Ahmeddiab1/TRI-MD_EVAL/1-HARDWARE/1-MD_EVAL/4-GENERATED/VALIDATION/DiffReport/ESC_GaN_CTRL.html

Altium

# Differences Report for Project ESC_CTRL.PrjPCB and ESC_GaN_CTRL.PcbDoc

Date: | | 5/20/2020
Time: | | 4:16:36 PM
Filename: | | C:\Users\TOWER_HOME\Documents\GitHub\TRI_ESC\1-HARDWARE\2-ESC_CTRL\4-GENERATED\VALIDATION\DiffReport\ESC_GaN_CTRL.html

## Extra Room Definitions

Schematic Object | PCB Object
[Room 1-MAIN (Scope=InComponentClass('1-MAIN')) TopLayer]
[Room U_2-BUCK_3V3_MCU (Scope=InComponentClass('U_2-BUCK_3V3_MCU')) TopLayer]
[Room U_3-MCU (Scope=InComponentClass('U_3-MCU')) TopLayer]
[Room U_4-JTAG (Scope=InComponentClass('U_4-JTAG')) TopLayer]
[Room U_5-CAN_TRANSCEIVER (Scope=InComponentClass('U_5-CAN_TRANSCEIVER')) TopLayer]
[Room U_6-MAVLINK_TRANSCEIVER (Scope=InComponentClass('U_6-MAVLINK_TRANSCEIVER')) TopLayer]
[Room U_7-CONNECTORS (Scope=InComponentClass('U_7-CONNECTORS')) TopLayer]
[Room U_8-MECHANICALS (Scope=InComponentClass('U_8-MECHANICALS')) TopLayer]
[Room U_11-PWM_INTERLOCK1 (Scope=InComponentClass('U_11-PWM_INTERLOCK1')) TopLayer]
[Room U_11-PWM_INTERLOCK2 (Scope=InComponentClass('U_11-PWM_INTERLOCK2')) TopLayer]
[Room U_11-PWM_INTERLOCK3 (Scope=InComponentClass('U_11-PWM_INTERLOCK3')) TopLayer]

Back to top

## Different Component Parameters

Schematic Object | PCB Object
[C1] | [C1]
[C1_U] | [C1_U]
[C1_V] | [C1_V]
[C1_W] | [C1_W]
[C2] | [C2]
[C2_U] | [C2_U]
[C2_V] | [C2_V]
[C2_W] | [C2_W]
[C3] | [C3]
[C3_U] | [C3_U]
[C3_V] | [C3_V]
[C3_W] | [C3_W]
[C4] | [C4]
[C5] | [C5]
[C6] | [C6]
[C7] | [C7]
[C8] | [C8]
[C9] | [C9]
[C10] | [C10]
[C11] | [C11]
[C12] | [C12]
[C13] | [C13]
[C14] | [C14]
[C15] | [C15]
[C16] | [C16]
[C17] | [C17]
[C18] | [C18]
[C19] | [C19]
[C20] | [C20]
[C21] | [C21]
[C22] | [C22]
[C23] | [C23]
[C24] | [C24]
[C25] | [C25]
[C26] | [C26]
[FB1] | [FB1]
[FB2] | [FB2]
[R1] | [R1]
[R1_U] | [R1_U]
[R1_V] | [R1_V]
[R1_W] | [R1_W]
[R2] | [R2]
[R3] | [R3]
[R4] | [R4]
[R5] | [R5]
[R6] | [R6]
[R7] | [R7]
[R8] | [R8]
[R9] | [R9]
[R10] | [R10]
[R11] | [R11]
[R12] | [R12]
[R13] | [R13]
[R14] | [R14]
[R15] | [R15]
[R16] | [R16]
[R17] | [R17]
[R18] | [R18]
[R19] | [R19]
[R20] | [R20]
[R21] | [R21]
[R22] | [R22]
[R23] | [R23]
[R24] | [R24]
[Rtr1] | [Rtr1]
[Rtr2] | [Rtr2]
[Rtr3] | [Rtr3]

Back to top
