Ahmeddiab1/TRI-MD_EVAL/1-HARDWARE/1-MD_EVAL/4-GENERATED/MANUFACTURE/Report Board Stack/ESC_GaN_CTRL.xls

Board Stack Report
Stack Up |  | Layer Stack
Layer | Board Layer Stack | Name | Material | Thickness | Constant
1 |  | Top Paste
2 |  | Top Overlay
3 |  | Top Solder | Solder Resist | 0.010mm | 3.5
4 |  | TOP_SIG_L1 | Copper | 0.035mm
5 |  | Dielectric1 | FR-4 | 0.127mm | 4.2
6 |  | TOP_GND_L2 | Copper | 0.035mm
7 |  | Dielectric 9 | FR-4 | 0.127mm | 4.2
8 |  | MID_PWR_L3 | Copper | 0.035mm
9 |  | Dielectric 8 | FR-4 | 0.254mm | 4.2
10 |  | MID_PWR_L4 | Copper | 0.035mm
11 |  | Dielectric 10 | FR-4 | 0.127mm | 4.2
12 |  | BOT_GND_L5 | Copper | 0.035mm
13 |  | Dielectric 2 | FR-4 | 0.127mm | 4.2
14 |  | BOT_SIG_L6 | Copper | 0.035mm
15 |  | Bottom Solder | Solder Resist | 0.010mm | 3.5
16 |  | Bottom Overlay
17 |  | Bottom Paste
 | Height : 0.992mm
