Ahmeddiab1/TRI-MD_EVAL/1-HARDWARE/1-MD_EVAL/0-ANNEXE/PIN_ASSIGNEMENT.PNG

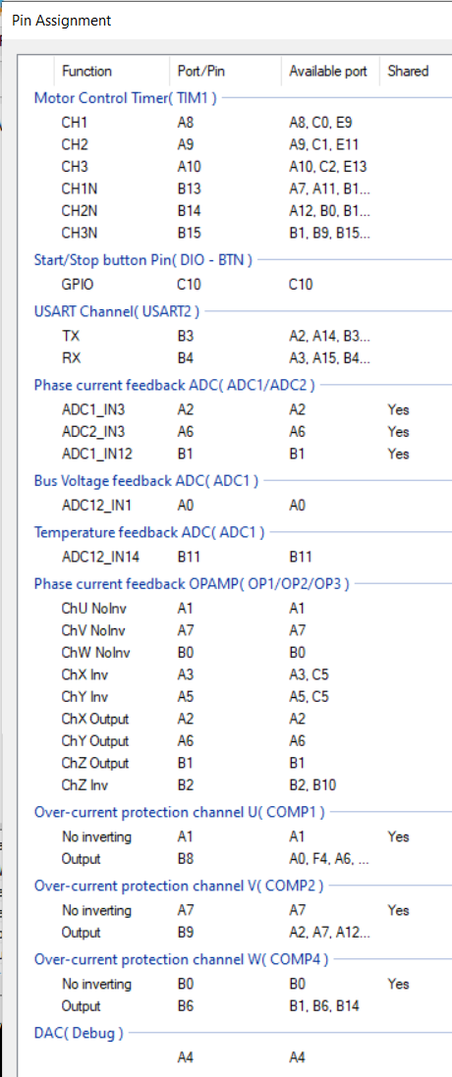
1-HARDWARE/1-MD_EVAL/0-ANNEXE/PIN_ASSIGNEMENT.PNG
