Ahmeddiab1/TRI-MD_EVAL/2-SOFTWARE/8-LOGICIEL/STSW-ESC001V1/ESC_STM32_FOC_FW/Web/MCLibrary/interface/common/1254211595.jpg

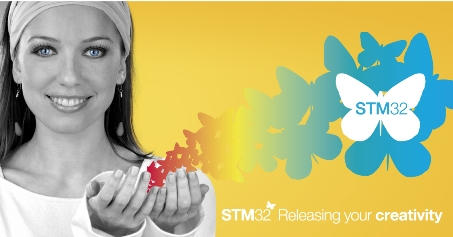
2-SOFTWARE/8-LOGICIEL/STSW-ESC001V1/ESC_STM32_FOC_FW/Web/MCLibrary/interface/common/1254211595.jpg
