Ahmeddiab1/TRI-MD_EVAL/2-SOFTWARE/8-LOGICIEL/STSW-ESC001V1/ESC_STMotorProfiler_addon/resources/assets/boardConfigs/images/STEVAL-ESC001V1_CB.png

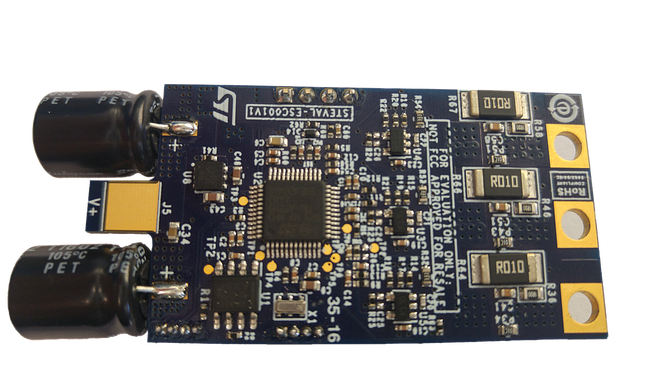
2-SOFTWARE/8-LOGICIEL/STSW-ESC001V1/ESC_STMotorProfiler_addon/resources/assets/boardConfigs/images/STEVAL-ESC001V1_CB.png
