Ahmeddiab1/TRI-MD_EVAL/2-SOFTWARE/8-LOGICIEL/STSW-ESC001V1/ESC_STMotorProfiler_addon/resources/assets/images/control/en_image_steval-ihm039v1.png

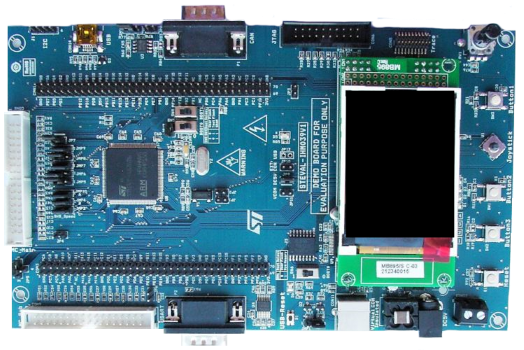
2-SOFTWARE/8-LOGICIEL/STSW-ESC001V1/ESC_STMotorProfiler_addon/resources/assets/images/control/en_image_steval-ihm039v1.png
