Ahmeddiab1/TRI-MD_EVAL/5-RESEARCH/3-SNIPPET/ESC_CTRL/hw/doc/png/PCB_00_RevA_3D.png

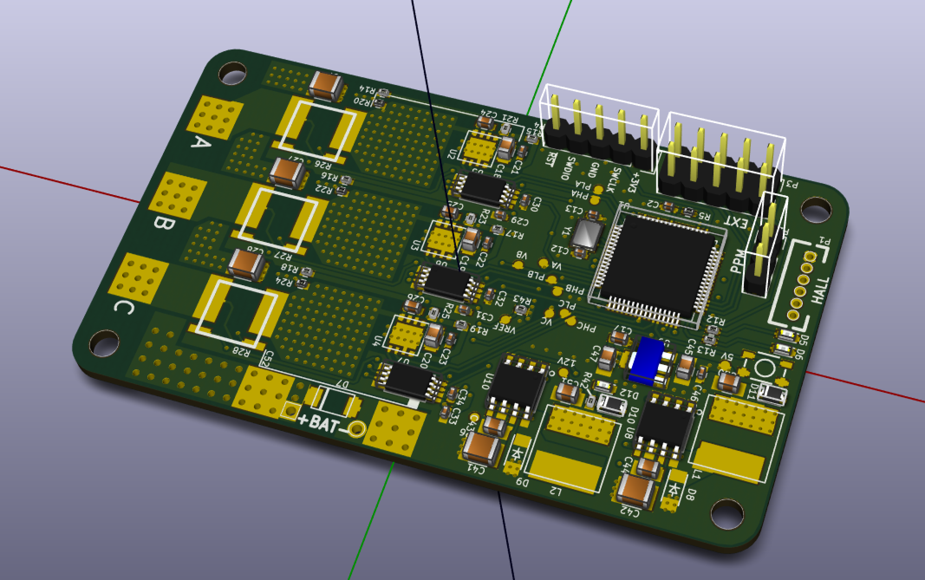
5-RESEARCH/3-SNIPPET/ESC_CTRL/hw/doc/png/PCB_00_RevA_3D.png
