Ahmeddiab1/TRI-MD_EVAL/1-HARDWARE/1-MD_EVAL/4-GENERATED/MANUFACTURE/BOM/BOM-ESC_CTRL.xlsx

Sheet: Part List Report
 | Component list |  | BOM for Project [ESC_CTRL.PrjPCB] (PCB Document : ESC_GaN_CTRL.PcbDoc)
 | Source Data From: |  | ESC_CTRL.PrjPCB
 | Project: |  | ESC_CTRL.PrjPCB
 | Variant: |  | None
 | Report Date: | 5/20/2020 | 3:45 PM
 | Print Date: | 2020-05-20 | 15:45:51
# | Designator | Supplier Part Number 1 | Quantity | Value | #Column Name Error:' Voltage | Footprint | Supplier 1 | #Column Name Error:' Fitted | Price
1 | B1, B2 | EG4389CT-ND | 2 |  |  | BUTTON_SINGLE_SIDE | Digi-Key
2 | CMC1 | 445-2033-2-ND | 1 |  |  | CMC_1210 | Digi-Key
3 | D1, D4, D5 | 160-1183-1-ND | 3 |  |  | LED 0603 | Digi-Key
4 | D1_U, D1_V, D1_W | 1497-1174-1-ND | 3 |  |  | LED 0402 | Digi-Key
5 | D2 | 732-4999-6-ND | 1 |  |  | LED_4PINS | Digi-Key
6 | D3 | 497-5550-1-ND | 1 |  |  | SOT323_3_0.8_2.9 | Digi-Key
7 | J1 | 952-2262-ND | 1 |  |  | PHT-102-01-S-S | Digi-Key
8 | J5, J6 | H126464-ND | 2 |  |  | DF13C-4P-1.25V | Digi-Key
9 | J7, J8, J9 | 609-3706-1-ND | 3 |  |  | FLE-105-01-G-DV | Digi-Key
10 | Q1 | 644-1321-1-ND | 1 |  |  | QUARTZ_1 | Digi-Key
11 | TVS1 | 497-15333-1-ND | 1 |  |  | SOT23_3_0.95_1.6 | Digi-Key
12 | TVS2 | CM1213-06MROSDKR-ND | 1 |  |  | MSOP_8_0.65_3.0 | Digi-Key
13 | U1 | 296-LMZM23600V3SILRCT-ND | 1 |  |  | MICROSIP-10 | Digi-Key
14 | U1_U, U1_V, U1_W | 296-18803-1-ND | 3 |  |  | DSBGA-6 | Digi-Key
15 | U2 | 296-11654-6-ND | 1 |  |  | SOIC-8_1.27_4 | Digi-Key
16 | U2_U, U2_V, U2_W | 296-18799-1-ND | 3 |  |  | DSBGA-8 | Digi-Key
17 | U3_U, U3_V, U3_W | 296-18803-1-ND | 3 |  |  | DSBGA-8 | Digi-Key
18 | U4 | 296-SN74LVC2G32YZPRCT-ND | 1 |  |  | DSBGA-8 | Digi-Key
19 | U5 | 497-STM32G474VEH6-ND | 1 |  |  | TFBGA-100 | Digi-Key
20 | U6 | 497-19072-1-ND | 1 |  |  | QFN8_2_2 | Digi-Key
21 | U7 | LM3480IM3X-3.3/NOPBCT-ND | 1 |  |  | SOT23_3_0.95_1.6 | Digi-Key
22 | C1, C3, C5, C8, C9, C10, C11, C21 | C0805 2.2nF 50V X7R SAMSUNG | 8 | 2.2uF |  | C 0805(2012)x0.65 | Comet |  | 0.026
23 | C1_U, C1_V, C1_W, C2_U, C2_V, C2_W, C3_U, C3_V, C3_W, C6, C7, C12, C13, C14, C15, C18, C19, C22, C23, C24 | C0402 100nF 50V X7R | 20 | 100nF |  | C 0402(1005)x0.5 | Comet |  | 0.039
24 | C2 | CE 10uF 50V SMD 105C Fujicon | 1 | 10uF |  | EL SMD D5 h5.4 | Comet |  | 0.106
25 | C4 | C1206 4.7uF 50V X7R SAMSUNG | 1 | 4.7uF |  | C 1206(3216)x1.6 | Comet |  | 0.29
26 | C16, C17, C20, C25, C26 | C0402 100nF 50V X7R | 5 | 47pF |  | C 0402(1005)x0.5 | Comet |  | 0.039
27 | FB1, FB2 | BLM21PG331SN1D | 2 | 0.525u |  | FB 0805(2012) | Comet |  | 0.032
28 | R1, R1_U, R1_V, R1_W, R8, R9, R16, R17 | R0402 1.0K 1% YAG/ASJ | 8 | 330 |  | R 0402(1005)-1% | Comet |  | 0.015
29 | R2, R3, R4, R5, R7, R10, R18, R19, R20, R21, R23, R24 | R0402 1.0K 1% YAG/ASJ | 12 | 100K |  | R 0402(1005)-1% | Comet |  | 0.015
30 | R6 | R0402 1.0K 1% YAG/ASJ | 1 | 120 |  | R 0402(1005)-1% | Comet |  | 0.015
31 | R11, R14, R15 | R0402 1.0K 1% YAG/ASJ | 3 | 1K |  | R 0402(1005)-1% | Comet |  | 0.015
32 | R12, R13 | R0402 1.0K 1% YAG/ASJ | 2 | 10K |  | R 0402(1005)-1% | Comet |  | 0.015
33 | R22 | R0402 1.0K 1% YAG/ASJ | 1 | 100 |  | R 0402(1005)-1% | Comet |  | 0.015
34 | Rtr1, Rtr2, Rtr3 | TC33X-2 1K | 3 | 10K |  | Rtr SMD3 | Comet |  | 0.23
Approved |  |  | Notes |  |  |  |  |  | 102

Sheet: Project Information
Column1 | Column2
Project Full Path | C:\Users\TOWER_HOME\Documents\GitHub\TRI_ESC\1-HARDWARE\2-ESC_CTRL\ESC_CTRL.PrjPCB
Project Filename | ESC_CTRL.PrjPCB
Variant Name | None
Data-Source Filename | ESC_CTRL.PrjPCB
Data-Source Full Path | C:\Users\TOWER_HOME\Documents\GitHub\TRI_ESC\1-HARDWARE\2-ESC_CTRL\ESC_CTRL.PrjPCB
Title | BOM for Project [ESC_CTRL.PrjPCB] (PCB Document : ESC_GaN_CTRL.PcbDoc)
Total Quantity | 102
Report Time | 3:45 PM
Report Date | 5/20/2020
Report Date & Tine | 5/20/2020 3:45 PM
Output Name | BOM
Output Type | BOM_PartType
Output Generator Name | BOM
Output Generator Description | Bill of Materials
