Ahmeddiab1/TRI-MD_EVAL/1-HARDWARE/1-MD_EVAL/4-GENERATED/PROD/BOM/BOM_ESC_CTRL.xlsx

Designator | Supplier Part Number 1 | Quantity | Value | Manufacturer Number | Footprint | Supplier 1 | Fitted | UNI NOTES ONLY
B1, B2 | EG4389CT-ND | 2 |  | TL3330AF260QG | BUTTON_SINGLE_SIDE | Digi-Key |  | CHECKED
CMC1 | 445-2033-2-ND | 1 |  | ACM3225-102-2P-T001 | CMC_1210 | Digi-Key |  | CHECKED
D1, D4, D5 | 160-1183-1-ND | 3 |  | LTST-C190GKT | LED 0603 | Digi-Key | DNP | CHECKED
D1_U, D1_V, D1_W | 1497-1174-1-ND | 3 |  | XZMDK68W-2 | LED 0402 | Digi-Key |  | CHECKED
D2 | 732-4999-6-ND | 1 |  | 150141RB73100 | LED_4PINS | Digi-Key |  | CHECKED
D3 | 497-5550-6-ND | 1 |  | BAT30CWFILM | SOT323_3_0.8_2.9 | Digi-Key |  | CHECKED
J1 | 952-2262-ND | 1 |  | M20-9990246 | PHT-102-01-S-S | Digi-Key | DNP | CHECKED
J5, J6 | H126464-ND | 2 |  | DF13C-4P-1.25V(75) | DF13C-4P-1.25V | Digi-Key | DNP | CHECKED
J7, J8, J9 | 609-3706-1-ND | 3 |  | 20021321-00010C4LF | FLE-105-01-G-DV | Digi-Key | DNP | CHECKED
Q1 | SER4252DKR-ND | 1 |  | FA-238 24.0000MD30X-W5 | QUARTZ_1 | Digi-Key |  | CHECKED
TVS1 | 497-15333-6-ND | 1 |  | ESDCAN01-2BLY | SOT23_3_0.95_1.6 | Digi-Key |  | CHECKED
TVS2 | CM1213-06MROSDKR-ND | 1 |  | CM1213-06MR | MSOP_8_0.65_3.0 | Digi-Key |  | CHECKED
U1 | 296-LMZM23600V3SILRDKR-ND | 1 |  | LMZM23600V3SILR | MICROSIP-10 | Digi-Key |  | CHECKED
U1_U, U1_V, U1_W | 296-18803-6-ND | 3 |  | SN74LVC2G14YZPR | DSBGA-6 | Digi-Key |  | CHECKED
U2 | 296-11654-6-ND | 1 |  | SN65HVD230DR | SOIC-8_1.27_4 | Digi-Key |  | CHECKED
U2_U, U2_V, U2_W | 296-18799-6-ND | 3 |  | SN74LVC2G02YZPR | DSBGA-8 | Digi-Key |  | CHECKED
U3_U, U3_V, U3_W | 296-14371-6-ND | 3 |  | SN74LVC2G08YZPR | DSBGA-8 | Digi-Key |  | CHECKED
U4 | 296-SN74LVC2G32YZPRCT-ND | 1 |  | SN74LVC2G32YZPR | DSBGA-8 | Digi-Key |  | CHECKED
U5 | 497-STM32G474VEH6-ND | 1 |  | STM32G474VEH6 | TFBGA-100 | Digi-Key |  | CHECKED
U6 | 497-19072-1-ND | 1 |  | TS3333AQPR | QFN8_2_2 | Digi-Key |  | CHECKED
U7 | LM3480IM3X-3.3/NOPBCT-ND | 1 |  | LM3480IM3X-3.3/NOPB | SOT23_3_0.95_1.6 | Digi-Key |  | CHECKED
C1, C5, C8, C9, C10, C11, C21 | 399-11941-6-ND | 8 | 2.2uF | C0805C225K3RAC7800 | C 0805(2012)x0.65 | Digi-Key |  | CHECKED
C1_U, C1_V, C1_W, C2_U, C2_V, C2_W, C3_U, C3_V, C3_W, C6, C7, C12, C13, C14, C15, C18, C19, C22, C23, C24 | 1276-1004-6-ND | 20 | 100nF | CL05F104ZO5NNNC | C 0402(1005)x0.5 | Digi-Key |  | CHECKED
C2 | 565-2129-6-ND (https://www.digikey.com/product-detail/en/united-chemi-con/EMVA500ADA100ME55G/565-2129-6-ND/1959446) | 1 | 10uF | EMVA500ADA100ME55G | EL SMD D5 h5.4 | Digi-Key |  | CHECKED
C3 | 399-4925-6-ND | 1 | 10uF | C0805C106K8PACTU | C 0805(2012)x0.65 | Digi-Key |  | CHECKED
C4 | 399-12290-6-ND | 1 | 22uF | C1206C226M4PAC7800 | C 1206(3216)x1.6 | Digi-Key |  | CHECKED
C16, C17, C20, C25, C26 | 490-5942-6-ND | 5 | 47pF | GRM1555C1H470JA01D | C 0402(1005)x0.5 | Digi-Key |  | CHECKED
FB1, FB2 | BLM21PG331SN1D | 2 | 0.525u | BLM21PG331SN1D | FB 0805(2012) | Digi-Key |  | CHECKED
R1, R1_U, R1_V, R1_W, R8, R9, R16, R17 | A130349DKR-ND | 8 | 330 | CRGP0402F330R | R 0402(1005)-1% | Digi-Key |  | CHECKED
R2, R3, R4, R5, R7, R10, R18, R19, R20, R21, R23, R24 | 311-100KLRDKR-ND | 12 | 100K | RC0402FR-07100KL | R 0402(1005)-1% | Digi-Key |  | CHECKED
R6, R22 | 2019-RK73H1ETTP1200FDKR-ND | 2 | 120 | RK73H1ETTP1200F | R 0402(1005)-1% | Digi-Key |  | CHECKED
R11, R14, R15 | A129627DKR-ND | 3 | 1K | CRGCQ0402F1K0 | R 0402(1005)-1% | Digi-Key |  | CHECKED
R12, R13 | 541-3959-6-ND | 2 | 10K | CRCW040210K0FKEDC | R 0402(1005)-1% | Digi-Key |  | CHECKED
Rtr1, Rtr2, Rtr3 | TC33X-2-504EDKR-ND | 3 | 500K | TC33X-2-504E | Rtr SMD3 | Digi-Key |  | CHECKED
