Ahmeddiab1/TRI-MD_EVAL/1-HARDWARE/1-MD_EVAL/4-GENERATED/PROD/ReportComponents/COMPONENT_CROSS_REF.xlsx

Comment | Description | Designator | Footprint | LibRef | Quantity
PHT-102-01-S-S | MAL 2 PIN 2.54 SINGLE ROW | J1 | PHT-102-01-S-S | PHT-102-01-S-S | 1
2.2uF, 10uF, 22uF, LED 0603, 330, MICROSIP | SMD-0805 50V X7R 10%, SMD D5mm h5.4mm, SMD-1206 50V X7R 10%, LED SMD 0603, SMD 0402 0.063W 1% 50V, V3 DCDC 3V3 500mA | C1, C2, C3, C4, D1, R1, U1 | C 0805(2012)x0.65, EL SMD D5 h5.4, C 1206(3216)x1.6, LED 0603, R 0402(1005)-1%, MICROSIP-10 | CAP 0805 2.2nF 50V X7R, EL 10uF 50V +105°C, CAP 1206 4.7uF 50V X7R, LED 0603, RES 0402-1%, LMZM23600 | 7
PUSH BUTT SINGLE SIDE, 100nF, 2.2uF, 47pF, LED 0603, 0.525u, OSC NX2016, 100K, 1K, 10K, 330, 120, DSBGA8, STM32 TFBGA 100, QFN8, SOT23 | BUTTON SINGLE SIDE SMD, SMD-0402 100nF 50V X7R 10%, SMD-0805 50V X7R 10%, LED SMD 0603, SMD 0805 1.5A 330Ω/90mΩ, OSC NX2016 24MHz, SMD 0402 0.063W 1% 50V, SMD Trimpot 3mm 0.1W 25%, OR DUAL, TFBGA100, REF VOLTAGE 3V3 -- DETROMPEUR WRONG DIRECTION, LDO 3V3 VIN 35V | B1, B2, C7, C8, C9, C10, C11, C12, C13, C14, C15, C16, C17, C18, C19, C20, C21, C22, C23, C24, C25, C26, D4, D5, FB1, FB2, Q1, R10, R11, R12, R13, R14, R15, R16, R17, R18, R19, R20, R21, R22, R23, R24, Rtr1, Rtr2, Rtr3, U4, U5, U6, U7 | BUTTON_SINGLE_SIDE, C 0402(1005)x0.5, C 0805(2012)x0.65, LED 0603, FB 0805(2012), QUARTZ_1, R 0402(1005)-1%, Rtr SMD3, DSBGA-8, TFBGA-100, QFN8_2_2, SOT23_3_0.95_1.6 | PUSH BUTT SINGLE SIDE, CAP 0402 100nF 50V X7R, CAP 0805 2.2nF 50V X7R, LED 0603, FB BLM21P, OSC NX2016, RES 0402-1%, RES Trim TC33X-2, SN74LVC2G32_BGA, STM32G474VEH6, TS33, LM3480 | 49
100K | SMD 0402 0.063W 1% 50V | R2, R3, R4, R5 | R 0402(1005)-1% | RES 0402-1% | 4
2.2uF, 100nF, TCM0403S, DF13C-4P-1.25V, 120, 100K, SOT23, SOIC8 | SMD-0805 50V X7R 10%, SMD-0402 100nF 50V X7R 10%, CMC 200mA 1K @100MHz 1210, HEADER MALE 4P 1.25 PITCH UP RIGHT, SMD 0402 0.063W 1% 50V, TVS CAN PROTECT, CAN TRANSCIEVER | C5, C6, CMC1, J5, R6, R7, TVS1, U2 | C 0805(2012)x0.65, C 0402(1005)x0.5, CMC_1210, DF13C-4P-1.25V, R 0402(1005)-1%, SOT23_3_0.95_1.6, SOIC-8_1.27_4 | CAP 0805 2.2nF 50V X7R, CAP 0402 100nF 50V X7R, TCM0403S, DF13C-4P-1.25V, RES 0402-1%, ESDCAN01, SN65HVD230 | 8
PLCC, DF13C-4P-1.25V, 330 | BI COLOR LED BLUE-RED, HEADER MALE 4P 1.25 PITCH UP RIGHT, SMD 0402 0.063W 1% 50V | D2, J6, R8, R9 | LED_4PINS, DF13C-4P-1.25V, R 0402(1005)-1% | LED BICOLOR, DF13C-4P-1.25V, RES 0402-1% | 4
SOD523, FLE-105-G-DV, MSOP8 | SCHOTTKY 30V 300mA DUAL COMMON CATHODE, FEM 10 PIN 1.27 DOUBLE ROW SMD, TVS STERRING ARRAY | D3, J7, J8, J9, TVS2 | SOT323_3_0.8_2.9, FLE-105-01-G-DV, MSOP_8_0.65_3.0 | BAT30_DUAL, FLE-105-G-DV, CM1213 | 5
100nF, 0402, 330, DSGBA6, DSBGA8, DSGBA8 | SMD-0402 100nF 50V X7R 10%, LED SMD 0402, SMD 0402 0.063W 1% 50V, INV DUAL SCHMITT, NOR DUAL, AND DUAL SCHMITT | C1_U, C1_V, C1_W, C2_U, C2_V, C2_W, C3_U, C3_V, C3_W, D1_U, D1_V, D1_W, R1_U, R1_V, R1_W, U1_U, U1_V, U1_W, U2_U, U2_V, U2_W, U3_U, U3_V, U3_W | C 0402(1005)x0.5, LED 0402, R 0402(1005)-1%, DSBGA-6, DSBGA-8 | CAP 0402 100nF 50V X7R, LED 0402, RES 0402-1%, SN74LVC2G14_BGA, SN74LVC2G02_BGA, SN74LVC2G08_BGA | 24
