Ahmeddiab1/TRI-MD_EVAL/5-RESEARCH/1-EVM/ESC_G431/MB1419-G431CB-B01_BOM.xlsx

 |  | PROJECT NAME: PROT-ESC-G4 |  |  |  |  |  | POW CODE: | MC.3PH0055.17 | 2018-11-23
 |  | Schematic ver. 021 |  | BILL OF MATERIALS
 |  |  |  |  |  | MANUFACTURER |  | Supplier Advices-Not Mandatory |  | MORE INFO
ITEM | QUANTITY | Reference | Part / Value | GLOBAL INFORMATION | Package | Manufacturer | Manufacturer’s ordering code / Orderable Part Number | SUPPLIER - DISTRIBUTOR | SUPPLIER - DISTRIBUTOR CODE | In the Items indicated with "ANY" you can use any Manufacturer | Provided by | ECCN_US | ECCN_EU
1 | 15 | C1 C2 C3 C4 C5 C9 C13 C17 C18 C20 C21 C22 C23 C24 C70 | 0.1uF | CAP CER 0.1UF 16V X7R 0402 | 0402 (1005 Metric) | Wurth Electronics Inc. | 885012205037 | Digi-Key | 732-7532-2-ND | ANY | SUBCO | NA | NA
2 | 1 | C6 | 10uF | CAP CER 10UF 16V X5R 0805 | 0805 (2012 Metric) | Wurth Electronics Inc. | 885012107014 | Digi-Key | 732-7624-1-ND | ANY | SUBCO | NA | NA
3 | 1 | C7 | 4.7uF | CAP CER 4.7UF 16V X5R 0805 | 0805 (2012 Metric) | Wurth Electronics Inc. | 885012107013 | Digi-Key | 732-7623-1-ND | ST-SUPPLY | SUBCO with ST control | NA | NA
4 | 1 | C8 | 100pF | CAP CER 100PF 10V C0G/NP0 0402 | 0402 (1005 Metric) | Wurth Electronics Inc. | 885012005013 | Digi-Key | 732-7431-1-ND | ANY | SUBCO | NA | NA
5 | 5 | C10 C11 C67 C68 C69 | 10pF | CAP CER 10PF 10V C0G/NP0 0402 | 0402 (1005 Metric) | Wurth Electronics Inc. | 885012005007 | Digi-Key | 732-7425-1-ND | ST-SUPPLY | SUBCO with ST control | NA | NA
6 | 1 | C12 | N.M. | CAP CER 0402-NOT MOUNTED | 0402 (1005 Metric) | NOT ASSEMBLY | NOT ASSEMBLY |  |  | NOT ASSEMBLY |  | NA | NA
7 | 2 | C14 C16 | 1 uF | CAP CER 1UF 16V X5R 0603 | 0603 (1608 Metric) | Yageo | CC0603KRX5R7BB105 | Digi-Key | 311-1444-1-ND |  | SUBCO | NA | NA
8 | 1 | C15 | 0.1uF | CAP CER 0.1UF 16V X7R 0603 | 0603 (1608 Metric) | Wurth Electronics Inc. | 885012206046 | Digi-Key | 732-7965-1-ND | ANY | SUBCO | NA | NA
9 | 1 | C19 | 4.7uF | CAP CER 4.7UF 10V X5R 0603 | 0603 (1608 Metric) | Wurth Electronics Inc. | 885012106012 | Digi-Key | 732-7909-1-ND | ANY | SUBCO | NA | NA
10 | 3 | C25 C56 C63 | 1uF | CAP CER 1UF 25V X5R 0402 | 0402 (1005 Metric) | Murata Electronics North America | GRM155R61E105KA12D | Digi-Key | 490-10017-1-ND |  | SUBCO | NA | NA
11 | 1 | C26 | 10nF | CAP CER 10000PF 16V X7R 0402 | 0402 (1005 Metric) | Wurth Electronics Inc. | 885012205031 | Digi-Key | 732-7526-1-ND | ANY | SUBCO | NA | NA
12 | 14 | C27 C28 C29 C30 C31 C32 C33 C34 C35 C36 C37 C38 C39 C40 | 15uF | CAP CER 15UF 35V X5R 0805 | 0805 (2012 Metric) | TDK Corporation | C2012X5R1V156M125AC | Digi-Key | 445-14423-2-ND |  | SUBCO | NA | NA
13 | 1 | C41 | 0.22uF | CAP CER 0.22UF 50V X7R 0603 | 0603 (1608 Metric) | TDK Corporation | CGA3E3X7R1H224K080AD | Digi-Key | 445-9837-1-ND |  | SUBCO | NA | NA
14 | 1 | C42 | 3.9nF | CAP CER 3900PF 16V X7R 0402 | 0402 (1005 Metric) | KEMET | C0402C392K4RAC7867 | Digi-Key | 399-14452-1-ND |  | SUBCO | NA | NA
15 | 3 | C43 C52 C58 | 1uF | CAP CER 1UF 25V X7R 0603 | 0603 (1608 Metric) | Wurth Electronics Inc. | 885012206076 | Digi-Key | 732-7994-1-ND | ANY | SUBCO | NA | NA
16 | 1 | C44 | 10uF | CAP CER 10UF 50V X7R 1206 | 1206 (3216 Metric) | Samsung Electro-Mechanics America, Inc. | CL31B106KBHNNNE | Digi-Key | 1276-6767-1-ND |  | SUBCO | NA | NA
17 | 1 | C45 | 22uF | CAP CER 22UF 25V X5R 1206 | 1206 (3216 Metric) | Murata Electronics North America | GRT31CR61E226ME01L | Digi-Key | 490-12451-1-ND |  | SUBCO | NA | NA
18 | 1 | C46 | 27pF | CAP CER 27PF 25V C0G/NP0 0402 | 0402 (1005 Metric) | Murata Electronics North America | GRM1555C1E270JA01D | Digi-Key | 490-6176-1-ND |  | SUBCO | NA | NA
19 | 6 | C47 C48 C53 C54 C60 C61 | 100pF | CAP CER 100PF 25V X7R 0402 | 0402 (1005 Metric) | Wurth Electronics Inc. | 885012205038 | Digi-Key | 732-7533-1-ND | ANY | SUBCO | NA | NA
20 | 3 | C49 C55 C62 | 470nF | CAP CER 0.47UF 25V X7R 0603 | 0603 (1608 Metric) | Wurth Electronics Inc. | 885012206075 | Digi-Key | 732-7993-1-ND | ST-SUPPLY | SUBCO with ST control | NA | NA
21 | 1 | C50 | 4.7nF | CAP CER 4700PF 16V X7R 0402 | 0402 (1005 Metric) | Wurth Electronics Inc. | 885012205029 | Digi-Key | 732-7524-1-ND | ST-SUPPLY | SUBCO with ST control | NA | NA
22 | 3 | C51 C59 C65 | 10nF | CAP CER 10000PF 100V X7R 0603 | 0603 (1608 Metric) | TDK Corporation | C1608X7R2A103M080AA | Digi-Key | 445-1305-1-ND |  | SUBCO | NA | NA
23 | 2 | C57 C64 | 2.2uF | CAP CER 2.2UF 10V X5R 0402 | 0402 (1005 Metric) | Wurth Electronics Inc. | 885012105013 | Digi-Key | 732-7490-1-ND | ANY | SUBCO | NA | NA
24 | 1 | C66 | 10nF | CAP CER 10000PF 10V X7R 0402 | 0402 (1005 Metric) | Wurth Electronics Inc. | 885012205012 | Digi-Key | 732-7507-2-ND | ANY | SUBCO | NA | NA
25 | 1 | D1 | STPS1L20MF | DIODE SCHOTTKY 20V 1A STMITEFLAT | DO-222AA | STMicroelectronics | STPS1L20MF | Digi-Key | 497-8024-1-ND | ST-SUPPLY | SUBCO with ST control | EAR99 | NEC
26 | 1 | D2 | LED GREEN RED | LED GREEN/RED CLEAR 4PLCC SMD | 4-PLCC | Wurth Electronics Inc. | 150141RV73100 | Digi-Key | 732-5001-1-ND | ST-SUPPLY | SUBCO with ST control | EAR99 | NEC
27 | 2 | D3 D5 | LNJ347W83RA | LED GREEN 0402 SMD | 0402 (1005 Metric) | Panasonic Electronic Components | LNJ347W83RA | Digi-Key | LNJ347W83RATR-ND |  | SUBCO | EAR99 | NEC
28 | 1 | D4 | LED RED | DIO, Rectangle with Flat Top, 1.00mm x 0.50mm, VLMS1500-GS08, 20mA, --, --, 0402 (1005 Metric) | 0402 (1005 Metric) | Vishay Semiconductor Opto Division | VLMS1500-GS08 | Digi-Key | VLMS1500-GS08TR-ND |  | SUBCO | EAR99 | NEC
29 | 3 | D6 D8 D9 | STPS0560Z | DIODE SCHOTTKY 60V 500MA SOD123 | SOD-123 | STMicroelectronics | STPS0560Z | Digi-Key | 497-3787-1-ND | ST-SUPPLY | SUBCO with ST control | EAR99 | NEC
30 | 1 | D7 | STPS1L40M | DIODE SCHOTTKY 40V 1A STMITE | DO-216AA | STMicroelectronics | STPS1L40M | Digi-Key | 497-3212-1-ND | ST-SUPPLY | SUBCO with ST control | EAR99 | NEC
31 | 10 | D10 D11 D12 D13 D14 D15 D16 D17 D18 D19 | BAT30KFILM | DIODE SCHOTTKY 30V 300MA SOD523 | SC-79, SOD-523 | STMicroelectronics | BAT30KFILM | Digi-Key | 497-5552-2-ND | ST-SUPPLY | SUBCO with ST control | EAR99 | NEC
32 | 1 | D20 | SMM4F26A | 400 W TVS in STmite Flat | DO216-AA-FLAT | STMicroelectronics | SMM4F26A-TR | Mouser | 511-SMM4F26A-TR | ST-SUPPLY | SUBCO with ST control | EAR99 | NEC
32 | 1 | F1 | 250mA | FUSE BOARD MNT 250MA 32VDC 0402 | 0.039" L x 0.020" W x 0.013" H (0.99mm x 0.51mm x 0.33mm) | Littelfuse Inc. | 0435.250KRS | Digi-Key | F3785CT-ND |  | SUBCO | EAR99 | NEC
33 | 1 | J1 | CAN | SOLDER PADS |  |  |  |  |  | NOT ASSEMBLY |  | NA | NA
34 | 1 | J2 | SWD STLINK | SOLDER PADS |  |  |  |  |  | NOT ASSEMBLY |  | NA | NA
35 | 1 | J3 | PWM | SOLDER PADS |  |  |  |  |  | NOT ASSEMBLY |  | NA | NA
36 | 1 | J4 | SWD-PAD | SOLDER PADS |  |  |  |  |  | NOT ASSEMBLY |  | NA | NA
37 | 1 | J5 | CON1 | SOLDER PADS |  |  |  |  |  | NOT ASSEMBLY |  | NA | NA
38 | 1 | J6 | CON1 | SOLDER PADS |  |  |  |  |  | NOT ASSEMBLY |  | NA | NA
39 | 1 | J7 | Motor | SOLDER PADS |  |  |  |  |  | NOT ASSEMBLY |  | NA | NA
40 | 1 | J8 | SOLDER PAD | SOLDER PADS |  |  |  |  |  | NOT ASSEMBLY |  | NA | NA
41 | 3 | JP1 JP2 JP3 | SHORT | 2 PIN SHORTED TO CONNECT DIFFERENT NETS |  |  |  |  |  | NOT ASSEMBLY |  | NA | NA
42 | 1 | L1 | 600 Ohms@100MHz | FERRITE BEAD 600 OHM 0402 1LN | 0402 (1005 Metric) | Murata Electronics North America | BLM15BX601SN1D | Digi-Key | 490-11019-1-ND |  | SUBCO | EAR99 | NEC
43 | 1 | L2 | 33uH | Fixed Inductors LPS4018 Low Profile 33uH 0.8A 20% SMD | 3.9x3.9x1.7 | Coilcraft | LPS4018-333MRB | Mouser | 994-LPS4018-333MRB |  | SUBCO | EAR99 | NEC
44 | 1 | Q1 | 2STR1160 | TRANS NPN 60V 1A SOT-23 | TO-236-3, SC-59, SOT-23-3 | STMicroelectronics | 2STR1160 | Digi-Key | 497-6960-1-ND | ST-SUPPLY | SUBCO with ST control | EAR99 | NEC
45 | 6 | Q2 Q3 Q4 Q5 Q6 Q7 | STL180N6F7 | N-channel 60 V, 1.9 mO typ., 120 A STripFET™ F7 | PowerFLAT 5x6 | STMicroelectronics | STL180N6F7 |  |  | ST-SUPPLY | SUBCO with ST control | EAR99 | NEC
46 | 1 | R1 | 120 | RES SMD 120 OHM 1% 1/16W 0402 | 0402 (1005 Metric) | Yageo | RC0402FR-07120RL | Digi-Key | 311-120LRCT-ND |  | SUBCO | NA | NA
47 | 1 | R2 | 10k | TRIMMER 10K OHM 0.5W PC PIN | Square - 0.375" x 0.375" Face x 0.190" H (9.53mm x 9.53mm x 4.83mm) | Bourns Inc. | 3386P-1-103TLF | Digi-Key | 3386P-103TLF-ND |  | SUBCO | EAR99 | NEC
48 | 15 | R3 R10 R12 R16 R35 R39 R41 R45 R46 R48 R52 R53 R71 R72 R73 | 10k | RES SMD 10K OHM 1% 1/16W 0402 | 0402 (1005 Metric) | Yageo | RC0402FR-0710KL | Digi-Key | 311-10.0KLRTR-ND |  | SUBCO | NA | NA
49 | 5 | R4 R8 R9 R18 R20 | 100 | RES SMD 100 OHM 1% 1/16W 0402 | 0402 (1005 Metric) | TE Connectivity Passive Product | CRG0402F100R | Digi-Key | A121527TR-ND |  | SUBCO | NA | NA
50 | 4 | R5 R67 R69 R70 | 1.5k | RES SMD 1.5K OHM 1% 1/16W 0402 | 0402 (1005 Metric) | Yageo | RC0402FR-071K5L | Digi-Key | 311-1.50KLRTR-ND |  | SUBCO | NA | NA
51 | 1 | R6 | 36k | RES SMD 36K OHM 1% 1/16W 0402 | 0402 (1005 Metric) | Yageo | RC0402FR-0736KL | Digi-Key | 311-36.0KLRCT-ND |  | SUBCO | NA | NA
52 | 3 | R7 R13 R15 | 100k | RES SMD 100K OHM 1% 1/16W 0402 | 0402 (1005 Metric) | TE Connectivity Passive Product | CRG0402F100K | Digi-Key | A121526TR-ND |  | SUBCO | NA | NA
53 | 2 | R11 R26 | 0 | RES SMD 0 OHM JUMPER 1/16W 0402 | 0402 (1005 Metric) | Vishay Dale | CRCW04020000Z0ED | Digi-Key | 541-0.0JTR-ND |  | SUBCO | NA | NA
54 | 1 | R14 | 2.7k | RES SMD 2.7K OHM 1% 1/16W 0402 | 0402 (1005 Metric) | Yageo | RC0402FR-072K7L | Digi-Key | 311-2.70KLRCT-ND |  | SUBCO | NA | NA
55 | 1 | R17 | N.M. | RES SMD 0402 - NOT MOUNTED | 0402 (1005 Metric) |  |  |  |  | NOT ASSEMBLY |  | NA | NA
56 | 4 | R19 R22 R30 R60 | 4.7k | RES SMD 4.7K OHM 1% 1/16W 0402 | 0402 (1005 Metric) | TE Connectivity Passive Product | CRG0402F4K7 | Digi-Key | A121542TR-ND |  | SUBCO | NA | NA
57 | 1 | R21 | 1k | RES SMD 1K OHM 1% 1/16W 0402 | 0402 (1005 Metric) | Yageo | RC0402FR-071KL | Digi-Key | 311-1.00KLRCT-ND |  | SUBCO | NA | NA
58 | 2 | R23 R24 | 0 | RES SMD 0 OHM JUMPER 1/10W 0603 | 0603 (1608 Metric) | Panasonic Electronic Components | ERJ-3GEY0R00V | Digi-Key | P0.0GTR-ND |  | SUBCO | NA | NA
59 | 1 | R27 | 220 | RES SMD 220 OHM 1% 1/16W 0402 | 0402 (1005 Metric) | Yageo | RC0402FR-07220RL | Digi-Key | 311-220LRCT-ND |  | SUBCO | NA | NA
60 | 2 | R28 R29 | 510 | RES SMD 510 OHM 1% 1/16W 0402 | 0402 (1005 Metric) | Yageo | RC0402FR-07510RL | Digi-Key | 311-510LRCT-ND |  | SUBCO | NA | NA
61 | 1 | R31 | 62 | RES SMD 62 OHM 1% 1/16W 0402 | 0402 (1005 Metric) | Yageo | RC0402FR-0762RL | Digi-Key | 311-62.0LRCT-ND |  | SUBCO | NA | NA
62 | 1 | R32 | 34.8k | RES SMD 34.8K OHM 1% 1/16W 0402 | 0402 (1005 Metric) | Yageo | RC0402FR-0734K8L | Digi-Key | YAG3125CT-ND |  | SUBCO | NA | NA
63 | 1 | R33 | 300 | RES SMD 300 OHM 1% 1/16W 0402 | 0402 (1005 Metric) | Yageo | RC0402FR-07300RL | Digi-Key | 311-300LRCT-ND |  | SUBCO | NA | NA
64 | 6 | R34 R38 R40 R43 R47 R50 | 33 | RES SMD 33 OHM 1% 1/10W 0603 | 0603 (1608 Metric) | Yageo | 9C06031A33R0FKHFT | Digi-Key | 311-33.0HDKR-ND |  | SUBCO | NA | NA
65 | 1 | R36 | 8.2k | RES SMD 8.2K OHM 5% 1/16W 0402 | 0402 (1005 Metric) | Yageo | RC0402JR-078K2L | Digi-Key | 311-8.2KJRTR-ND |  | SUBCO | NA | NA
66 | 3 | R37 R44 R51 | 1 | RES SMD 1 OHM 5% 1/8W 0805 | 0805 (2012 Metric) | Panasonic Electronic Components | ERJ-6GEYJ1R0V | Digi-Key | P1.0ACT-ND |  | SUBCO | NA | NA
67 | 1 | R42 | 52.3k | RES SMD 52.3K OHM 1% 1/16W 0402 | 0402 (1005 Metric) | Samsung Electro-Mechanics | RC1005F5232CS | Digi-Key | 1276-4179-1-ND |  | SUBCO | NA | NA
68 | 1 | R49 | 30.9k | RES SMD 30.9K OHM 1% 1/10W 0402 | 0402 (1005 Metric) | Panasonic Electronic Components | ERJ-2RKF3092X | Digi-Key | P30.9KLCT-ND |  | SUBCO | NA | NA
69 | 3 | R54 R55 R56 | 0.003 | RES 0.003 OHM 1% 3W 2512 | 2512 (6432 Metric) | TE Connectivity Passive Product | TLR3A30DR003FTDG | Farnell | 2116034RL |  | SUBCO | NA | NA
70 | 3 | R57 R58 R59 | 2.2k | RES SMD 2.2K OHM 1% 1/16W 0402 | 0402 (1005 Metric) | Yageo | RC0402FR-072K2L | Digi-Key | 311-2.20KLRCT-ND |  | SUBCO | NA | NA
71 | 3 | R61 R62 R63 | 10k | RES SMD 10K OHM 1% 1/10W 0603 | 0603 (1608 Metric) | Yageo | RC0603FR-0710KL | Digi-Key | 311-10.0KHRCT-ND |  | SUBCO | NA | NA
72 | 1 | R68 | 169k | RES SMD 169K OHM 1% 1/16W 0402 | 0402 (1005 Metric) | Yageo | RC0402FR-07169KL | Digi-Key | YAG3000CT-ND |  | SUBCO | NA | NA
73 | 3 | R74 R75 R77 | 1.8k | RES SMD 1.8K OHM 1% 1/16W 0402 | 0402 (1005 Metric) | Yageo | RC0402FR-071K8L | Digi-Key | 311-1.80KLRTR-ND |  | SUBCO | NA | NA
74 | 1 | R76 | 18k | RES SMD 18K OHM 1% 1/16W 0402 | 0402 (1005 Metric) | Yageo | RC0402FR-0718KL | Digi-Key | 311-18.0KLRCT-ND |  | SUBCO | NA | NA
75 | 1 | RT1 | 10k | NTC THERMISTOR 10K OHM 1% 0402 | 0402 (1005 Metric) | TDK Corporation | NTCG103JF103FT1 | Digi-Key | 445-2550-1-ND |  | SUBCO | EAR99 | NEC
76 | 3 | R64 R65 R66 | 22k | RES SMD 22K OHM 1% 1/16W 0402 | 0402 (1005 Metric) | Panasonic Electronic Components | ERJ-2RKF2202X | Digi-Key | P22.0KLCT-ND |  | SUBCO | NA | NA
77 | 3 | R80 R81 R82 | 2.2k | RES SMD 2.2K OHM 1% 1/16W 0402 | 0402 (1005 Metric) | Yageo | RC0402FR-072K2L | Digi-Key | 311-2.20KLRCT-ND |  | SUBCO | NA | NA
78 | 1 | SW1 | miniswitch-KMR211GLFS | SWITCH TACTILE SPST-NO 0.05A 32V | 4.60mm x 2.80mm | C&K | KMR211GLFS | Digi-Key | 401-1426-2-ND |  | SUBCO | EAR99 | NEC
79 | 3 | TP1 TP2 TP3 | TP | TEST POINT 1MM SMD PADSTASCK |  |  |  |  |  | NOT ASSEMBLY |  | NA | NA
80 | 1 | U1 | AS11P2TLRQ | IC ANLG SWITCH SGL SPDT 6QFN | 6-UFDFN | STMicroelectronics | AS11P2TLRQ | Digi-Key | 497-14595-1-ND | ST-SUPPLY | SUBCO with ST control | EAR99 | NEC
81 | 1 | U2 | TCAN330DCNT | IC TXRX CAN 3.3V SOT-23 | SOT-23-8 | Texas Instruments | TCAN330DCNT | Digi-Key | 296-44210-1-ND |  | SUBCO | EAR99 | NEC
82 | 1 | U3 | LD1117S50TR | IC REG LINEAR 5V 800MA SOT223 | TO-261-4, TO-261AA | STMicroelectronics | LD1117S50TR | Digi-Key | 497-6447-1-ND | ST-SUPPLY | SUBCO with ST control | EAR99 | NEC
83 | 1 | U4 | conn_micro_USB_B | CONN RCPT 5POS MICRO USB R/A |  | Molex, LLC | 0473460001 | Digi-Key | WM17141CT-ND |  | SUBCO | EAR99 | NEC
84 | 1 | U5 | ST890DTR | IC PWR SWITCH 1.2A HISIDE 8-DFN | 8-VDFN Exposed Pad | STMicroelectronics | ST890DTR | Digi-Key | 497-6833-1-ND | ST-SUPPLY | SUBCO with ST control | EAR99 | NEC
85 | 1 | U6 | STM32F103CBT6 | IC MCU 32BIT 128KB FLASH 48LQFP | 48-LQFP | STMicroelectronics | STM32F103CBT6 | Digi-Key | 497-6288-ND | ST-SUPPLY | SUBCO with ST control | 3A991A2 | NEC
86 | 1 | U7 | LD39050PU33R | IC REG LINEAR 3.3V 500MA 6DFN | 6-VDFN Exposed Pad | STMicroelectronics | LD39050PU33R | Digi-Key | 497-8716-1-ND | ST-SUPPLY | SUBCO with ST control | EAR99 | NEC
87 | 1 | U8 | STM32G431CBU6 | IC MCU 32BIT | 48-UFQFPN | STMicroelectronics | STM32G431CBU6 |  |  | ST-SUPPLY | SUBCO with ST control | 3A991A2 | NEC
88 | 1 | U9 | L7986TR | IC REG BUCK ADJ 3A 10VDFPN | 10-VFDFN Exposed Pad | STMicroelectronics | L7986TR | Digi-Key | 497-13224-1-ND | ST-SUPPLY | SUBCO with ST control | EAR99 | NEC
89 | 3 | U10 U11 U13 | L6387ED | IC DRIVER HI/LO SIDE HV 8-SOIC | 8-SOIC (0.154", 3.90mm Width) | STMicroelectronics | L6387ED | Digi-Key | 497-14772-5-ND | ST-SUPPLY | SUBCO with ST control | EAR99 | NEC
90 | 2 | U12 U14 | LDFPVR | IC REG LINEAR POS ADJ 1A 6DFN | 6-VDFN Exposed Pad | STMicroelectronics | LDFPVR | Digi-Key | 497-14672-1-ND | ST-SUPPLY | SUBCO with ST control | EAR99 | NEC
91 | 1 | Y1 | NX3225GD-8MHZ-STD-CRA-3 | CRYSTAL 8.0000MHZ 8PF SMD | 0.126" L x 0.098" W (3.20mm x 2.50mm) | NDK America, Inc. | NX3225GD-8MHZ-STD-CRA-3 | Digi-Key | 644-1178-1-ND |  | SUBCO | EAR99 | NEC
92 | 1 | Y2 | 8MHz | CER RES 8.0000MHZ 33PF SMD | 0.126" L x 0.051" W (3.20mm x 1.30mm) | Murata Electronics North America | CSTCE8M00G15C99-R0 | Digi-Key | 490-7857-1-ND |  | SUBCO | EAR99 | NEC
 |  | ST-SUPPLY
 |  | NOT ASSEMBLY
