Ahmeddiab1/TRI-MD_EVAL/5-RESEARCH/3-SNIPPET/ESC_CTRL/hw/BOM_inwork.ods

Reference | Value | Qty | Digikey | Package
C1 | 10n |  | 1276-1051-1-ND | 0402
C10 | 100n |  | 1276-1001-1-ND | 0402
C11 | 100n |  | 1276-1001-1-ND | 0402
C12 | np |  |  | 0402
C13 | np |  |  | 0402
C14 | 100n |  | 1276-1001-1-ND | 0402
C15 | 100n |  | 1276-1001-1-ND | 0402
C16 | 100n |  | 1276-1001-1-ND | 0402
C17 | 4u7 |  | 1276-2087-1-ND | 0603
C18 | 10u |  | 1276-2872-1-ND | 0805
C19 | 10u |  | 1276-2872-1-ND | 0805
C2 | 4n7 |  | 490-8259-1-ND | 0402
C20 | 10u |  | 1276-2872-1-ND | 0805
C21 | 100n |  | 1276-1001-1-ND | 0402
C22 | 100n |  | 1276-1001-1-ND | 0402
C23 | 100n |  | 1276-1001-1-ND | 0402
C24 | 220n/24V/X7R |  | 445-7408-1-ND | 0603
C25 | 220n/24V/X7R |  | 445-7408-1-ND | 0603
C26 | 220n/24V/X7R |  | 445-7408-1-ND | 0603
C27 | 10u |  | 1276-3388-1-ND | 1210
C28 | 10u |  | 1276-3388-1-ND | 1210
C29 | 100n |  | 1276-1001-1-ND | 0402
C3 | 4n7 |  | 490-8259-1-ND | 0402
C30 | 100n |  | 1276-1001-1-ND | 0402
C31 | 100n |  | 1276-1001-1-ND | 0402
C32 | 100n |  | 1276-1001-1-ND | 0402
C33 | 100n |  | 1276-1001-1-ND | 0402
C34 | 100n |  | 1276-1001-1-ND | 0402
C35 | np |  |  | 0402
C36 | np |  |  | 0402
C37 | np |  |  | 0402
C38 | 1n |  | 1276-1032-1-ND | 0402
C39 | 1n |  | 1276-1032-1-ND | 0402
C4 | 4n7 |  | 490-8259-1-ND | 0402
C40 | 1n |  | 1276-1032-1-ND | 0402
C41 | 10u/50V |  | 1276-3388-1-ND | 1210
C42 | 10u/50V |  | 1276-3388-1-ND | 1210
C43 | 1u/50V |  | 1276-1029-1-ND | 0805
C44 | 1u/50V |  | 1276-1029-1-ND | 0805
C45 | 10u |  | 1276-2872-1-ND | 0805
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
U5 | INA240A2 |  | 296-45089-1-ND | 8-TSSOP
U6 | INA240A2 |  | 296-45089-1-ND | 8-TSSOP
U7 | INA240A2 |  | 296-45089-1-ND | 8-TSSOP
U8 | LM22675-5.0 |  | 296-38092-1-ND | HSOP-8
U9 | AZ1117CR-3.3 |  | AZ1117CR-3.3TRG1DICT-ND | SOT-89
Y1 | 16 MHz |  | SER4069CT-ND
