Ahmeddiab1/TRI-MD_EVAL/2-SOFTWARE/3-ANs/STM/USB_EMI_FILTER_GUIDELINE.pdf

December 2018 | DTS115 Rev 1 | 2/3

www.s/s

December 2018 | DTS115 Rev 1 | 3/3
| | www.st.com
