Ahmeddiab1/TRI-MD_EVAL/1-HARDWARE/1-MD_EVAL/4-GENERATED/VALIDATION/DRC/ESC_GaN_CTRL.html

Altium

# Design Rule Verification Report

Date: | | 5/20/2020
Time: | | 4:16:32 PM
Elapsed Time: | | 00:00:02
Filename: | | C:\Users\TOWER_HOME\Documents\GitHub\TRI_ESC\1-HARDWARE\2-ESC_CTRL\2-PCB\ESC_GaN_CTRL.PcbDoc

Warnings: | | 12
Rule Violations: | | 0

## Summary

Warnings | Count
12 Net Ties failed verification | 12
Total | 12

Rule Violations | Count
Clearance Constraint (Gap=0.1mm) (WithinRoom('BGA')),(All) | 0
Clearance Constraint (Gap=0mm) (All),(OnLayer('Keep-Out Layer')) | 0
Clearance Constraint (Gap=0.08mm) (All),(All) | 0
Short-Circuit Constraint (Allowed=No) (All),(All) | 0
Un-Routed Net Constraint ( (All) ) | 0
Width Constraint (Min=0.1mm) (Max=0.5mm) (Preferred=0.2mm) (WithinRoom('BGA')) | 0
Width Constraint (Min=0.08mm) (Max=1mm) (Preferred=0.2mm) (All) | 0
Width Constraint (Min=0.08mm) (Max=0.2mm) (Preferred=0.15mm) (InNetClass('JTAG')) | 0
Power Plane Connect Rule(Direct Connect )(Expansion=0.508mm) (Conductor Width=0.254mm) (Air Gap=0.254mm) (Entries=4) (All) | 0
Hole Size Constraint (Min=0.2mm) (Max=5mm) (Disabled)(All) | 0
Total | 0

## Warnings

12 Net Ties failed verification

SMT Small Component J2_V-SHORT_PARALLEL (135.112mm,109.65mm) on BOT_SIG_L6, SMT Small Component J2_V-SHORT_PARALLEL (135.112mm,109.65mm) on BOT_SIG_L6, has isolated copper

SMT Small Component JTRST1-SHORT_PARALLEL (138.7mm,105.6mm) on BOT_SIG_L6, SMT Small Component JTRST1-SHORT_PARALLEL (138.7mm,105.6mm) on BOT_SIG_L6, has isolated copper

SMT Small Component J2_W-SHORT_PARALLEL (139.95mm,116.9mm) on BOT_SIG_L6, SMT Small Component J2_W-SHORT_PARALLEL (139.95mm,116.9mm) on BOT_SIG_L6, has isolated copper

SMT Small Component J2_U-SHORT_PARALLEL (128.65mm,105.7mm) on BOT_SIG_L6, SMT Small Component J2_U-SHORT_PARALLEL (128.65mm,105.7mm) on BOT_SIG_L6, has isolated copper

SMT Small Component J1_W-SHORT_PARALLEL (143.783mm,115.783mm) on BOT_SIG_L6, SMT Small Component J1_W-SHORT_PARALLEL (143.783mm,115.783mm) on BOT_SIG_L6, has isolated copper

SMT Small Component J1_V-SHORT_PARALLEL (138.133mm,109.933mm) on BOT_SIG_L6, SMT Small Component J1_V-SHORT_PARALLEL (138.133mm,109.933mm) on BOT_SIG_L6, has isolated copper

SMT Small Component J1_U-SHORT_PARALLEL (132.483mm,104.583mm) on BOT_SIG_L6, SMT Small Component J1_U-SHORT_PARALLEL (132.483mm,104.583mm) on BOT_SIG_L6, has isolated copper

SMT Small Component FID3-Fiducial (147.979mm,124.4mm) on TOP_SIG_L1, SMT Small Component FID3-Fiducial (147.979mm,124.4mm) on TOP_SIG_L1, has isolated copper

SMT Small Component FID2-Fiducial (126.6mm,101mm) on TOP_SIG_L1, SMT Small Component FID2-Fiducial (126.6mm,101mm) on TOP_SIG_L1, has isolated copper

SMT Small Component FID1-Fiducial (154.8mm,95.5mm) on TOP_SIG_L1, SMT Small Component FID1-Fiducial (154.8mm,95.5mm) on TOP_SIG_L1, has isolated copper

SMT Small Component S1-SHORT_PARALLEL (154.421mm,117.505mm) on TOP_SIG_L1, SMT Small Component S1-SHORT_PARALLEL (154.421mm,117.505mm) on TOP_SIG_L1, has isolated copper

Component J4-TC2050-IDC-FP (150.519mm,95.242mm) on TOP_SIG_L1, Component J4-TC2050-IDC-FP (150.519mm,95.242mm) on TOP_SIG_L1, has isolated copper

Back to top
