Ahmeddiab1/TRI-MD_EVAL/1-HARDWARE/1-MD_EVAL/4-GENERATED/VALIDATION/ERC/ESC_CTRL.html

Altium

# Electrical Rule Check Report

Date: | | 5/20/2020
Time: | | 4:16:37 PM
Filename: | | C:\Users\TOWER_HOME\Documents\GitHub\TRI_ESC\1-HARDWARE\2-ESC_CTRL\4-GENERATED\VALIDATION\ERC\ESC_CTRL.html

Class | Document | Message
Warning | 3-MCU.SchDoc | Extra Pin 1 () in Normal of design item TP ROUND.
Warning | 3-MCU.SchDoc | Floating Net Label TIM3_ETR at (175mm,238mm)
Warning | 1-MAIN.SchDoc | Nets Wire ADC1_IN8 has multiple names (Net Label ADC1_IN8, Sheet Entry U_3-MCU-BEMF_U(Output), Sheet Entry U_7-CONNECTORS-BEMF_U(Output))
Warning | 1-MAIN.SchDoc | Nets Wire ADC2_IN8 has multiple names (Net Label ADC2_IN8, Sheet Entry U_3-MCU-BEMF_V(Output), Sheet Entry U_7-CONNECTORS-BEMF_V(Output))
Warning | 1-MAIN.SchDoc | Nets Wire ADC2_IN9 has multiple names (Net Label ADC2_IN9, Sheet Entry U_3-MCU-BEMF_W(Output), Sheet Entry U_7-CONNECTORS-BEMF_W(Output))
Warning | 1-MAIN.SchDoc | Nets Wire ADC4_IN1_N has multiple names (Net Label ADC4_IN1_N, Net Label SENS_VBUS_N, Net Label SENS_VBUS_N, Sheet Entry U_3-MCU-V_BUS_N(Input), Sheet Entry U_7-CONNECTORS-SENS_V_BUS_N(Output))
Warning | 1-MAIN.SchDoc | Nets Wire ADC4_IN1_P has multiple names (Net Label ADC4_IN1_P, Net Label SENS_VBUS_P, Net Label SENS_VBUS_P, Sheet Entry U_3-MCU-V_BUS_P(Input), Sheet Entry U_7-CONNECTORS-SENS_V_BUS_P(Output))
Warning | 1-MAIN.SchDoc | Nets Wire ADC4_IN3 has multiple names (Net Label ADC4_IN3, Sheet Entry U_3-MCU-TEMP_SENS(Input), Sheet Entry U_7-CONNECTORS-SENS_TEMP_1(Output))
Warning | 1-MAIN.SchDoc | Nets Wire COMP1_IN_P has multiple names (Net Label COMP1_IN_P, Net Label COMP1_IN_P, Net Label OPAMP1_VIN_P, Net Label SENS_SH_U_P, Net Label SENS_SH_U_P, Sheet Entry U_3-MCU-OPAMP1_VIN_P(Input), Sheet Entry U_7-CONNECTORS-SENS_SH_U_P(Output))
Warning | 1-MAIN.SchDoc | Nets Wire COMP3_IN_P has multiple names (Net Label COMP3_IN_P, Net Label COMP3_IN_P, Net Label OPAMP2_VIN_P, Net Label SENS_SH_V_P, Net Label SENS_SH_V_P, Sheet Entry U_3-MCU-OPAMP2_VIN_P(Input), Sheet Entry U_7-CONNECTORS-SENS_SH_V_P(Output))
Warning | 1-MAIN.SchDoc | Nets Wire COMP4_IN_P has multiple names (Net Label COMP4_IN_P, Net Label COMP4_IN_P, Net Label OPAMP3_VIN_P, Net Label SENS_SH_W_P, Net Label SENS_SH_W_P, Sheet Entry U_3-MCU-OPAMP3_VIN_P(Input), Sheet Entry U_7-CONNECTORS-SENS_SH_W_P(Output))
Warning | 1-MAIN.SchDoc | Nets Wire I2C2_SCL has multiple names (Net Label I2C2_SCL, Sheet Entry U_3-MCU-I2C_SCL(Passive))
Warning | 1-MAIN.SchDoc | Nets Wire I2C2_SDA has multiple names (Net Label I2C2_SDA, Sheet Entry U_3-MCU-I2C_SDA(Passive))
Warning | 1-MAIN.SchDoc | Nets Wire JTCK has multiple names (Net Label JTCK, Sheet Entry U_3-MCU-JTCK-SWCLK(I/O), Sheet Entry U_4-JTAG-TCLK(I/O))
Warning | 1-MAIN.SchDoc | Nets Wire JTDI has multiple names (Net Label JTDI, Sheet Entry U_3-MCU-JTDI(Input), Sheet Entry U_4-JTAG-TDI(Output))
Warning | 1-MAIN.SchDoc | Nets Wire JTDO has multiple names (Net Label JTDO, Sheet Entry U_3-MCU-JTDO-SWO(Output), Sheet Entry U_4-JTAG-TDO(Input))
Warning | 1-MAIN.SchDoc | Nets Wire JTMS has multiple names (Net Label JTMS, Sheet Entry U_3-MCU-JTMS-SWDIO(I/O), Sheet Entry U_4-JTAG-TMS(I/O))
Warning | 1-MAIN.SchDoc | Nets Wire NetJ1_U_2 has multiple names (Sheet Entry U_7-CONNECTORS-GATE_W_P(Input), Sheet Entry U_11-PWM_INTERLOCK-PWM_OUT_H(Output))
Warning | 1-MAIN.SchDoc | Nets Wire NetJ1_V_2 has multiple names (Sheet Entry U_7-CONNECTORS-GATE_V_P(Input), Sheet Entry U_11-PWM_INTERLOCK-PWM_OUT_H(Output))
Warning | 1-MAIN.SchDoc | Nets Wire NetJ1_W_2 has multiple names (Sheet Entry U_7-CONNECTORS-GATE_U_P(Input), Sheet Entry U_11-PWM_INTERLOCK-PWM_OUT_H(Output))
Warning | 1-MAIN.SchDoc | Nets Wire NetJ2_U_2 has multiple names (Sheet Entry U_7-CONNECTORS-GATE_W_N(Input), Sheet Entry U_11-PWM_INTERLOCK-PWM_OUT_L(Output))
Warning | 1-MAIN.SchDoc | Nets Wire NetJ2_V_2 has multiple names (Sheet Entry U_7-CONNECTORS-GATE_V_N(Input), Sheet Entry U_11-PWM_INTERLOCK-PWM_OUT_L(Output))
Warning | 1-MAIN.SchDoc | Nets Wire NetJ2_W_2 has multiple names (Sheet Entry U_7-CONNECTORS-GATE_U_N(Input), Sheet Entry U_11-PWM_INTERLOCK-PWM_OUT_L(Output))
Warning | 1-MAIN.SchDoc | Nets Wire NetR1_U_1 has multiple names (Sheet Entry U_3-MCU-FLT_W(Input), Sheet Entry U_11-PWM_INTERLOCK-PWM_LOCK(Output))
Warning | 1-MAIN.SchDoc | Nets Wire NetR1_V_1 has multiple names (Sheet Entry U_3-MCU-FLT_V(Input), Sheet Entry U_11-PWM_INTERLOCK-PWM_LOCK(Output))
Warning | 1-MAIN.SchDoc | Nets Wire NetR1_W_1 has multiple names (Sheet Entry U_3-MCU-FLT_U(Input), Sheet Entry U_11-PWM_INTERLOCK-PWM_LOCK(Output))
Warning | 1-MAIN.SchDoc | Nets Wire NetU2_1 has multiple names (Sheet Entry U_3-MCU-FDCAN2_RX(Input), Sheet Entry U_5-CAN_TRANSCEIVER-RX_CAN_FD2(Output))
Warning | 1-MAIN.SchDoc | Nets Wire NetU2_4 has multiple names (Sheet Entry U_3-MCU-FDCAN2_TX(Output), Sheet Entry U_5-CAN_TRANSCEIVER-TX_CAN_FD2(Input))
Warning | 1-MAIN.SchDoc | Nets Wire OPAMP1_VIN_N has multiple names (Net Label OPAMP1_VIN_N, Net Label OPAMP1_VIN_N, Net Label SENS_SH_U_N, Net Label SENS_SH_U_N, Sheet Entry U_3-MCU-OPAMP1_VIN_N(Input), Sheet Entry U_7-CONNECTORS-SENS_SH_U_N(Output))
Warning | 1-MAIN.SchDoc | Nets Wire OPAMP2_VIN_N has multiple names (Net Label OPAMP2_VIN_N, Net Label OPAMP2_VIN_N, Net Label SENS_SH_V_N, Net Label SENS_SH_V_N, Sheet Entry U_3-MCU-OPAMP2_VIN_N(Input), Sheet Entry U_7-CONNECTORS-SENS_SH_V_N(Output))
Warning | 1-MAIN.SchDoc | Nets Wire OPAMP3_VIN_N has multiple names (Net Label OPAMP3_VIN_N, Net Label OPAMP3_VIN_N, Net Label SENS_SH_W_N, Net Label SENS_SH_W_N, Sheet Entry U_3-MCU-OPAMP3_VIN_N(Input), Sheet Entry U_7-CONNECTORS-SENS_SH_W_N(Output))
Warning | 3-MCU.SchDoc | Nets Wire STATUS_1 has multiple names (Net Label STATUS_1, Net Label STATUS_1, Net Label TIM3_CH3)
Warning | 3-MCU.SchDoc | Nets Wire STATUS_2 has multiple names (Net Label STATUS_2, Net Label STATUS_2, Net Label TIM3_CH4)
Warning | 1-MAIN.SchDoc | Nets Wire TIM1_CH1 has multiple names (Net Label TIM1_CH1, Sheet Entry U_3-MCU-GATE_U_P(Output), Sheet Entry U_11-PWM_INTERLOCK-PWM_IN_H(Input))
Warning | 1-MAIN.SchDoc | Nets Wire TIM1_CH1N has multiple names (Net Label TIM1_CH1N, Sheet Entry U_3-MCU-GATE_U_N(Output), Sheet Entry U_11-PWM_INTERLOCK-PWM_IN_L(Input))
Warning | 1-MAIN.SchDoc | Nets Wire TIM1_CH2 has multiple names (Net Label TIM1_CH2, Sheet Entry U_3-MCU-GATE_V_P(Output), Sheet Entry U_11-PWM_INTERLOCK-PWM_IN_H(Input))
Warning | 1-MAIN.SchDoc | Nets Wire TIM1_CH2N has multiple names (Net Label TIM1_CH2N, Sheet Entry U_3-MCU-GATE_V_N(Output), Sheet Entry U_11-PWM_INTERLOCK-PWM_IN_L(Input))
Warning | 1-MAIN.SchDoc | Nets Wire TIM1_CH3 has multiple names (Net Label TIM1_CH3, Sheet Entry U_3-MCU-GATE_W_P(Output), Sheet Entry U_11-PWM_INTERLOCK-PWM_IN_H(Input))
Warning | 1-MAIN.SchDoc | Nets Wire TIM1_CH3N has multiple names (Net Label TIM1_CH3N, Sheet Entry U_3-MCU-GATE_W_N(Output), Sheet Entry U_11-PWM_INTERLOCK-PWM_IN_L(Input))
Warning | 1-MAIN.SchDoc | Nets Wire TIM2_CH1 has multiple names (Net Label TIM2_CH1, Sheet Entry U_3-MCU-BEMF_SLCT(Output), Sheet Entry U_7-CONNECTORS-BEMF_SELECT(Input))
Warning | 1-MAIN.SchDoc | Nets Wire TIM4_CH1 has multiple names (Net Label TIM4_CH1, Sheet Entry U_3-MCU-ENC_A(Input), Sheet Entry U_7-CONNECTORS-ENC_A(Output))
Warning | 1-MAIN.SchDoc | Nets Wire TIM4_CH2 has multiple names (Net Label TIM4_CH2, Sheet Entry U_3-MCU-ENC_B(Input), Sheet Entry U_7-CONNECTORS-ENC_B(Output))
Warning | 1-MAIN.SchDoc | Nets Wire TIM4_CH3 has multiple names (Net Label TIM4_CH3, Sheet Entry U_3-MCU-ENC_INDEX(Input), Sheet Entry U_7-CONNECTORS-ENC_INDEX(Output))
Warning | 1-MAIN.SchDoc | Nets Wire TIM5_CH2 has multiple names (Net Label TIM5_CH2, Sheet Entry U_3-MCU-PWN_IN(Input))
Warning | 1-MAIN.SchDoc | Nets Wire USART2_RX has multiple names (Net Label USART2_RX, Sheet Entry U_3-MCU-USART2_RX(Input), Sheet Entry U_6-MAVLINK_TRANSCEIVER-RX_MAVLINK(Output))
Warning | 1-MAIN.SchDoc | Nets Wire USART2_TX has multiple names (Net Label USART2_TX, Sheet Entry U_3-MCU-USART2_TX(Output), Sheet Entry U_6-MAVLINK_TRANSCEIVER-TX_MAVLINK(Input))

Back to top
