Ahmeddiab1/TRI-MD_EVAL/1-HARDWARE/1-MD_EVAL/4-GENERATED/VALIDATION/FootprintComparison/ESC_GaN_CTRL.html

Altium customize

# Footprint Comparison Report

Date: | | 5/20/2020
Time: | | 4:16:39 PM
Elapsed Time: | | 00:00:00
Filename: | | C:\Users\TOWER_HOME\Documents\GitHub\TRI_ESC\1-HARDWARE\2-ESC_CTRL\2-PCB\ESC_GaN_CTRL.PcbDoc

## Contents

Contents

Components Status Summary

Matched Components List

## Components Status Summary

## Matched Components List

Designator | Footprint | Footprint reference | Footprint to reference Library
B1 | BUTTON_SINGLE_SIDE | BUTTON_SINGLE_SIDE | C:\Users\TOWER_HOME\Documents\GitHub\TRI_ESC\1-HARDWARE\2-ESC_CTRL\ESC_CTRL.IntLib
B2 | BUTTON_SINGLE_SIDE | BUTTON_SINGLE_SIDE | C:\Users\TOWER_HOME\Documents\GitHub\TRI_ESC\1-HARDWARE\2-ESC_CTRL\ESC_CTRL.IntLib
C1 | C 0805(2012)x0.65 | C 0805(2012)x0.65 | C:\Users\TOWER_HOME\Documents\GitHub\TRI_ESC\1-HARDWARE\2-ESC_CTRL\ESC_CTRL.IntLib
C1_U | C 0402(1005)x0.5 | C 0402(1005)x0.5 | C:\Users\TOWER_HOME\Documents\GitHub\TRI_ESC\1-HARDWARE\2-ESC_CTRL\ESC_CTRL.IntLib
C1_V | C 0402(1005)x0.5 | C 0402(1005)x0.5 | C:\Users\TOWER_HOME\Documents\GitHub\TRI_ESC\1-HARDWARE\2-ESC_CTRL\ESC_CTRL.IntLib
C1_W | C 0402(1005)x0.5 | C 0402(1005)x0.5 | C:\Users\TOWER_HOME\Documents\GitHub\TRI_ESC\1-HARDWARE\2-ESC_CTRL\ESC_CTRL.IntLib
C2 | EL SMD D5 h5.4 | EL SMD D5 h5.4 | C:\Users\TOWER_HOME\Documents\GitHub\TRI_ESC\1-HARDWARE\2-ESC_CTRL\ESC_CTRL.IntLib
C2_U | C 0402(1005)x0.5 | C 0402(1005)x0.5 | C:\Users\TOWER_HOME\Documents\GitHub\TRI_ESC\1-HARDWARE\2-ESC_CTRL\ESC_CTRL.IntLib
C2_V | C 0402(1005)x0.5 | C 0402(1005)x0.5 | C:\Users\TOWER_HOME\Documents\GitHub\TRI_ESC\1-HARDWARE\2-ESC_CTRL\ESC_CTRL.IntLib
C2_W | C 0402(1005)x0.5 | C 0402(1005)x0.5 | C:\Users\TOWER_HOME\Documents\GitHub\TRI_ESC\1-HARDWARE\2-ESC_CTRL\ESC_CTRL.IntLib
C3 | C 0805(2012)x0.65 | C 0805(2012)x0.65 | C:\Users\TOWER_HOME\Documents\GitHub\TRI_ESC\1-HARDWARE\2-ESC_CTRL\ESC_CTRL.IntLib
C3_U | C 0402(1005)x0.5 | C 0402(1005)x0.5 | C:\Users\TOWER_HOME\Documents\GitHub\TRI_ESC\1-HARDWARE\2-ESC_CTRL\ESC_CTRL.IntLib
C3_V | C 0402(1005)x0.5 | C 0402(1005)x0.5 | C:\Users\TOWER_HOME\Documents\GitHub\TRI_ESC\1-HARDWARE\2-ESC_CTRL\ESC_CTRL.IntLib
C3_W | C 0402(1005)x0.5 | C 0402(1005)x0.5 | C:\Users\TOWER_HOME\Documents\GitHub\TRI_ESC\1-HARDWARE\2-ESC_CTRL\ESC_CTRL.IntLib
C4 | C 1206(3216)x1.6 | C 1206(3216)x1.6 | C:\Users\TOWER_HOME\Documents\GitHub\TRI_ESC\1-HARDWARE\2-ESC_CTRL\ESC_CTRL.IntLib
C5 | C 0805(2012)x0.65 | C 0805(2012)x0.65 | C:\Users\TOWER_HOME\Documents\GitHub\TRI_ESC\1-HARDWARE\2-ESC_CTRL\ESC_CTRL.IntLib
C6 | C 0402(1005)x0.5 | C 0402(1005)x0.5 | C:\Users\TOWER_HOME\Documents\GitHub\TRI_ESC\1-HARDWARE\2-ESC_CTRL\ESC_CTRL.IntLib
C7 | C 0402(1005)x0.5 | C 0402(1005)x0.5 | C:\Users\TOWER_HOME\Documents\GitHub\TRI_ESC\1-HARDWARE\2-ESC_CTRL\ESC_CTRL.IntLib
C8 | C 0805(2012)x0.65 | C 0805(2012)x0.65 | C:\Users\TOWER_HOME\Documents\GitHub\TRI_ESC\1-HARDWARE\2-ESC_CTRL\ESC_CTRL.IntLib
C9 | C 0805(2012)x0.65 | C 0805(2012)x0.65 | C:\Users\TOWER_HOME\Documents\GitHub\TRI_ESC\1-HARDWARE\2-ESC_CTRL\ESC_CTRL.IntLib
C10 | C 0805(2012)x0.65 | C 0805(2012)x0.65 | C:\Users\TOWER_HOME\Documents\GitHub\TRI_ESC\1-HARDWARE\2-ESC_CTRL\ESC_CTRL.IntLib
C11 | C 0805(2012)x0.65 | C 0805(2012)x0.65 | C:\Users\TOWER_HOME\Documents\GitHub\TRI_ESC\1-HARDWARE\2-ESC_CTRL\ESC_CTRL.IntLib
C12 | C 0402(1005)x0.5 | C 0402(1005)x0.5 | C:\Users\TOWER_HOME\Documents\GitHub\TRI_ESC\1-HARDWARE\2-ESC_CTRL\ESC_CTRL.IntLib
C13 | C 0402(1005)x0.5 | C 0402(1005)x0.5 | C:\Users\TOWER_HOME\Documents\GitHub\TRI_ESC\1-HARDWARE\2-ESC_CTRL\ESC_CTRL.IntLib
C14 | C 0402(1005)x0.5 | C 0402(1005)x0.5 | C:\Users\TOWER_HOME\Documents\GitHub\TRI_ESC\1-HARDWARE\2-ESC_CTRL\ESC_CTRL.IntLib
C15 | C 0402(1005)x0.5 | C 0402(1005)x0.5 | C:\Users\TOWER_HOME\Documents\GitHub\TRI_ESC\1-HARDWARE\2-ESC_CTRL\ESC_CTRL.IntLib
C16 | C 0402(1005)x0.5 | C 0402(1005)x0.5 | C:\Users\TOWER_HOME\Documents\GitHub\TRI_ESC\1-HARDWARE\2-ESC_CTRL\ESC_CTRL.IntLib
C17 | C 0402(1005)x0.5 | C 0402(1005)x0.5 | C:\Users\TOWER_HOME\Documents\GitHub\TRI_ESC\1-HARDWARE\2-ESC_CTRL\ESC_CTRL.IntLib
C18 | C 0402(1005)x0.5 | C 0402(1005)x0.5 | C:\Users\TOWER_HOME\Documents\GitHub\TRI_ESC\1-HARDWARE\2-ESC_CTRL\ESC_CTRL.IntLib
C19 | C 0402(1005)x0.5 | C 0402(1005)x0.5 | C:\Users\TOWER_HOME\Documents\GitHub\TRI_ESC\1-HARDWARE\2-ESC_CTRL\ESC_CTRL.IntLib
C20 | C 0402(1005)x0.5 | C 0402(1005)x0.5 | C:\Users\TOWER_HOME\Documents\GitHub\TRI_ESC\1-HARDWARE\2-ESC_CTRL\ESC_CTRL.IntLib
C21 | C 0805(2012)x0.65 | C 0805(2012)x0.65 | C:\Users\TOWER_HOME\Documents\GitHub\TRI_ESC\1-HARDWARE\2-ESC_CTRL\ESC_CTRL.IntLib
C22 | C 0402(1005)x0.5 | C 0402(1005)x0.5 | C:\Users\TOWER_HOME\Documents\GitHub\TRI_ESC\1-HARDWARE\2-ESC_CTRL\ESC_CTRL.IntLib
C23 | C 0402(1005)x0.5 | C 0402(1005)x0.5 | C:\Users\TOWER_HOME\Documents\GitHub\TRI_ESC\1-HARDWARE\2-ESC_CTRL\ESC_CTRL.IntLib
C24 | C 0402(1005)x0.5 | C 0402(1005)x0.5 | C:\Users\TOWER_HOME\Documents\GitHub\TRI_ESC\1-HARDWARE\2-ESC_CTRL\ESC_CTRL.IntLib
C25 | C 0402(1005)x0.5 | C 0402(1005)x0.5 | C:\Users\TOWER_HOME\Documents\GitHub\TRI_ESC\1-HARDWARE\2-ESC_CTRL\ESC_CTRL.IntLib
C26 | C 0402(1005)x0.5 | C 0402(1005)x0.5 | C:\Users\TOWER_HOME\Documents\GitHub\TRI_ESC\1-HARDWARE\2-ESC_CTRL\ESC_CTRL.IntLib
CMC1 | CMC_1210 | CMC_1210 | C:\Users\TOWER_HOME\Documents\GitHub\Altium_Utilities\Libraries\Libs_Own\3-SYMBOLS\PASSIVE\Project Outputs for LIB_PASSIVE\LIB_PASSIVE.IntLib
D1 | LED 0603 | LED 0603 | C:\Users\TOWER_HOME\Documents\GitHub\TRI_ESC\1-HARDWARE\2-ESC_CTRL\ESC_CTRL.IntLib
D1_U | LED 0402 | LED 0402 | C:\Users\TOWER_HOME\Documents\GitHub\TRI_ESC\1-HARDWARE\2-ESC_CTRL\ESC_CTRL.IntLib
D1_V | LED 0402 | LED 0402 | C:\Users\TOWER_HOME\Documents\GitHub\TRI_ESC\1-HARDWARE\2-ESC_CTRL\ESC_CTRL.IntLib
D1_W | LED 0402 | LED 0402 | C:\Users\TOWER_HOME\Documents\GitHub\TRI_ESC\1-HARDWARE\2-ESC_CTRL\ESC_CTRL.IntLib
D2 | LED_4PINS | LED_4PINS | C:\Users\TOWER_HOME\Documents\GitHub\TRI_ESC\1-HARDWARE\2-ESC_CTRL\ESC_CTRL.IntLib
D3 | SOT323_3_0.8_2.9 | SOT323_3_0.8_2.9 | C:\Users\TOWER_HOME\Documents\GitHub\TRI_ESC\1-HARDWARE\2-ESC_CTRL\ESC_CTRL.IntLib
D4 | LED 0603 | LED 0603 | C:\Users\TOWER_HOME\Documents\GitHub\TRI_ESC\1-HARDWARE\2-ESC_CTRL\ESC_CTRL.IntLib
D5 | LED 0603 | LED 0603 | C:\Users\TOWER_HOME\Documents\GitHub\TRI_ESC\1-HARDWARE\2-ESC_CTRL\ESC_CTRL.IntLib
FB1 | FB 0805(2012) | FB 0805(2012) | C:\Users\TOWER_HOME\Documents\GitHub\TRI_ESC\1-HARDWARE\2-ESC_CTRL\ESC_CTRL.IntLib
FB2 | FB 0805(2012) | FB 0805(2012) | C:\Users\TOWER_HOME\Documents\GitHub\TRI_ESC\1-HARDWARE\2-ESC_CTRL\ESC_CTRL.IntLib
FID1 | FID_05MM | FID_05MM | C:\Users\TOWER_HOME\Documents\GitHub\Altium_Utilities\Libraries\Libs_Own\3-SYMBOLS\ELECTRO-MECHANICAL\Project Outputs for LIB_ELECTRO-MECHA\LIB_ELECTRO-MECHA.IntLib
FID2 | FID_05MM | FID_05MM | C:\Users\TOWER_HOME\Documents\GitHub\Altium_Utilities\Libraries\Libs_Own\3-SYMBOLS\ELECTRO-MECHANICAL\Project Outputs for LIB_ELECTRO-MECHA\LIB_ELECTRO-MECHA.IntLib
FID3 | FID_05MM | FID_05MM | C:\Users\TOWER_HOME\Documents\GitHub\Altium_Utilities\Libraries\Libs_Own\3-SYMBOLS\ELECTRO-MECHANICAL\Project Outputs for LIB_ELECTRO-MECHA\LIB_ELECTRO-MECHA.IntLib
J1 | PHT-102-01-S-S | PHT-102-01-S-S | C:\Users\TOWER_HOME\Documents\GitHub\Altium_Utilities\Libraries\Libs_Own\3-SYMBOLS\CONNECTOR\Project Outputs for LIB_CONNECTOR\LIB_CONNECTOR.IntLib
J1_U | SHORT_PARALLEL | SHORT_PARALLEL | C:\Users\TOWER_HOME\Documents\GitHub\TRI_ESC\1-HARDWARE\2-ESC_CTRL\ESC_CTRL.IntLib
J1_V | SHORT_PARALLEL | SHORT_PARALLEL | C:\Users\TOWER_HOME\Documents\GitHub\TRI_ESC\1-HARDWARE\2-ESC_CTRL\ESC_CTRL.IntLib
J1_W | SHORT_PARALLEL | SHORT_PARALLEL | C:\Users\TOWER_HOME\Documents\GitHub\TRI_ESC\1-HARDWARE\2-ESC_CTRL\ESC_CTRL.IntLib
J2 | PAD_03-03-RD | PAD_03-03-RD | C:\Users\TOWER_HOME\Documents\GitHub\Altium_Utilities\Libraries\Libs_Own\3-SYMBOLS\CONNECTOR\Project Outputs for LIB_CONNECTOR\LIB_CONNECTOR.IntLib
J2_U | SHORT_PARALLEL | SHORT_PARALLEL | C:\Users\TOWER_HOME\Documents\GitHub\TRI_ESC\1-HARDWARE\2-ESC_CTRL\ESC_CTRL.IntLib
J2_V | SHORT_PARALLEL | SHORT_PARALLEL | C:\Users\TOWER_HOME\Documents\GitHub\TRI_ESC\1-HARDWARE\2-ESC_CTRL\ESC_CTRL.IntLib
J2_W | SHORT_PARALLEL | SHORT_PARALLEL | C:\Users\TOWER_HOME\Documents\GitHub\TRI_ESC\1-HARDWARE\2-ESC_CTRL\ESC_CTRL.IntLib
J3 | PAD_03-03-RD | PAD_03-03-RD | C:\Users\TOWER_HOME\Documents\GitHub\Altium_Utilities\Libraries\Libs_Own\3-SYMBOLS\CONNECTOR\Project Outputs for LIB_CONNECTOR\LIB_CONNECTOR.IntLib
J4 | TC2050-IDC-FP | TC2050-IDC-FP | C:\Users\TOWER_HOME\Documents\GitHub\TRI_ESC\1-HARDWARE\2-ESC_CTRL\ESC_CTRL.IntLib
J5 | DF13C-4P-1.25V | DF13C-4P-1.25V | C:\Users\TOWER_HOME\Documents\GitHub\Altium_Utilities\Libraries\Libs_Own\3-SYMBOLS\CONNECTOR\Project Outputs for LIB_CONNECTOR\LIB_CONNECTOR.IntLib
J6 | DF13C-4P-1.25V | DF13C-4P-1.25V | C:\Users\TOWER_HOME\Documents\GitHub\Altium_Utilities\Libraries\Libs_Own\3-SYMBOLS\CONNECTOR\Project Outputs for LIB_CONNECTOR\LIB_CONNECTOR.IntLib
J7 | FLE-105-01-G-DV | FLE-105-01-G-DV | C:\Users\TOWER_HOME\Documents\GitHub\TRI_ESC\1-HARDWARE\2-ESC_CTRL\ESC_CTRL.IntLib
J8 | FLE-105-01-G-DV | FLE-105-01-G-DV | C:\Users\TOWER_HOME\Documents\GitHub\TRI_ESC\1-HARDWARE\2-ESC_CTRL\ESC_CTRL.IntLib
J9 | FLE-105-01-G-DV | FLE-105-01-G-DV | C:\Users\TOWER_HOME\Documents\GitHub\TRI_ESC\1-HARDWARE\2-ESC_CTRL\ESC_CTRL.IntLib
JTRST1 | SHORT_PARALLEL | SHORT_PARALLEL | C:\Users\TOWER_HOME\Documents\GitHub\TRI_ESC\1-HARDWARE\2-ESC_CTRL\ESC_CTRL.IntLib
M1 | PAD_03-01-SQ | PAD_03-01-SQ | C:\Users\TOWER_HOME\Documents\GitHub\TRI_ESC\1-HARDWARE\2-ESC_CTRL\ESC_CTRL.IntLib
M2 | PAD_03-01-SQ | PAD_03-01-SQ | C:\Users\TOWER_HOME\Documents\GitHub\TRI_ESC\1-HARDWARE\2-ESC_CTRL\ESC_CTRL.IntLib
M3 | PAD_03-01-SQ | PAD_03-01-SQ | C:\Users\TOWER_HOME\Documents\GitHub\TRI_ESC\1-HARDWARE\2-ESC_CTRL\ESC_CTRL.IntLib
Q1 | QUARTZ_1 | QUARTZ_1 | C:\Users\TOWER_HOME\Documents\GitHub\TRI_ESC\1-HARDWARE\2-ESC_CTRL\ESC_CTRL.IntLib
R1 | R 0402(1005)-1% | R 0402(1005)-1% | C:\Users\TOWER_HOME\Documents\GitHub\TRI_ESC\1-HARDWARE\2-ESC_CTRL\ESC_CTRL.IntLib
R1_U | R 0402(1005)-1% | R 0402(1005)-1% | C:\Users\TOWER_HOME\Documents\GitHub\TRI_ESC\1-HARDWARE\2-ESC_CTRL\ESC_CTRL.IntLib
R1_V | R 0402(1005)-1% | R 0402(1005)-1% | C:\Users\TOWER_HOME\Documents\GitHub\TRI_ESC\1-HARDWARE\2-ESC_CTRL\ESC_CTRL.IntLib
R1_W | R 0402(1005)-1% | R 0402(1005)-1% | C:\Users\TOWER_HOME\Documents\GitHub\TRI_ESC\1-HARDWARE\2-ESC_CTRL\ESC_CTRL.IntLib
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
TVS2 | MSOP_8_0.65_3.0 | MSOP_8_0.65_3.0 | C:\Users\TOWER_HOME\Documents\GitHub\TRI_ESC\1-HARDWARE\2-ESC_CTRL\ESC_CTRL.IntLib
U1 | MICROSIP-10 | MICROSIP-10 | C:\Users\TOWER_HOME\Documents\GitHub\TRI_ESC\1-HARDWARE\2-ESC_CTRL\ESC_CTRL.IntLib
U1_U | DSBGA-6 | DSBGA-6 | C:\Users\TOWER_HOME\Documents\GitHub\TRI_ESC\1-HARDWARE\2-ESC_CTRL\ESC_CTRL.IntLib
U1_V | DSBGA-6 | DSBGA-6 | C:\Users\TOWER_HOME\Documents\GitHub\TRI_ESC\1-HARDWARE\2-ESC_CTRL\ESC_CTRL.IntLib
U1_W | DSBGA-6 | DSBGA-6 | C:\Users\TOWER_HOME\Documents\GitHub\TRI_ESC\1-HARDWARE\2-ESC_CTRL\ESC_CTRL.IntLib
U2 | SOIC-8_1.27_4 | SOIC-8_1.27_4 | C:\Users\TOWER_HOME\Documents\GitHub\TRI_ESC\1-HARDWARE\2-ESC_CTRL\ESC_CTRL.IntLib
U2_U | DSBGA-8 | DSBGA-8 | C:\Users\TOWER_HOME\Documents\GitHub\TRI_ESC\1-HARDWARE\2-ESC_CTRL\ESC_CTRL.IntLib
U2_V | DSBGA-8 | DSBGA-8 | C:\Users\TOWER_HOME\Documents\GitHub\TRI_ESC\1-HARDWARE\2-ESC_CTRL\ESC_CTRL.IntLib
U2_W | DSBGA-8 | DSBGA-8 | C:\Users\TOWER_HOME\Documents\GitHub\TRI_ESC\1-HARDWARE\2-ESC_CTRL\ESC_CTRL.IntLib
U3_U | DSBGA-8 | DSBGA-8 | C:\Users\TOWER_HOME\Documents\GitHub\TRI_ESC\1-HARDWARE\2-ESC_CTRL\ESC_CTRL.IntLib
U3_V | DSBGA-8 | DSBGA-8 | C:\Users\TOWER_HOME\Documents\GitHub\TRI_ESC\1-HARDWARE\2-ESC_CTRL\ESC_CTRL.IntLib
U3_W | DSBGA-8 | DSBGA-8 | C:\Users\TOWER_HOME\Documents\GitHub\TRI_ESC\1-HARDWARE\2-ESC_CTRL\ESC_CTRL.IntLib
U4 | DSBGA-8 | DSBGA-8 | C:\Users\TOWER_HOME\Documents\GitHub\TRI_ESC\1-HARDWARE\2-ESC_CTRL\ESC_CTRL.IntLib
U5 | TFBGA-100 | TFBGA-100 | C:\Users\TOWER_HOME\Documents\GitHub\TRI_ESC\1-HARDWARE\2-ESC_CTRL\ESC_CTRL.IntLib
U6 | QFN8_2_2 | QFN8_2_2 | C:\Users\TOWER_HOME\Documents\GitHub\TRI_ESC\1-HARDWARE\2-ESC_CTRL\ESC_CTRL.IntLib
U7 | SOT23_3_0.95_1.6 | SOT23_3_0.95_1.6 | C:\Users\TOWER_HOME\Documents\GitHub\TRI_ESC\1-HARDWARE\2-ESC_CTRL\ESC_CTRL.IntLib

Back to top
