Ahmeddiab1/TRI-MD_EVAL/1-HARDWARE/1-MD_EVAL/4-GENERATED/PDF/ASSEMBLY.PDF

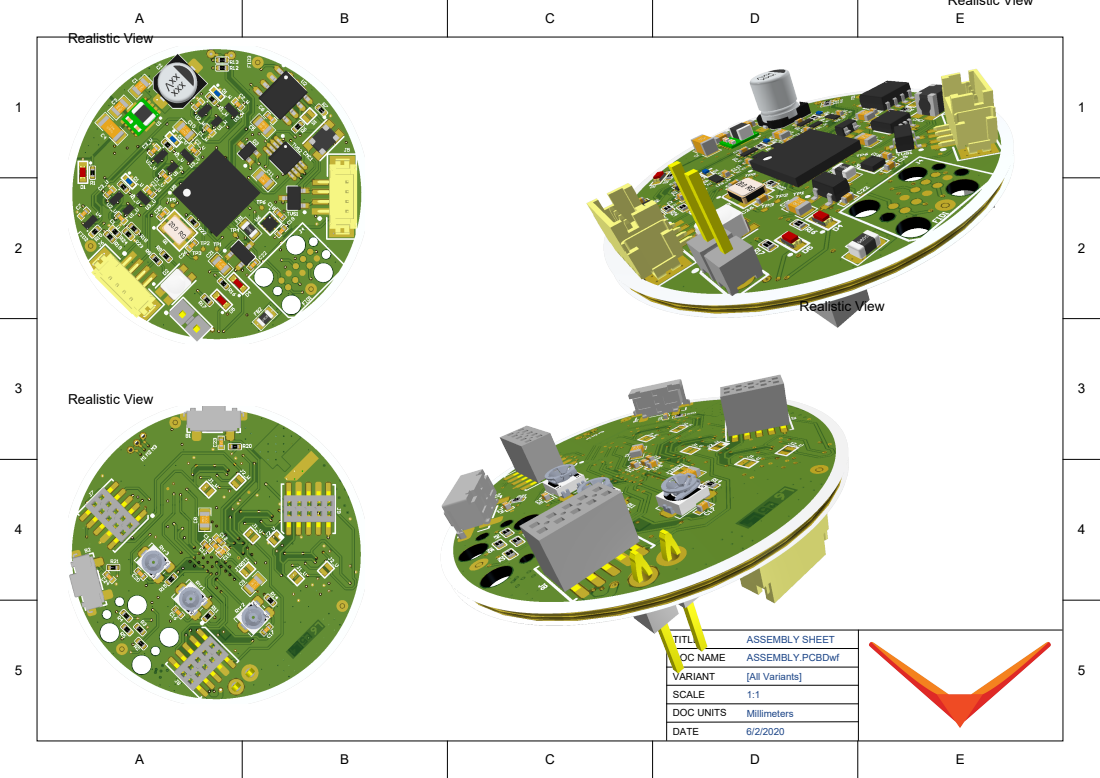
[picture p35: page 1]

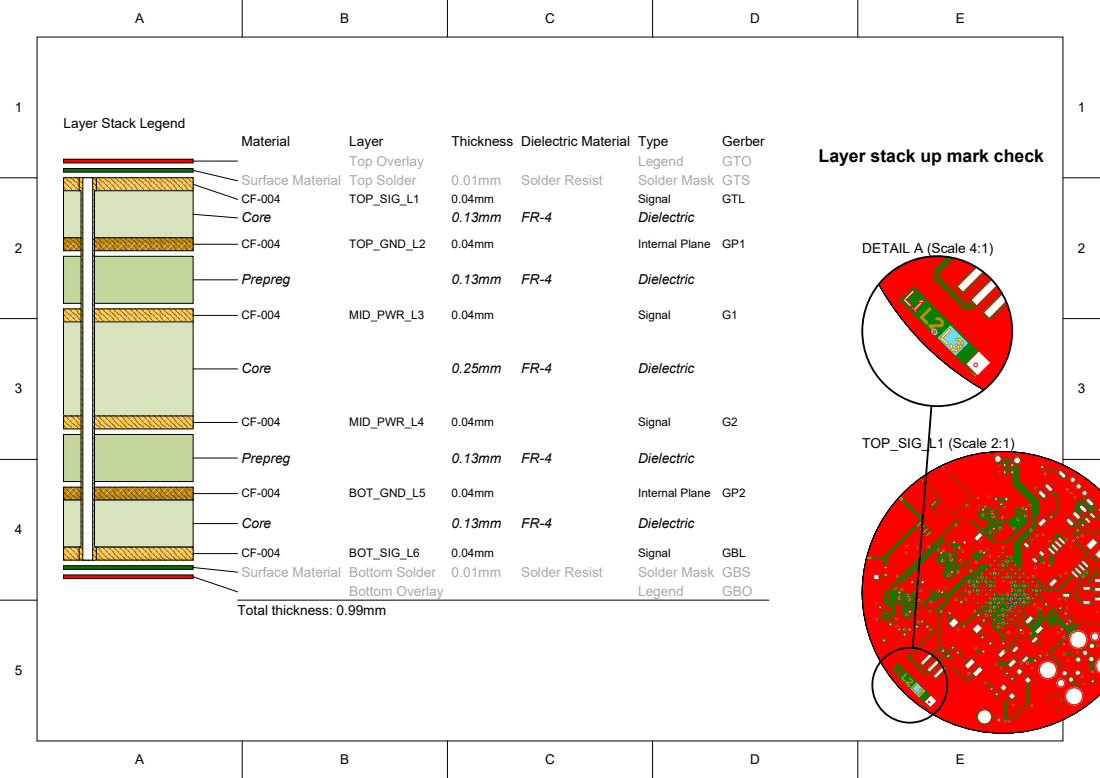
[picture p36: page 2]

Layer stack up mark check

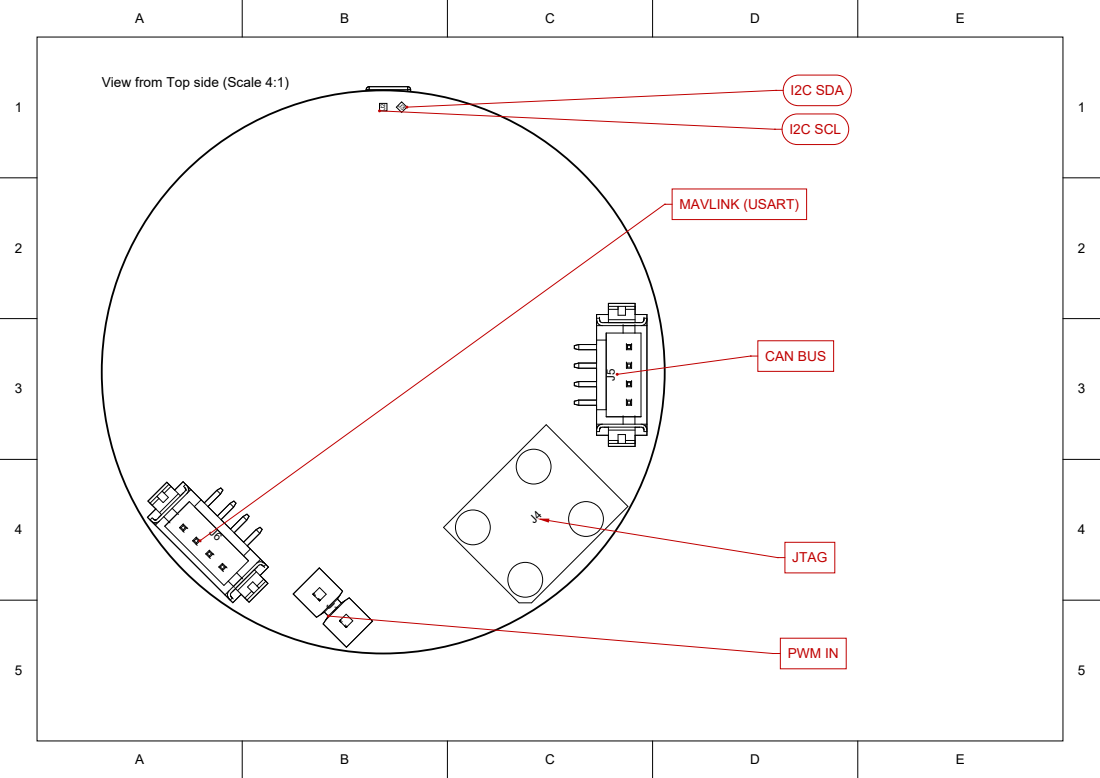
[picture p37: page 3]

View from Top side (Scale 4:1)

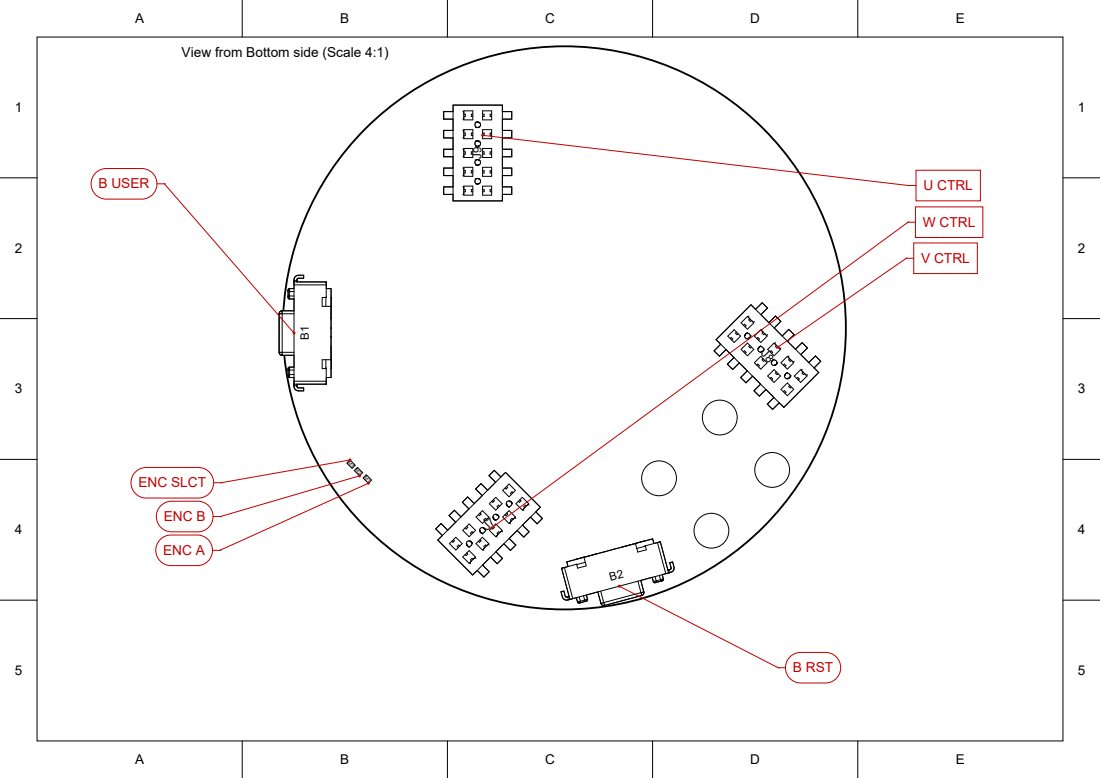
[picture p38: page 4]

View from Bottom side (Scale 4:1)

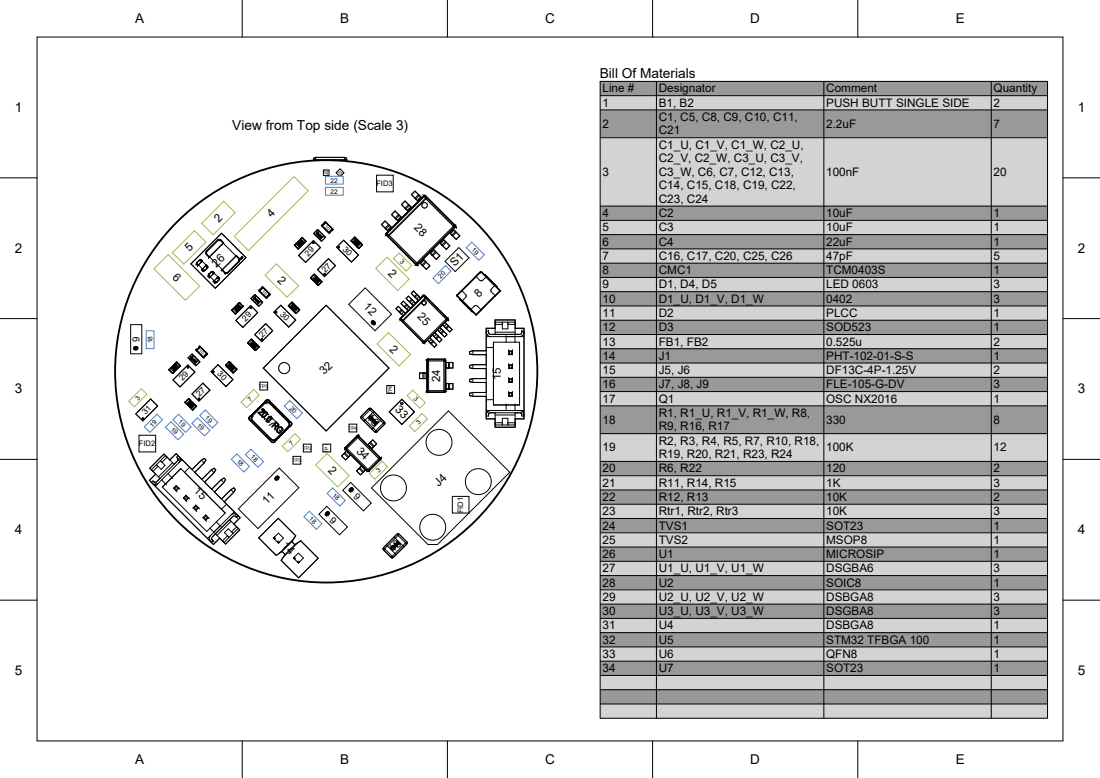
[picture p39: page 5]

B1, B2 | PUSH BUTT SINGLE SIDE | Quantity 27
Designator | Comment
Line # 123456789 | C1_U, C1_V, C1_W, C2_U, C2_V, C2_W, C3_U, C3_V, C3_W, C6, C7, C12, C13, C14, C15, C18, C19, C22, C23, C24 | 100nF

View from Top side (Scale 3)

C2 | 10uF
C3 | 10uF
C4 | 22uF

CMC1 | TCM0403S
D1, D4, D5 | LED 0603

10 | D1_U, D1_V, D1_W | 0402
11 | D2 | PLCC
12 | D3 | SOD523
13 | FB1, FB2 | 0.525u
14 | J1 | PHT-102-01-S-S
15 | J5, J6 | DF13C-4P-1.25V
16 | J7, J8, J9 | FLE-105-G-DV
17 | Q1 | OSC NX2016

23 | Rtr1, Rtr2, Rtr3 | 10K | 12232311131331111
20 | R6, R22 | 120
21 | R11, R14, R15 | 1K
22 | R12, R13 | 10K

24 | TVS1 | SOT23
25 | TVS2 | MSOP8
26 | U1 | MICROSIP
27 | U1_U, U1_V, U1_W | DSGBA6
28 | U2 | SOIC8
29 | U2_U, U2_V, U2_W | DSBGA8
30 | U3_U, U3_V, U3_W | DSGBA8
31 | U4 | DSBGA8
32 | U5 | STM32 TFBGA 100
33 | U6 | QFN8
34 | U7 | SOT23

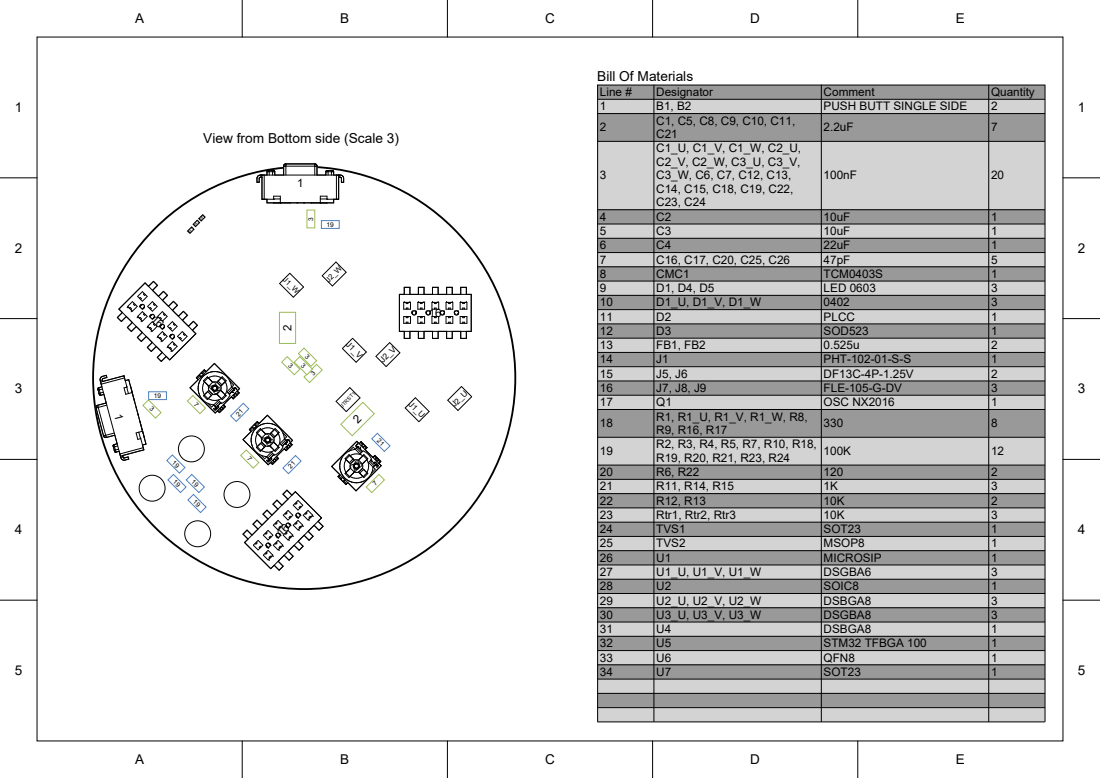
[picture p40: page 6]
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

View from Bottom side (Scale 3)

CMC1 | TCM0403S
D1, D4, D5 | LED 0603

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

19 | R2, R3, R4, R5, R7, R10, R18, R19, R20, R21, R23, R24 | 100K
23 | Rtr1, Rtr2, Rtr3 | 10K | 12232311131331111
20 | R6, R22 | 120
21 | R11, R14, R15 | 1K
22 | R12, R13 | 10K

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

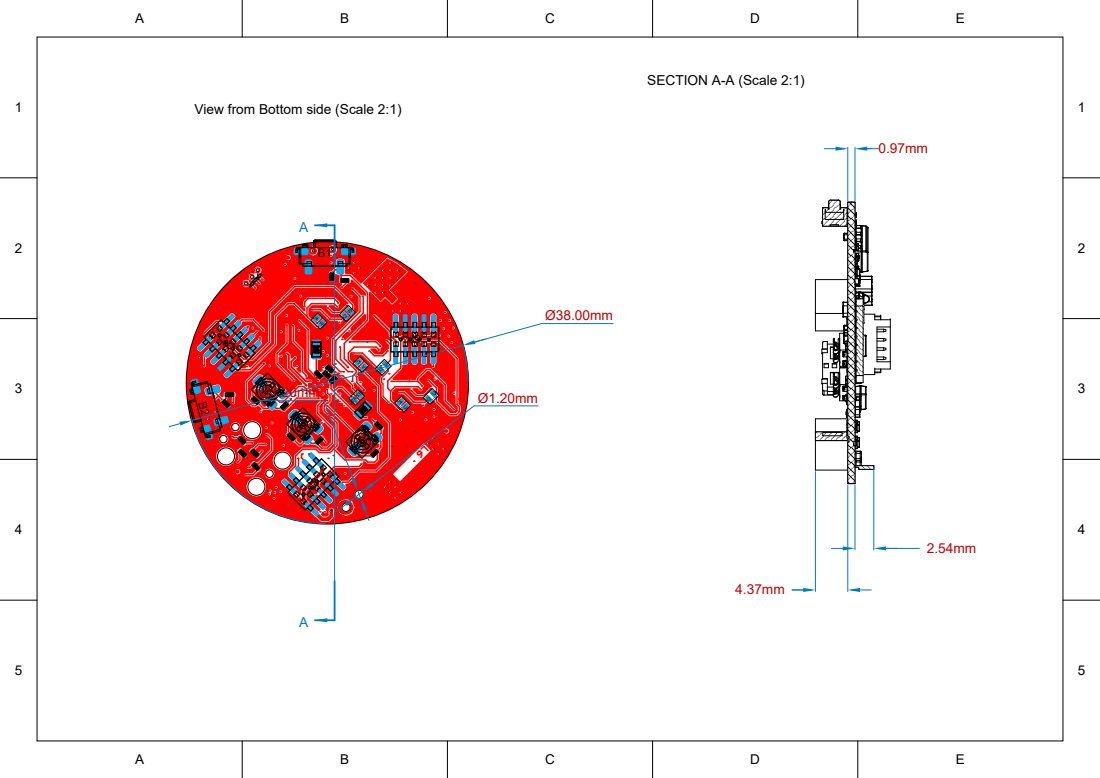
[picture p41: page 7]

View from Bottom side (Scale 2:1)

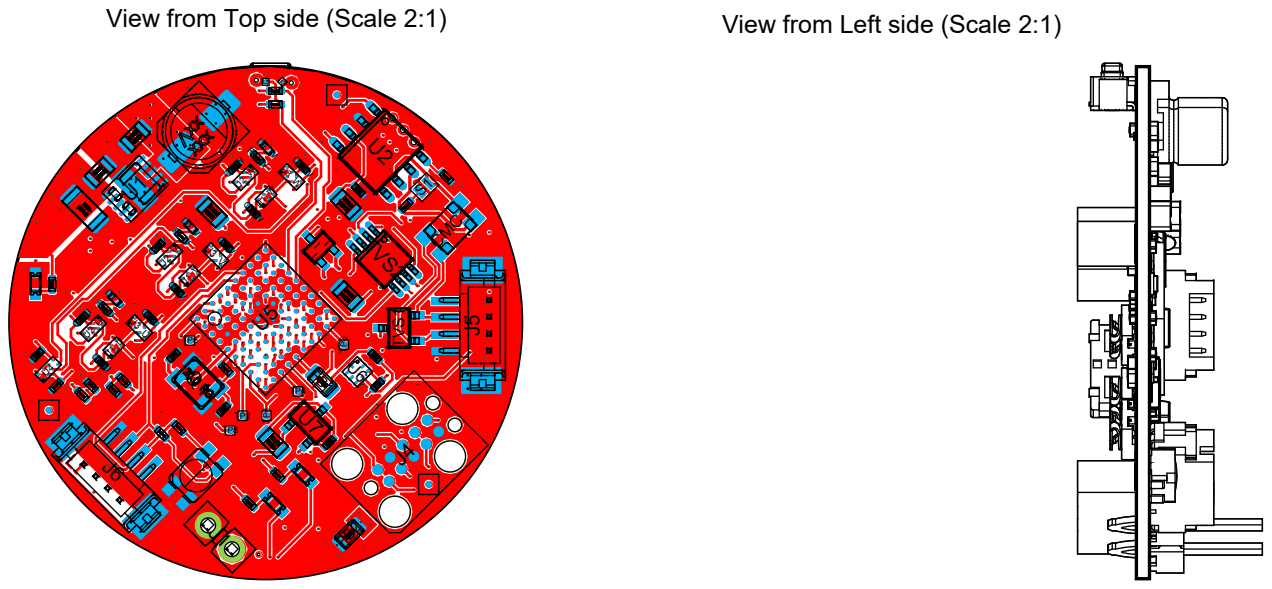
[picture p42: page 8]

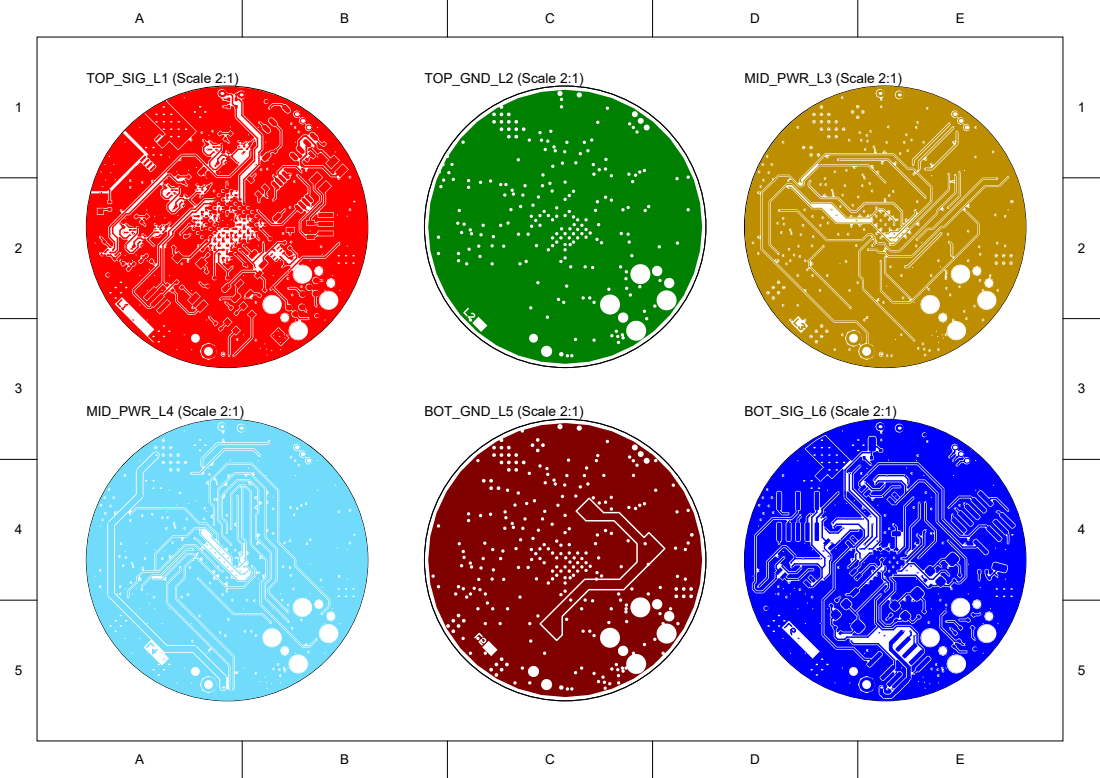
[picture p43: page 9]

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
