Ahmeddiab1/TRI-MD_EVAL/1-HARDWARE/1-MD_EVAL/4-GENERATED/PDF/SCHEMATICS.PDF

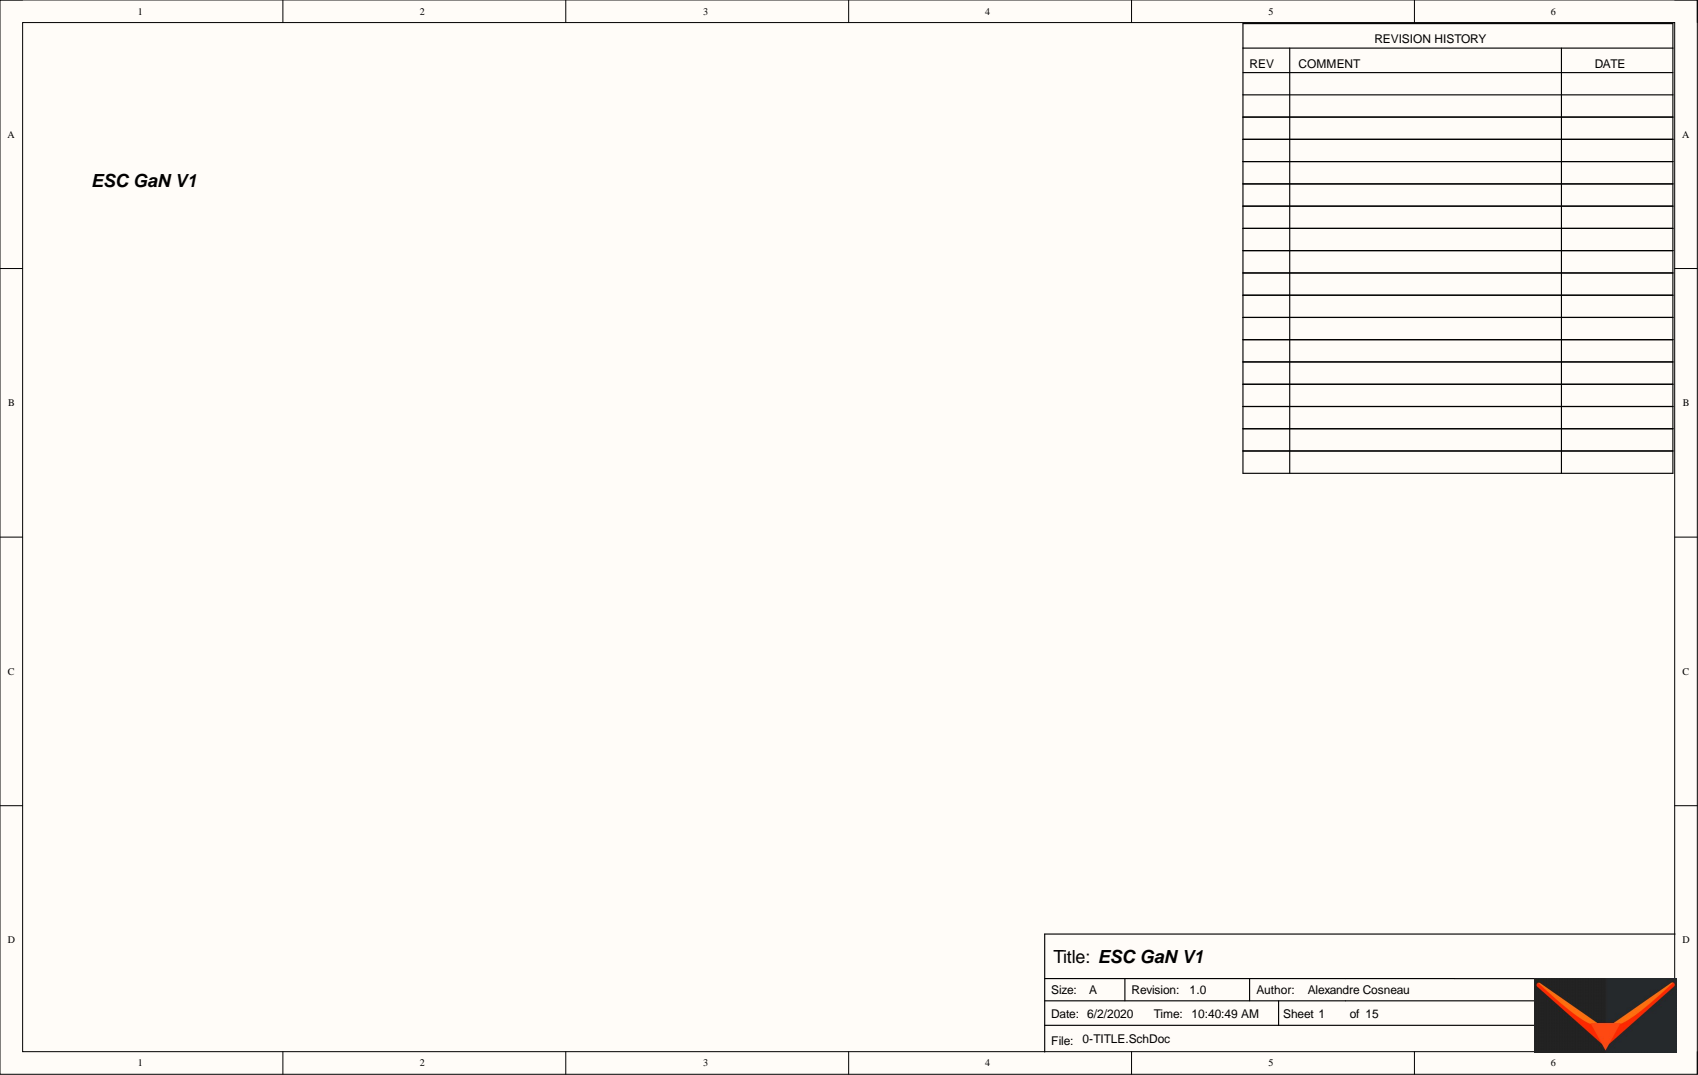
[picture p44: page 1]

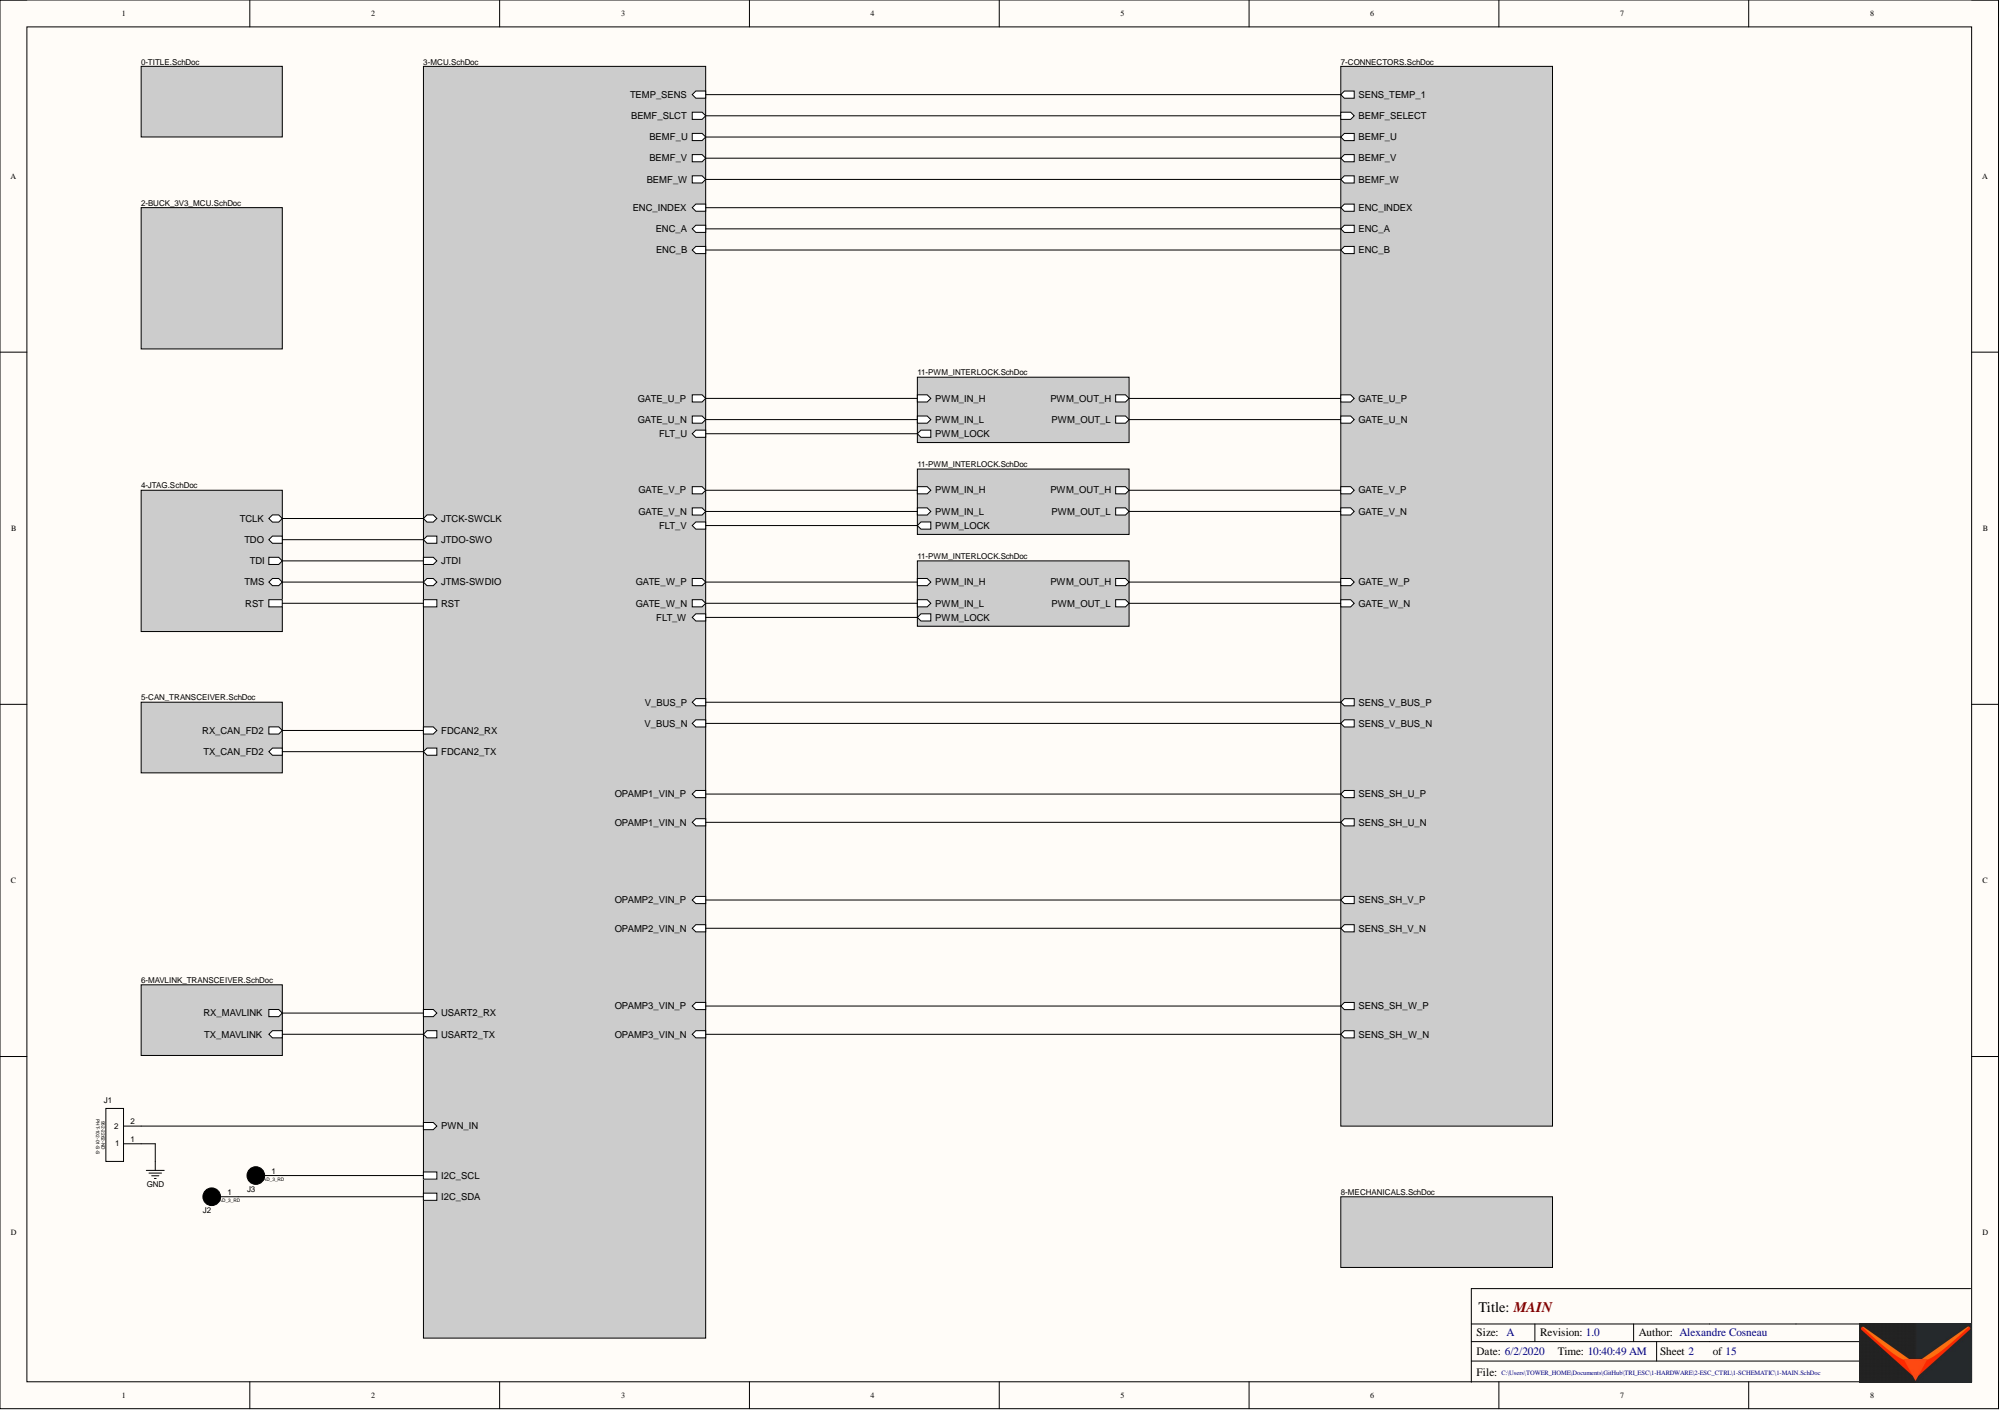
[picture p45: page 2]

C:\Users\TOWER_HOME\Documents\GitHub\TRI_ESC\1-HARDWARE\2-ESC_CTRL\1-SCHEMATIC\1-MAIN.SchDoc

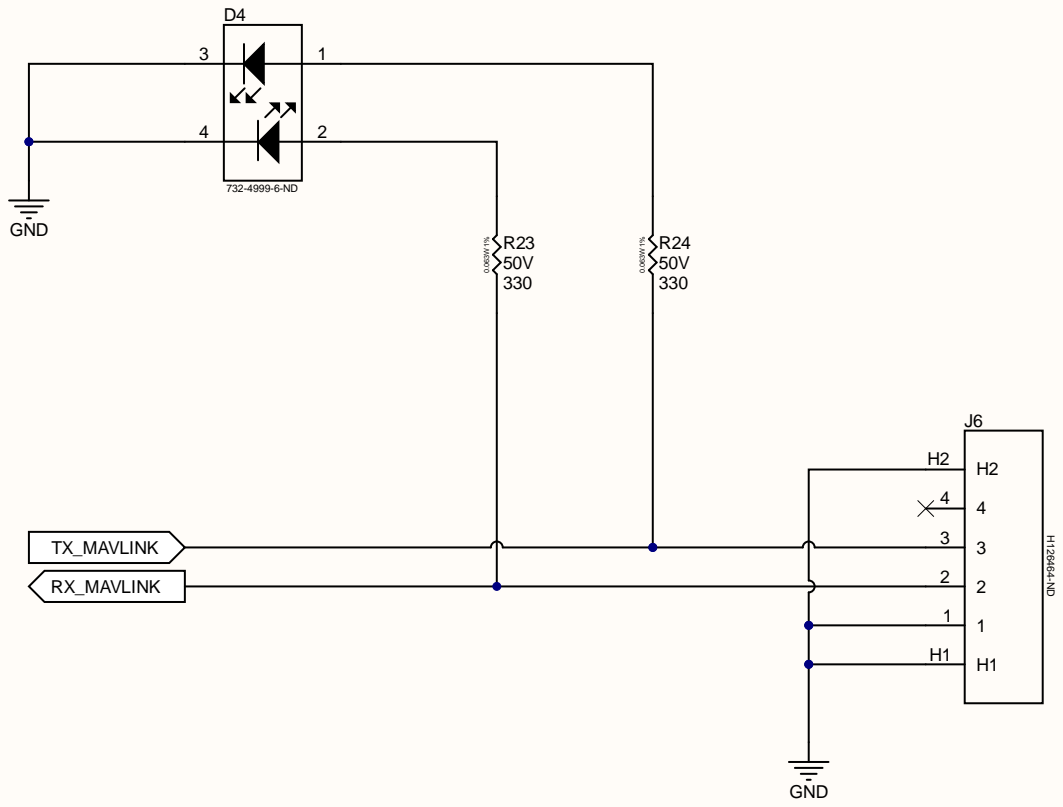
[picture p46: page 3]

C:\Users\TOWER_HOME\Documents\GitHub\TRI_ESC\1-HARDWARE\2-ESC_CTRL\1-SCHEMATIC\6-MAVLINK_TRANSCEIVER.SchDoc

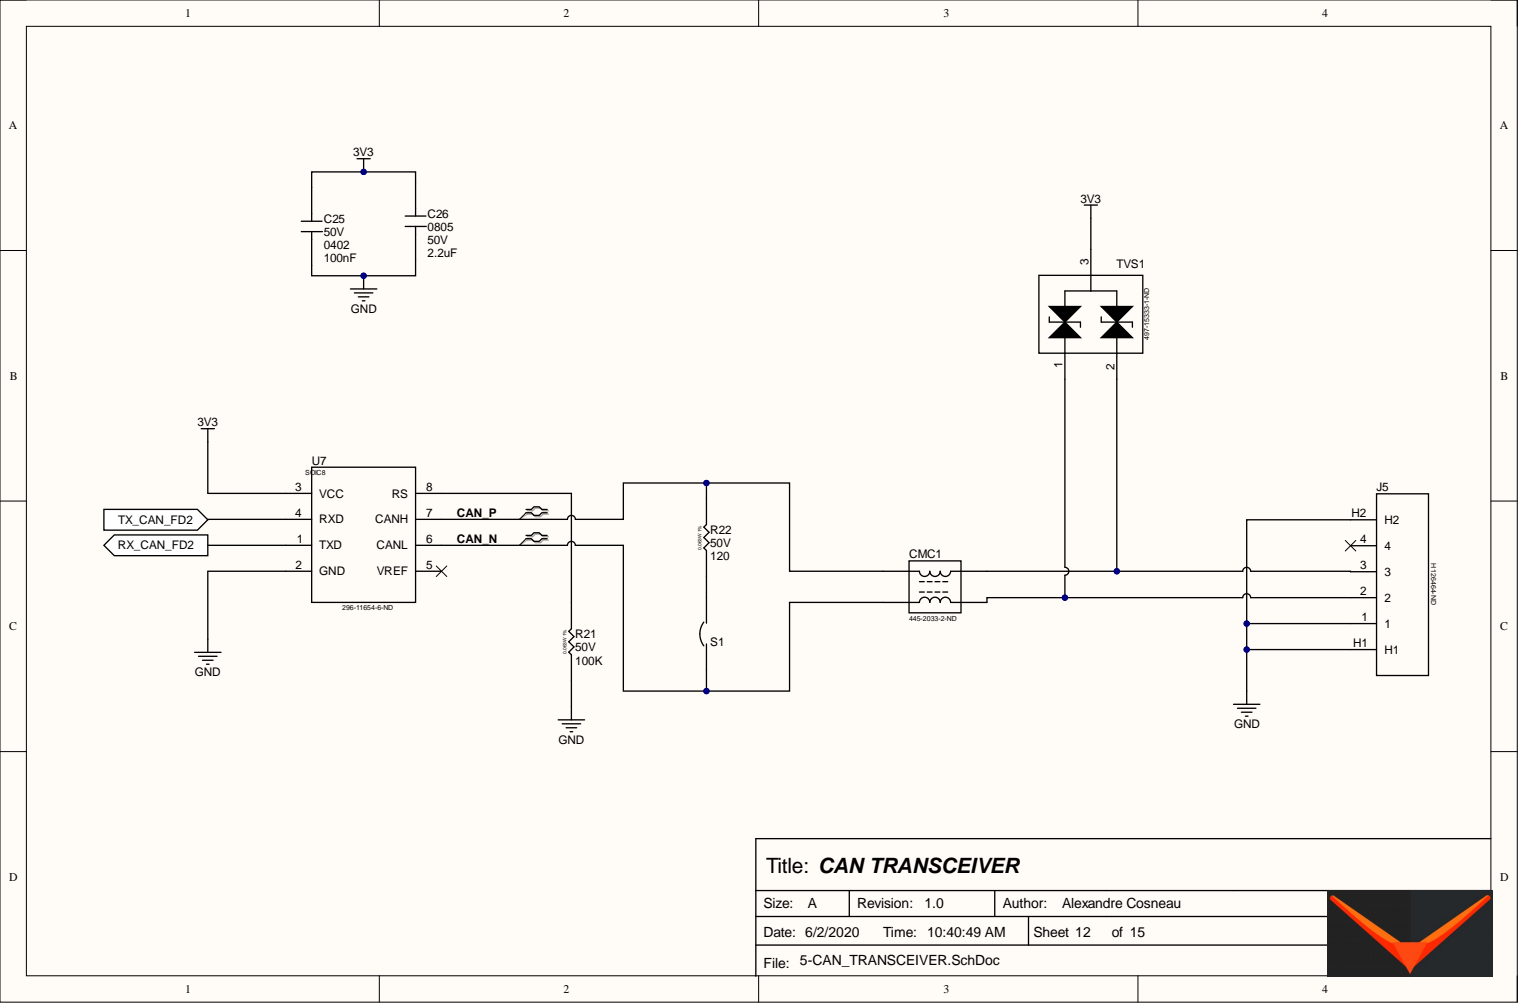
[picture p47: page 4]

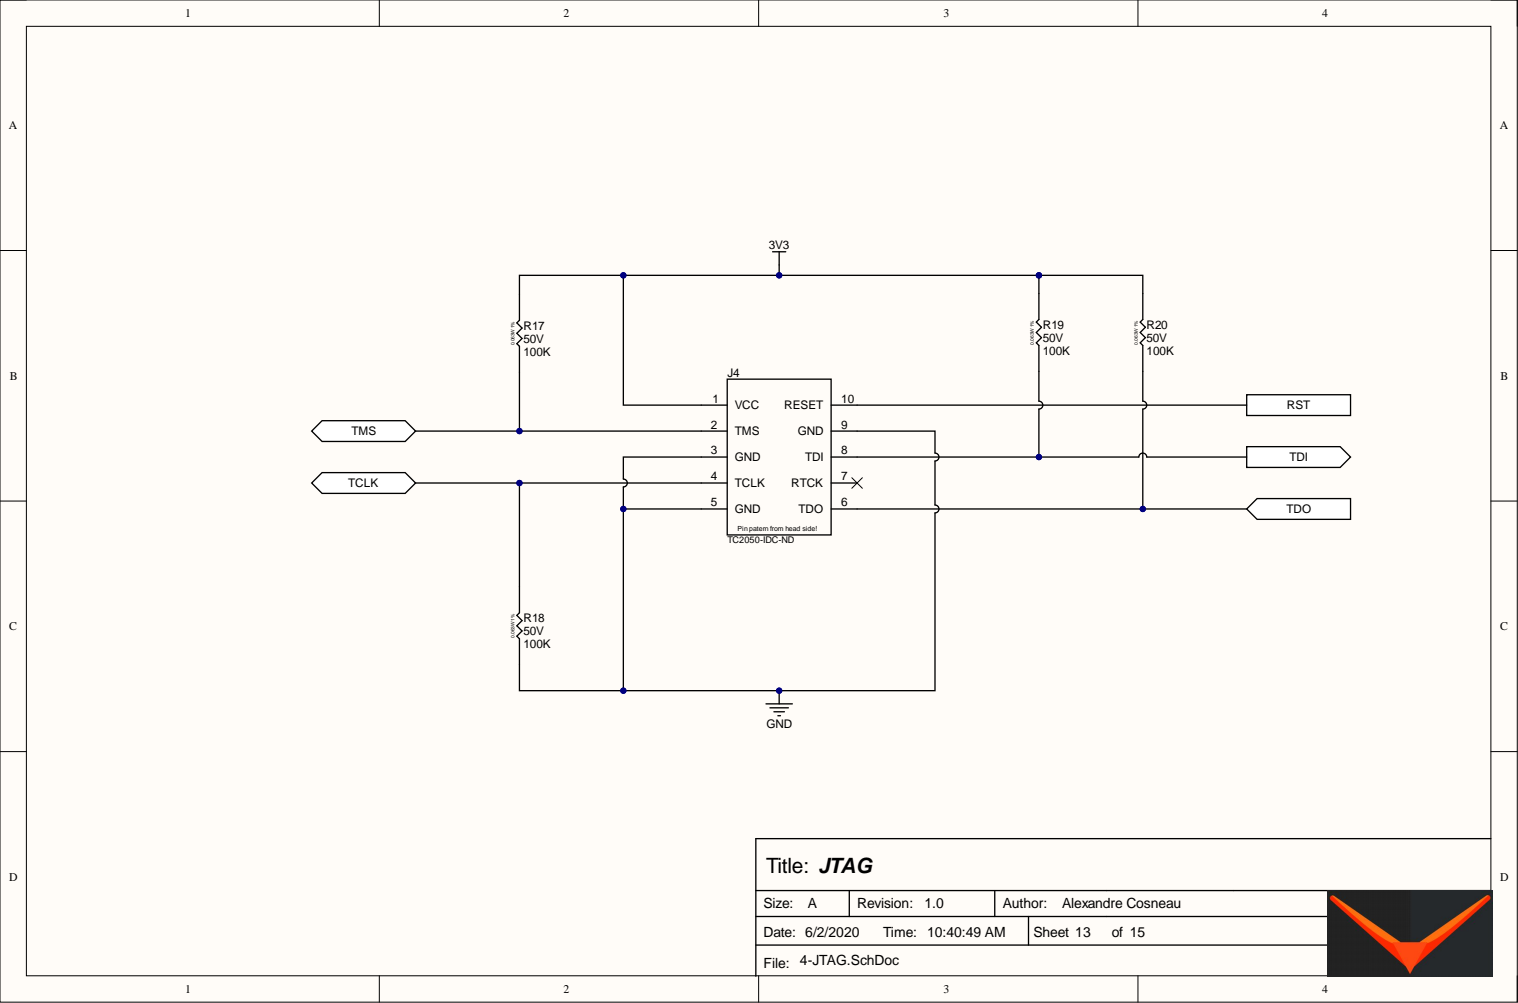
[picture p48: page 5]

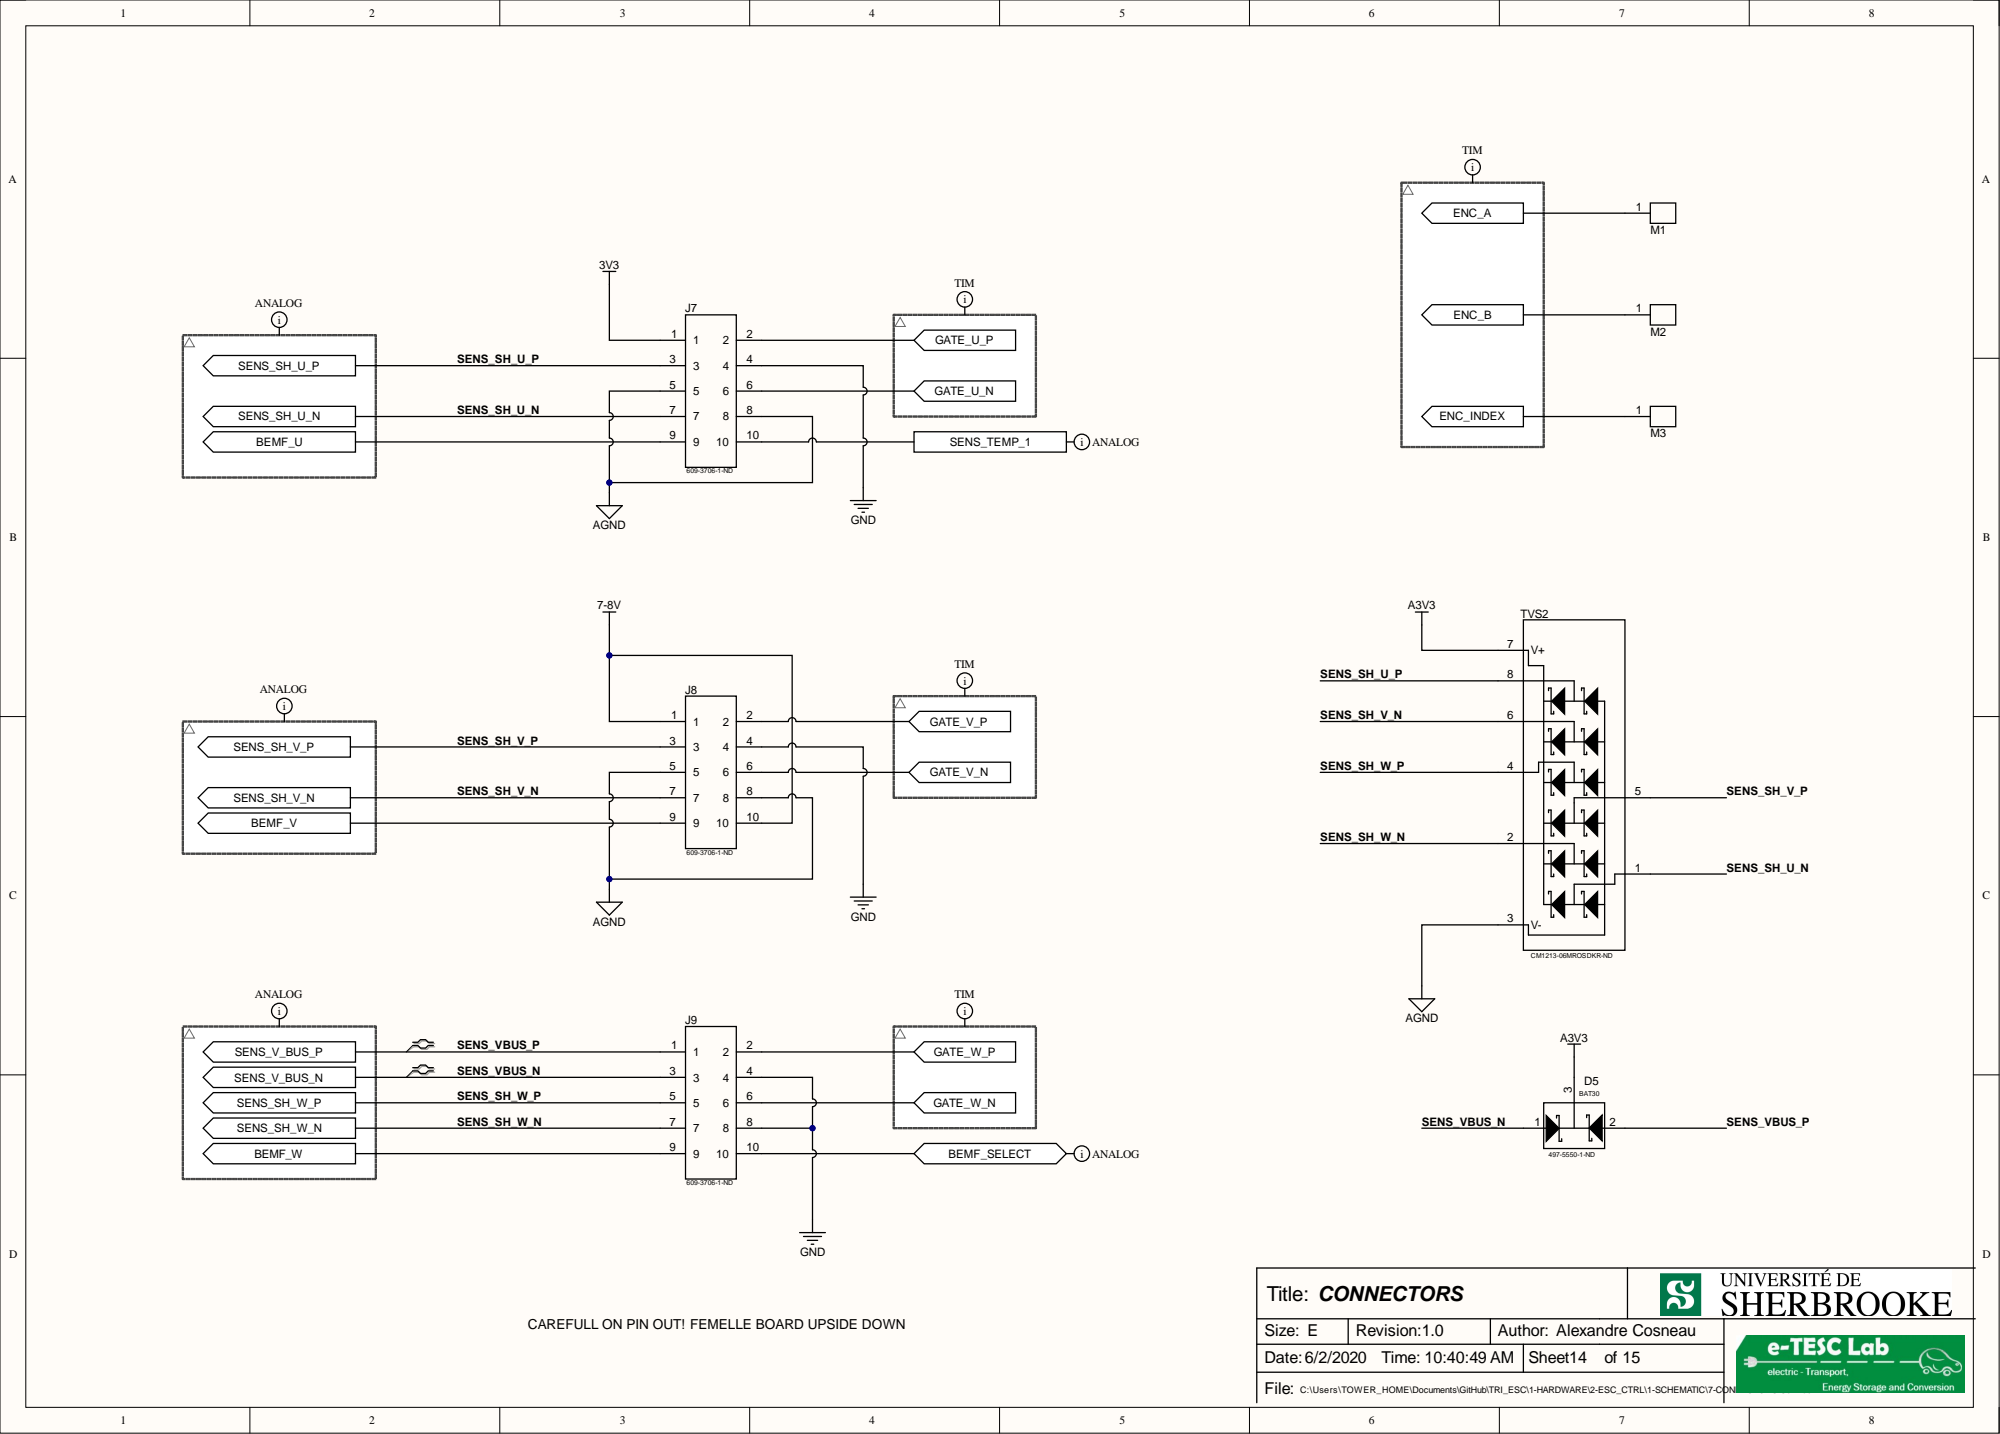
[picture p49: page 6]

C:\Users\TOWER_HOME\Documents\GitHub\TRI_ESC\1-HARDWARE\2-ESC_CTRL\1-SCHEMATIC\7-CONNECTORS.SchDoc

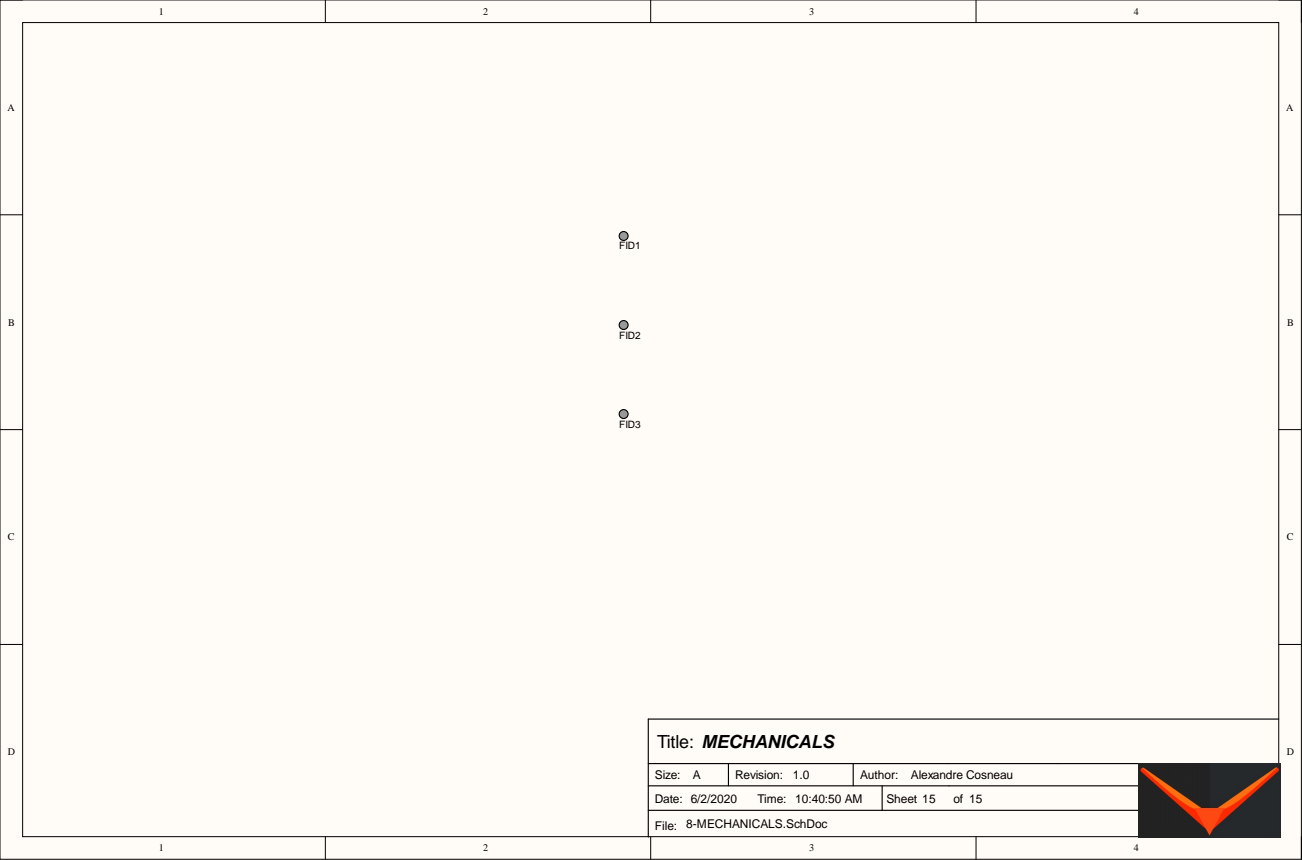
[picture p50: page 7]

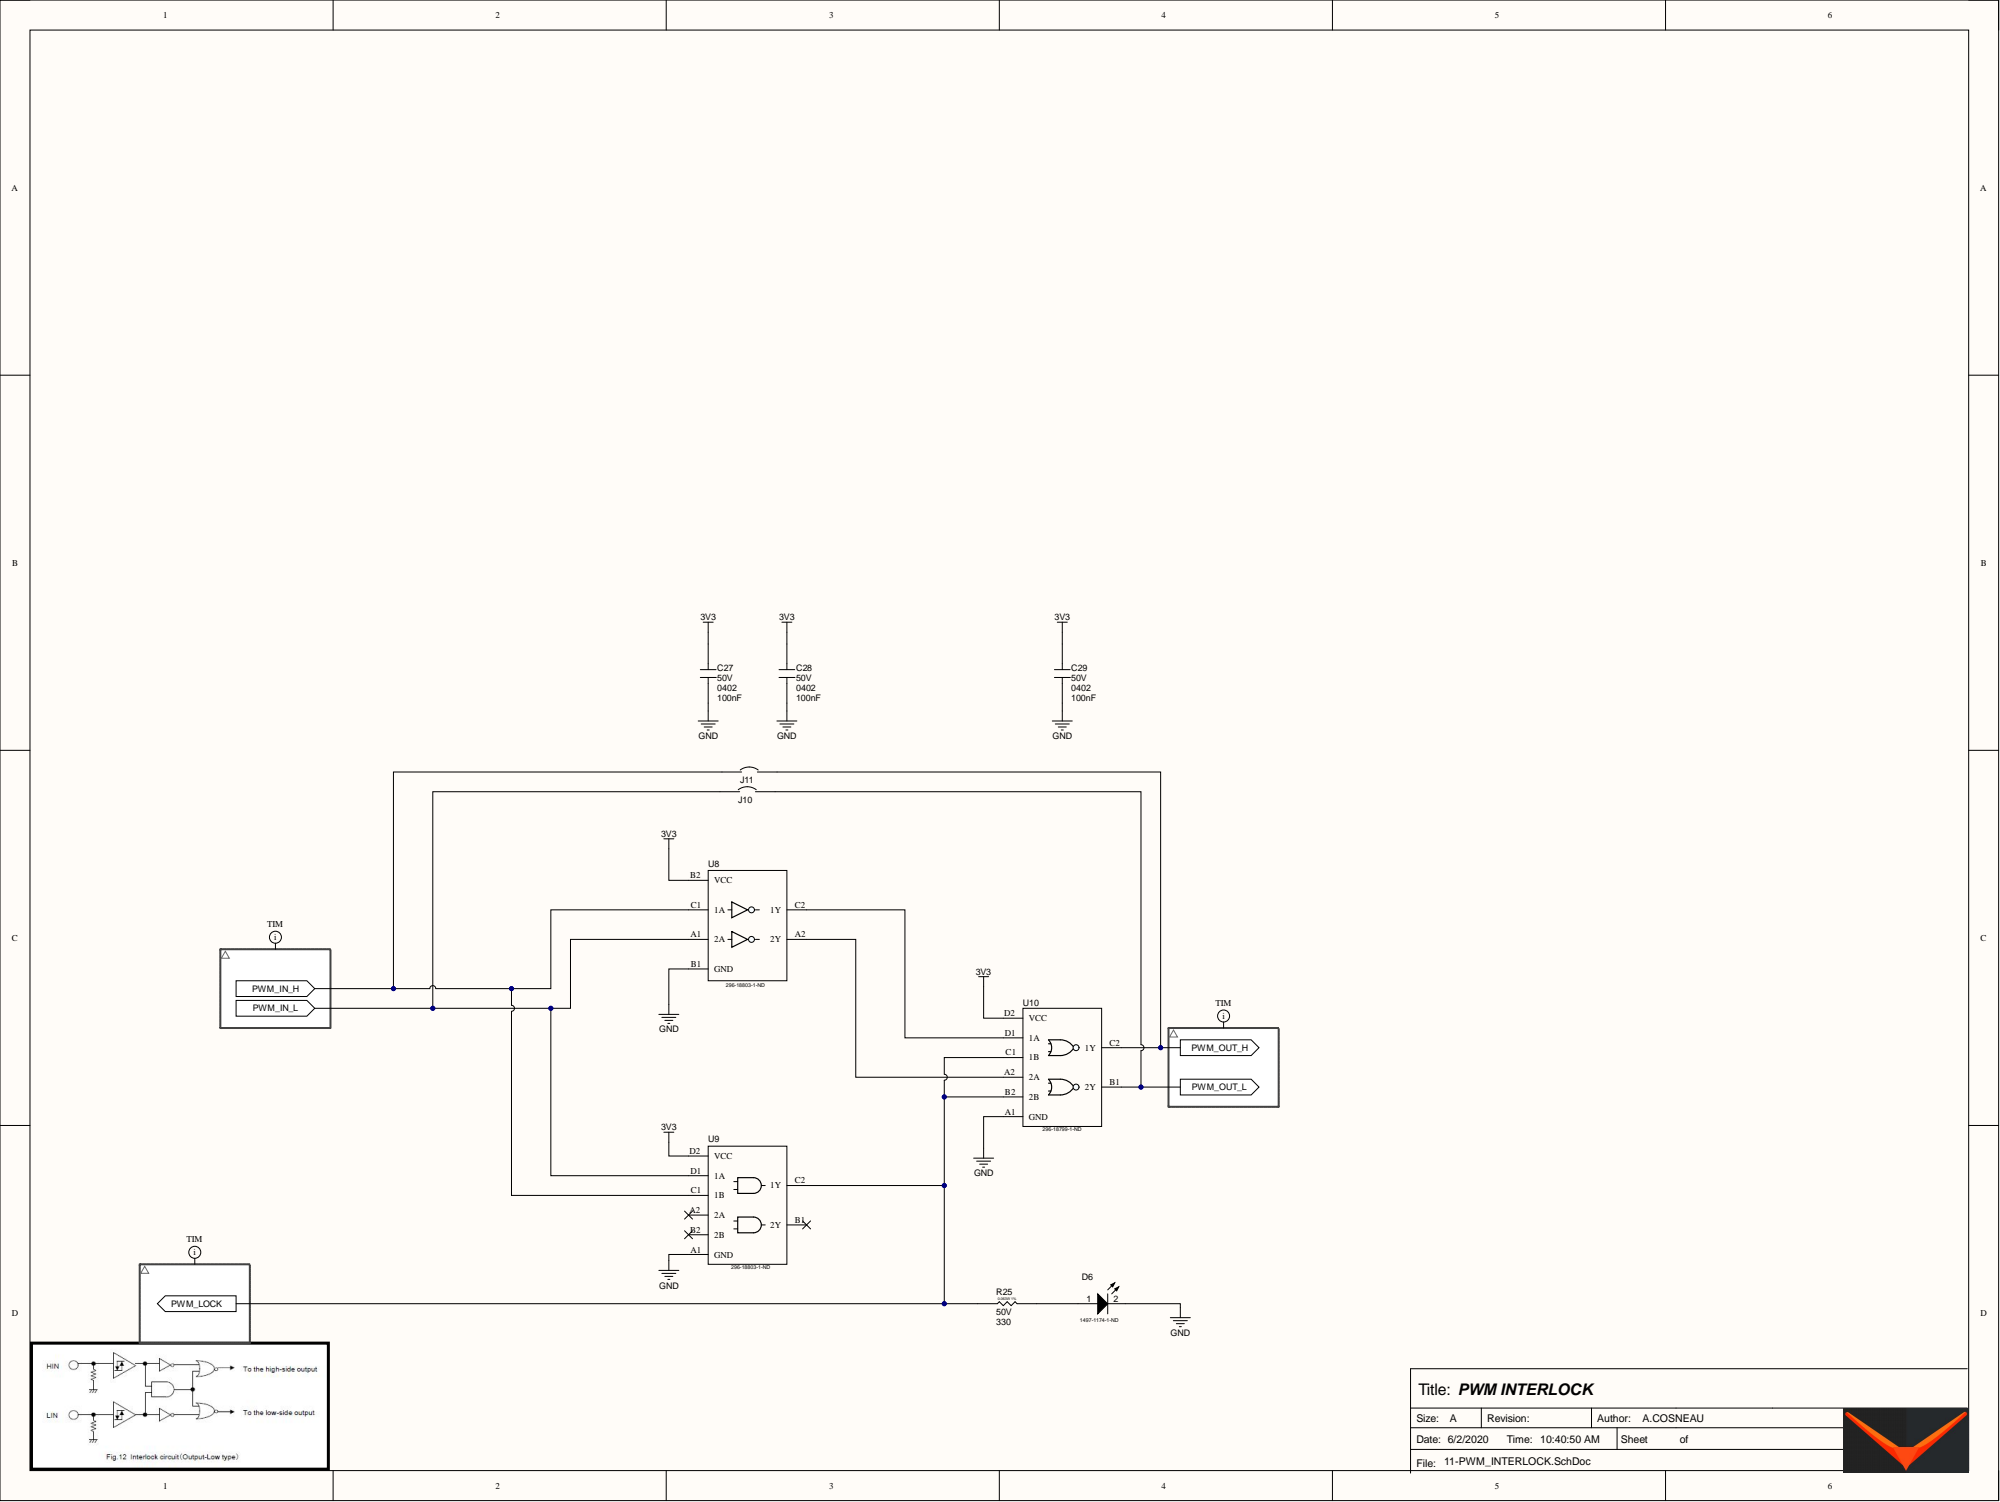
[picture p51: page 8]

VCC B2

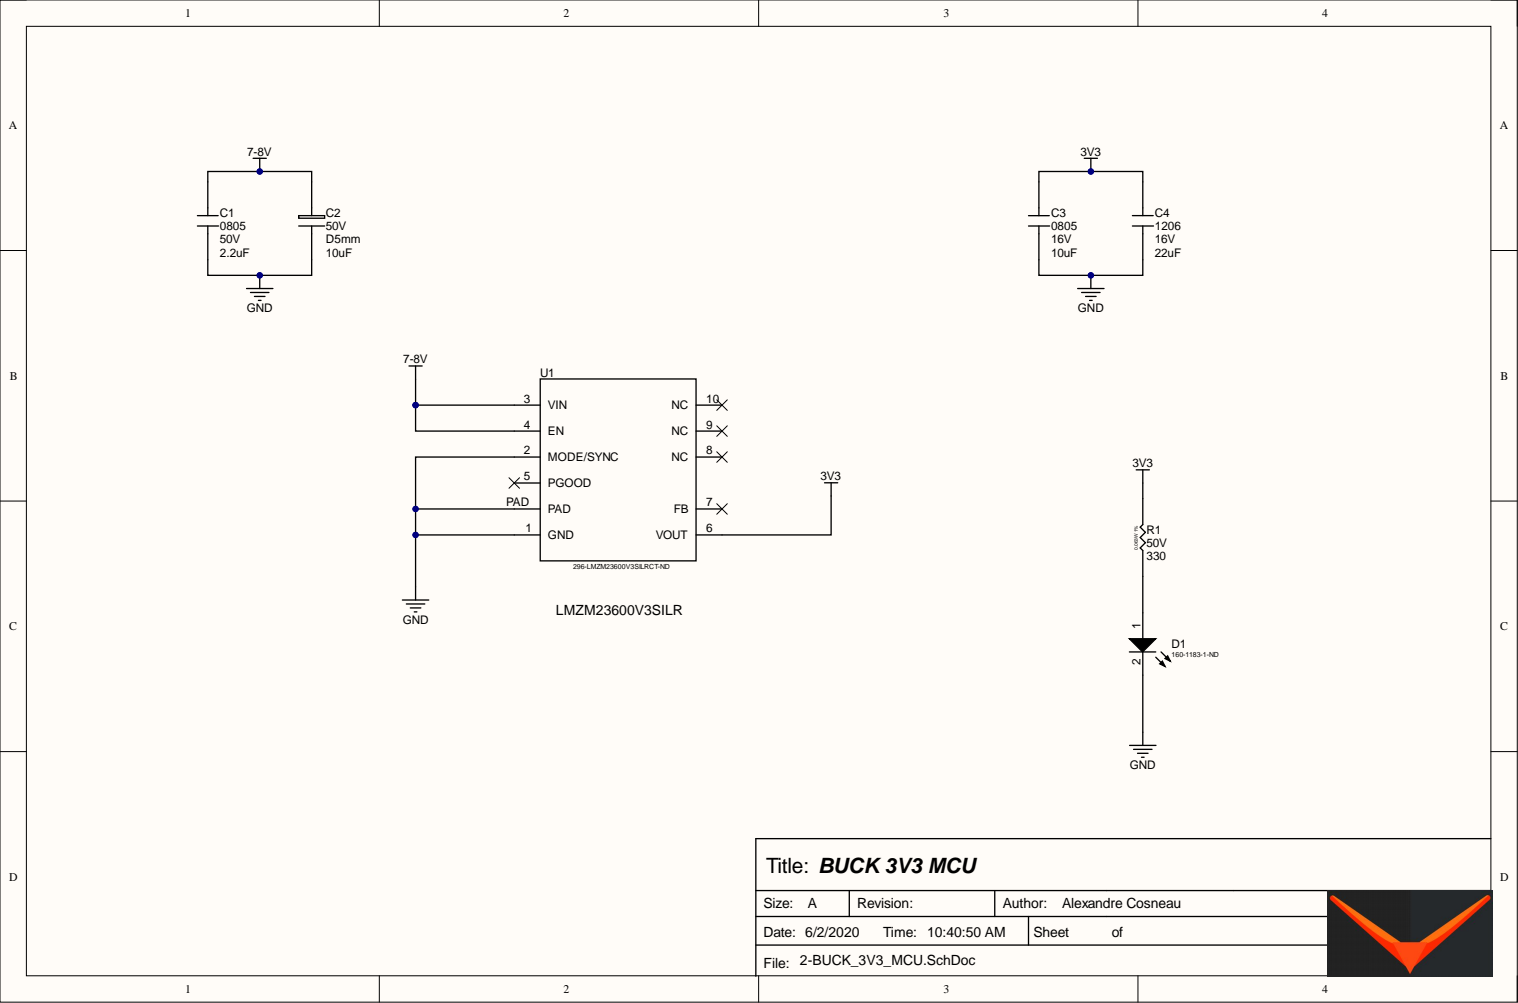
[picture p52: page 9]

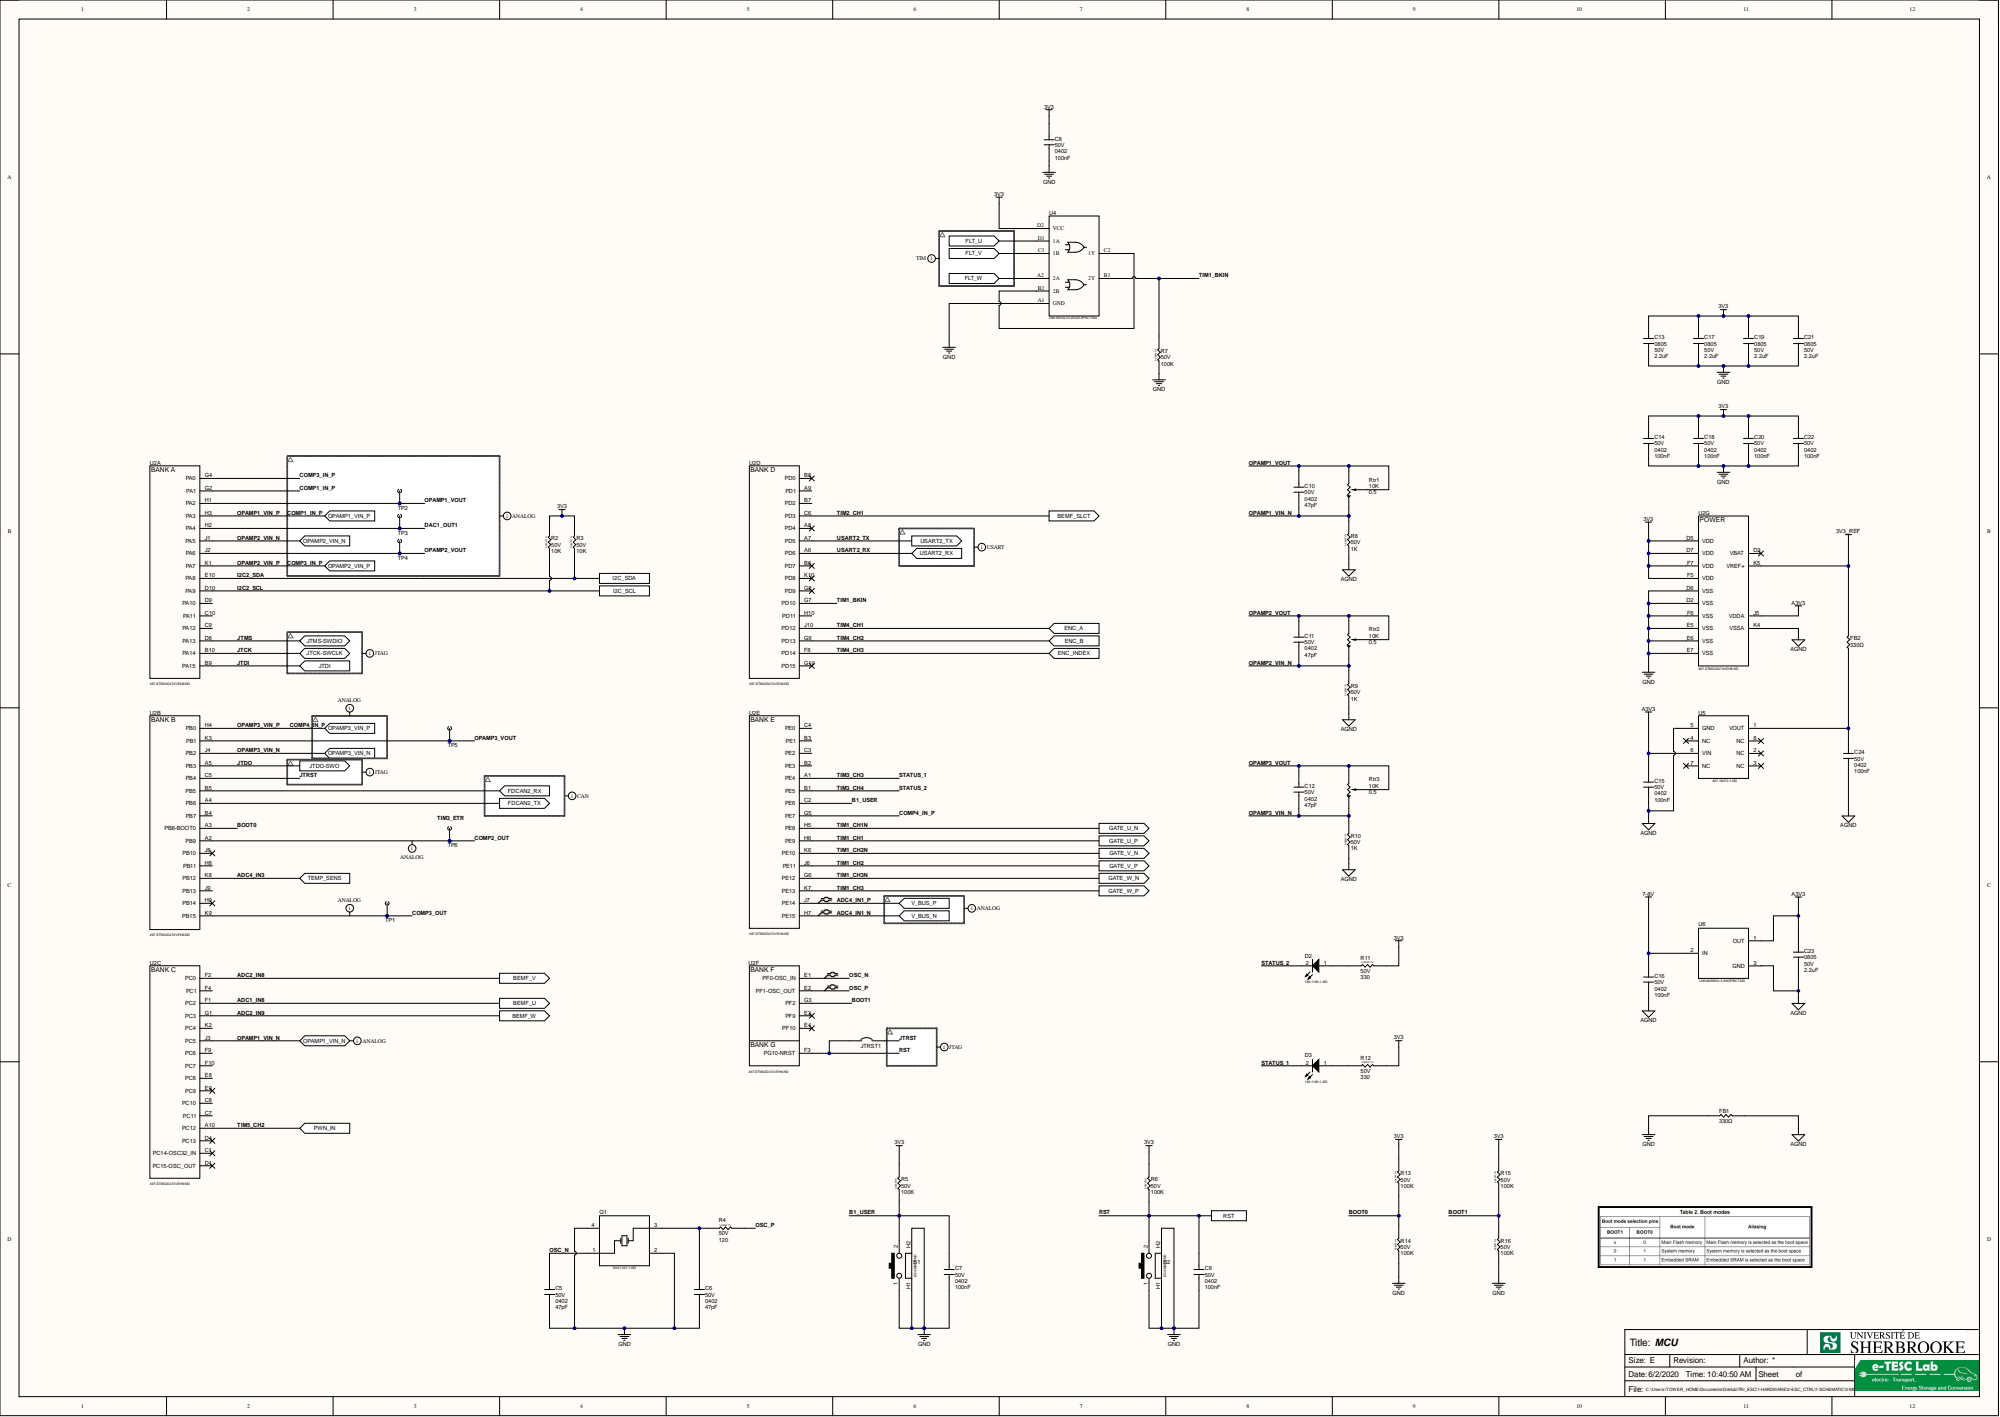
[picture p53: page 10]

GND A1

COMP3_IN_P COMP1_IN_P TP2 COMP1_IN_P OPAMP1_VIN_P OPAMP1_VIN_P TP3 OPAMP2_VIN_N OPAMP2_VIN_N TP4 COMP3_IN_P OPAMP2_VIN_P OPAMP2_VIN_P

VDD D7

VDD F5 | A3V3

VSS D6

VSS D2

VSS F6

VSS E6

C:\Users\TOWER_HOME\Documents\GitHub\TRI_ESC\1-HARDWARE\2-ESC_CTRL\1-SCHEMATIC\3-MCU.SchDoc
