Ahmeddiab1/TRI-MD_EVAL/5-RESEARCH/1-EVM/ESC_G431/SCH_G431_ESC1.pdf

D | D

U1

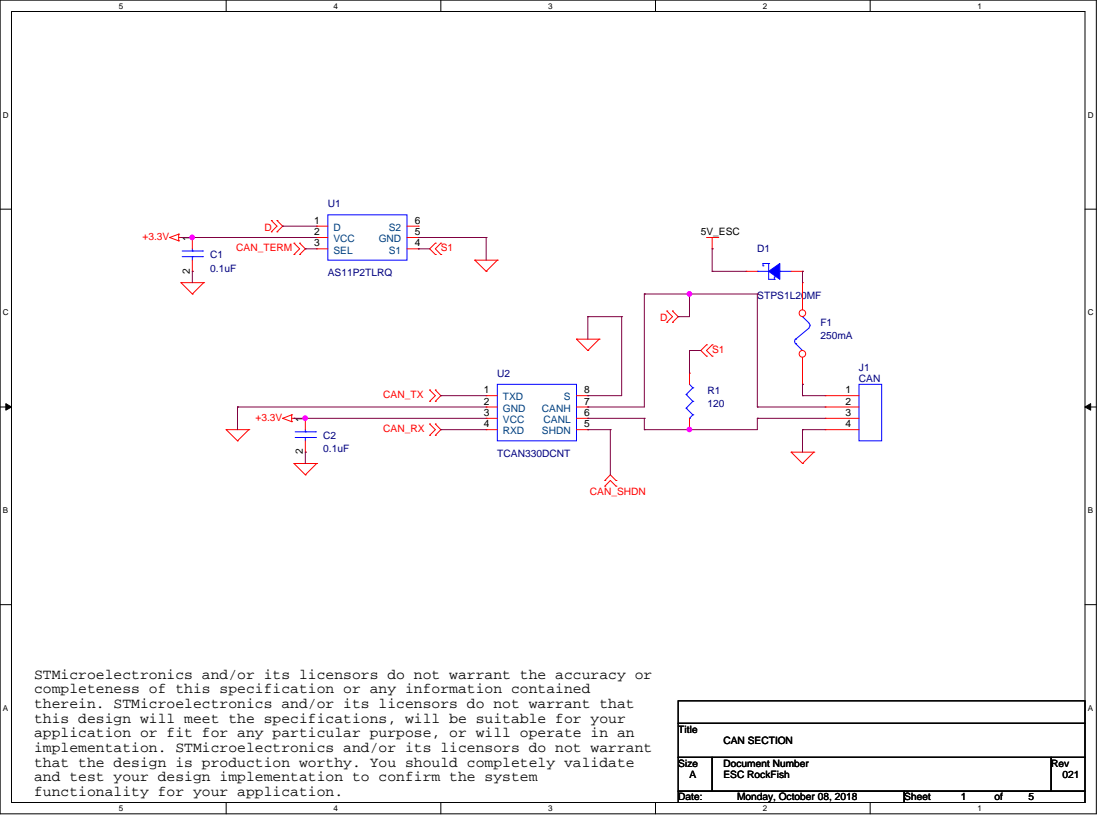
[picture p54: page 1]
5V_ESC; CAN_TX; CAN_RX; CAN_SHDN; CAN_TERM; Title; Size; Document Number; Rev; Date:; Sheet; ESC RockFish; CAN SECTION; Monday, October 08, 2018; STPS1L20MF; TCAN330DCNT; TXD 1 GND 2 VCC 3 RXD 4; SHDN 5; CANL 6; CANH 7; J1 CAN; AS11P2TLRQ; 1 VCC 2 SEL 3; GND 5

STMicroelectronics and/or its licensors do not warrant the accuracy or
completeness of this specification or any information contained
therein. STMicroelectronics and/or its licensors do not warrant that
this design will meet the specifications, will be suitable for your
application or fit for any particular purpose, or will operate in an
implementation. STMicroelectronics and/or its licensors do not warrant
that the design is production worthy. You should completely validate
and test your design implementation to confirm the system
functionality for your application.

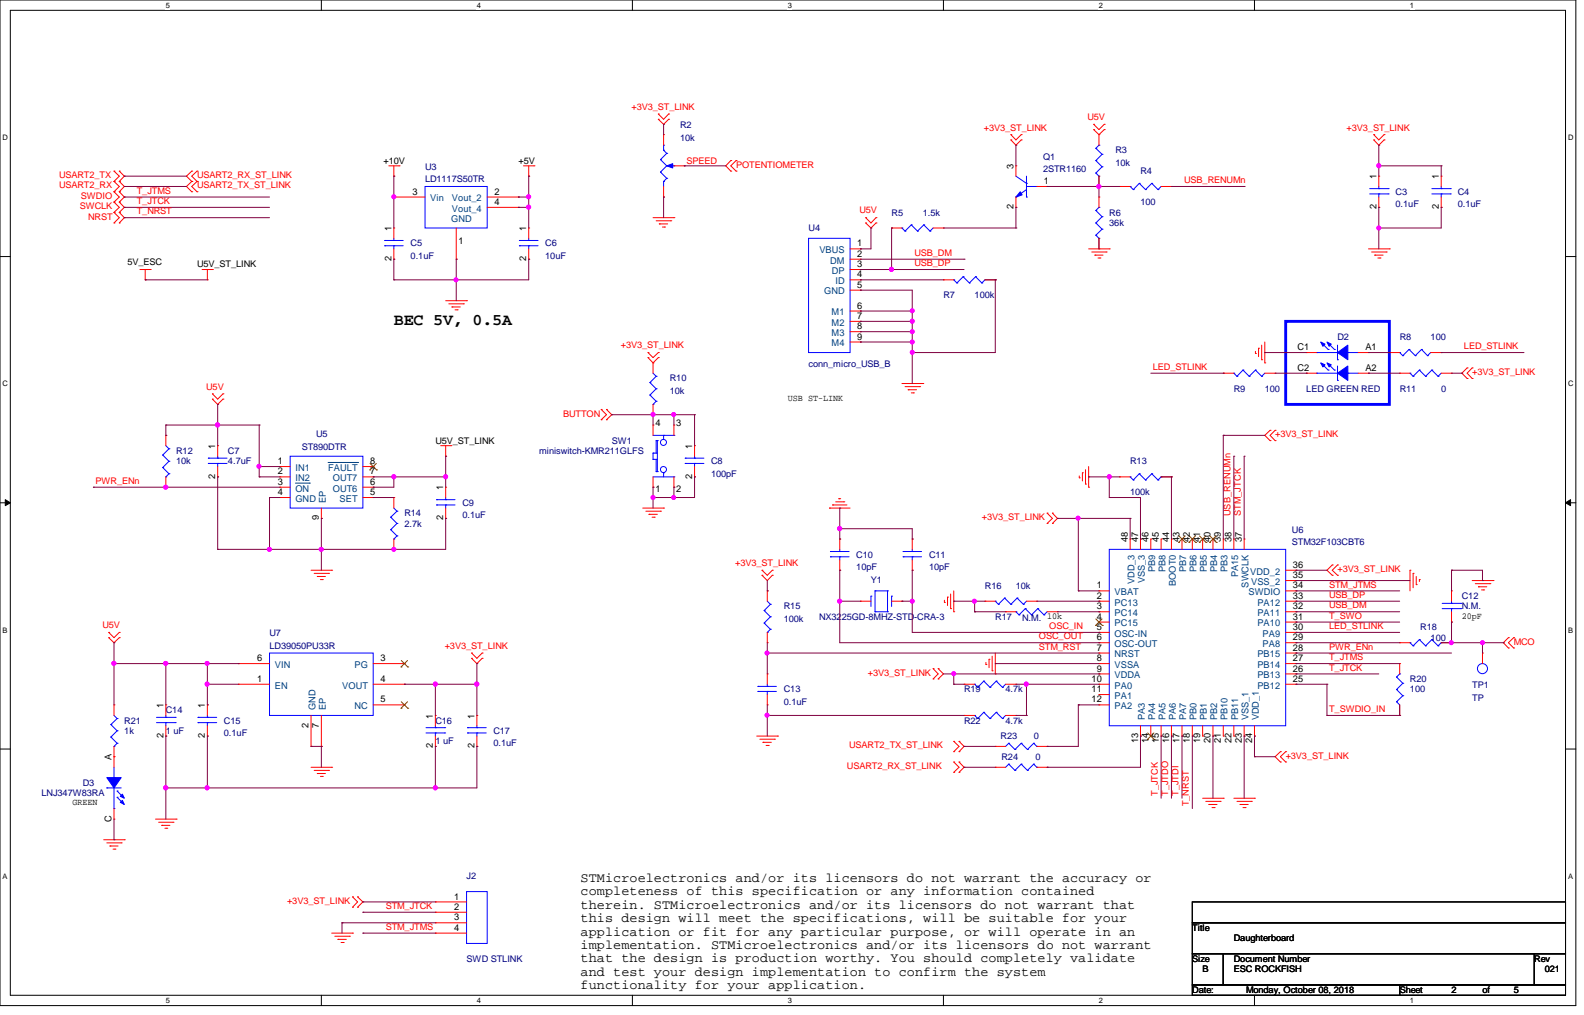
[picture p55: page 2]
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

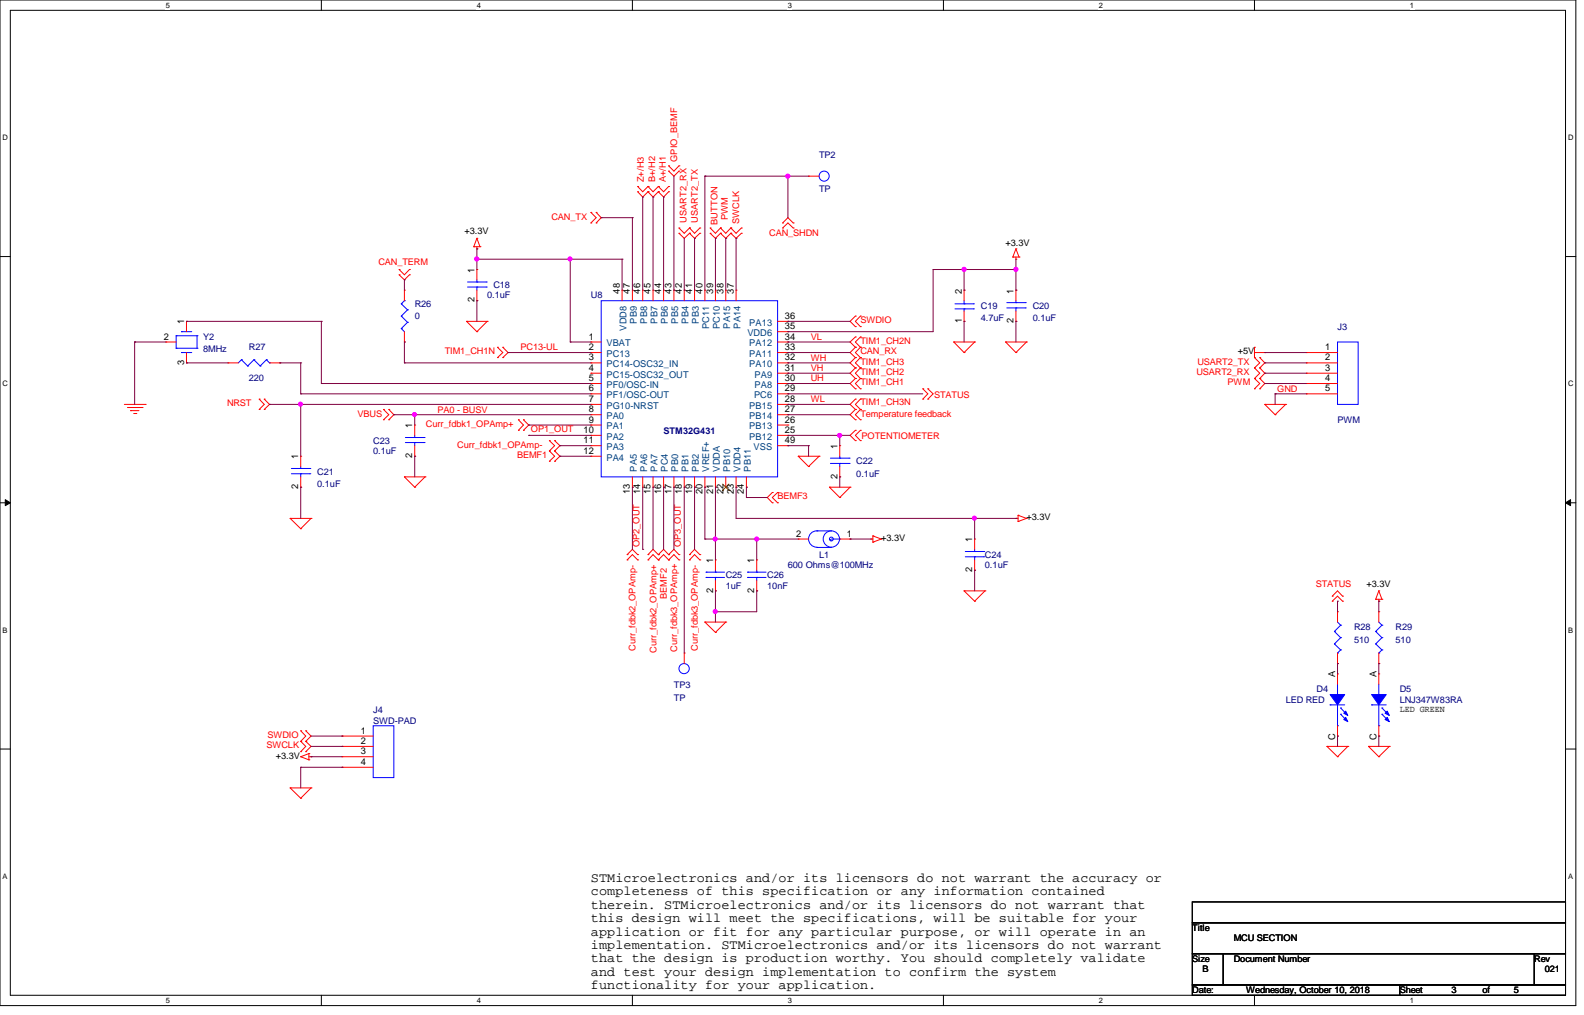
[picture p56: page 3]
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

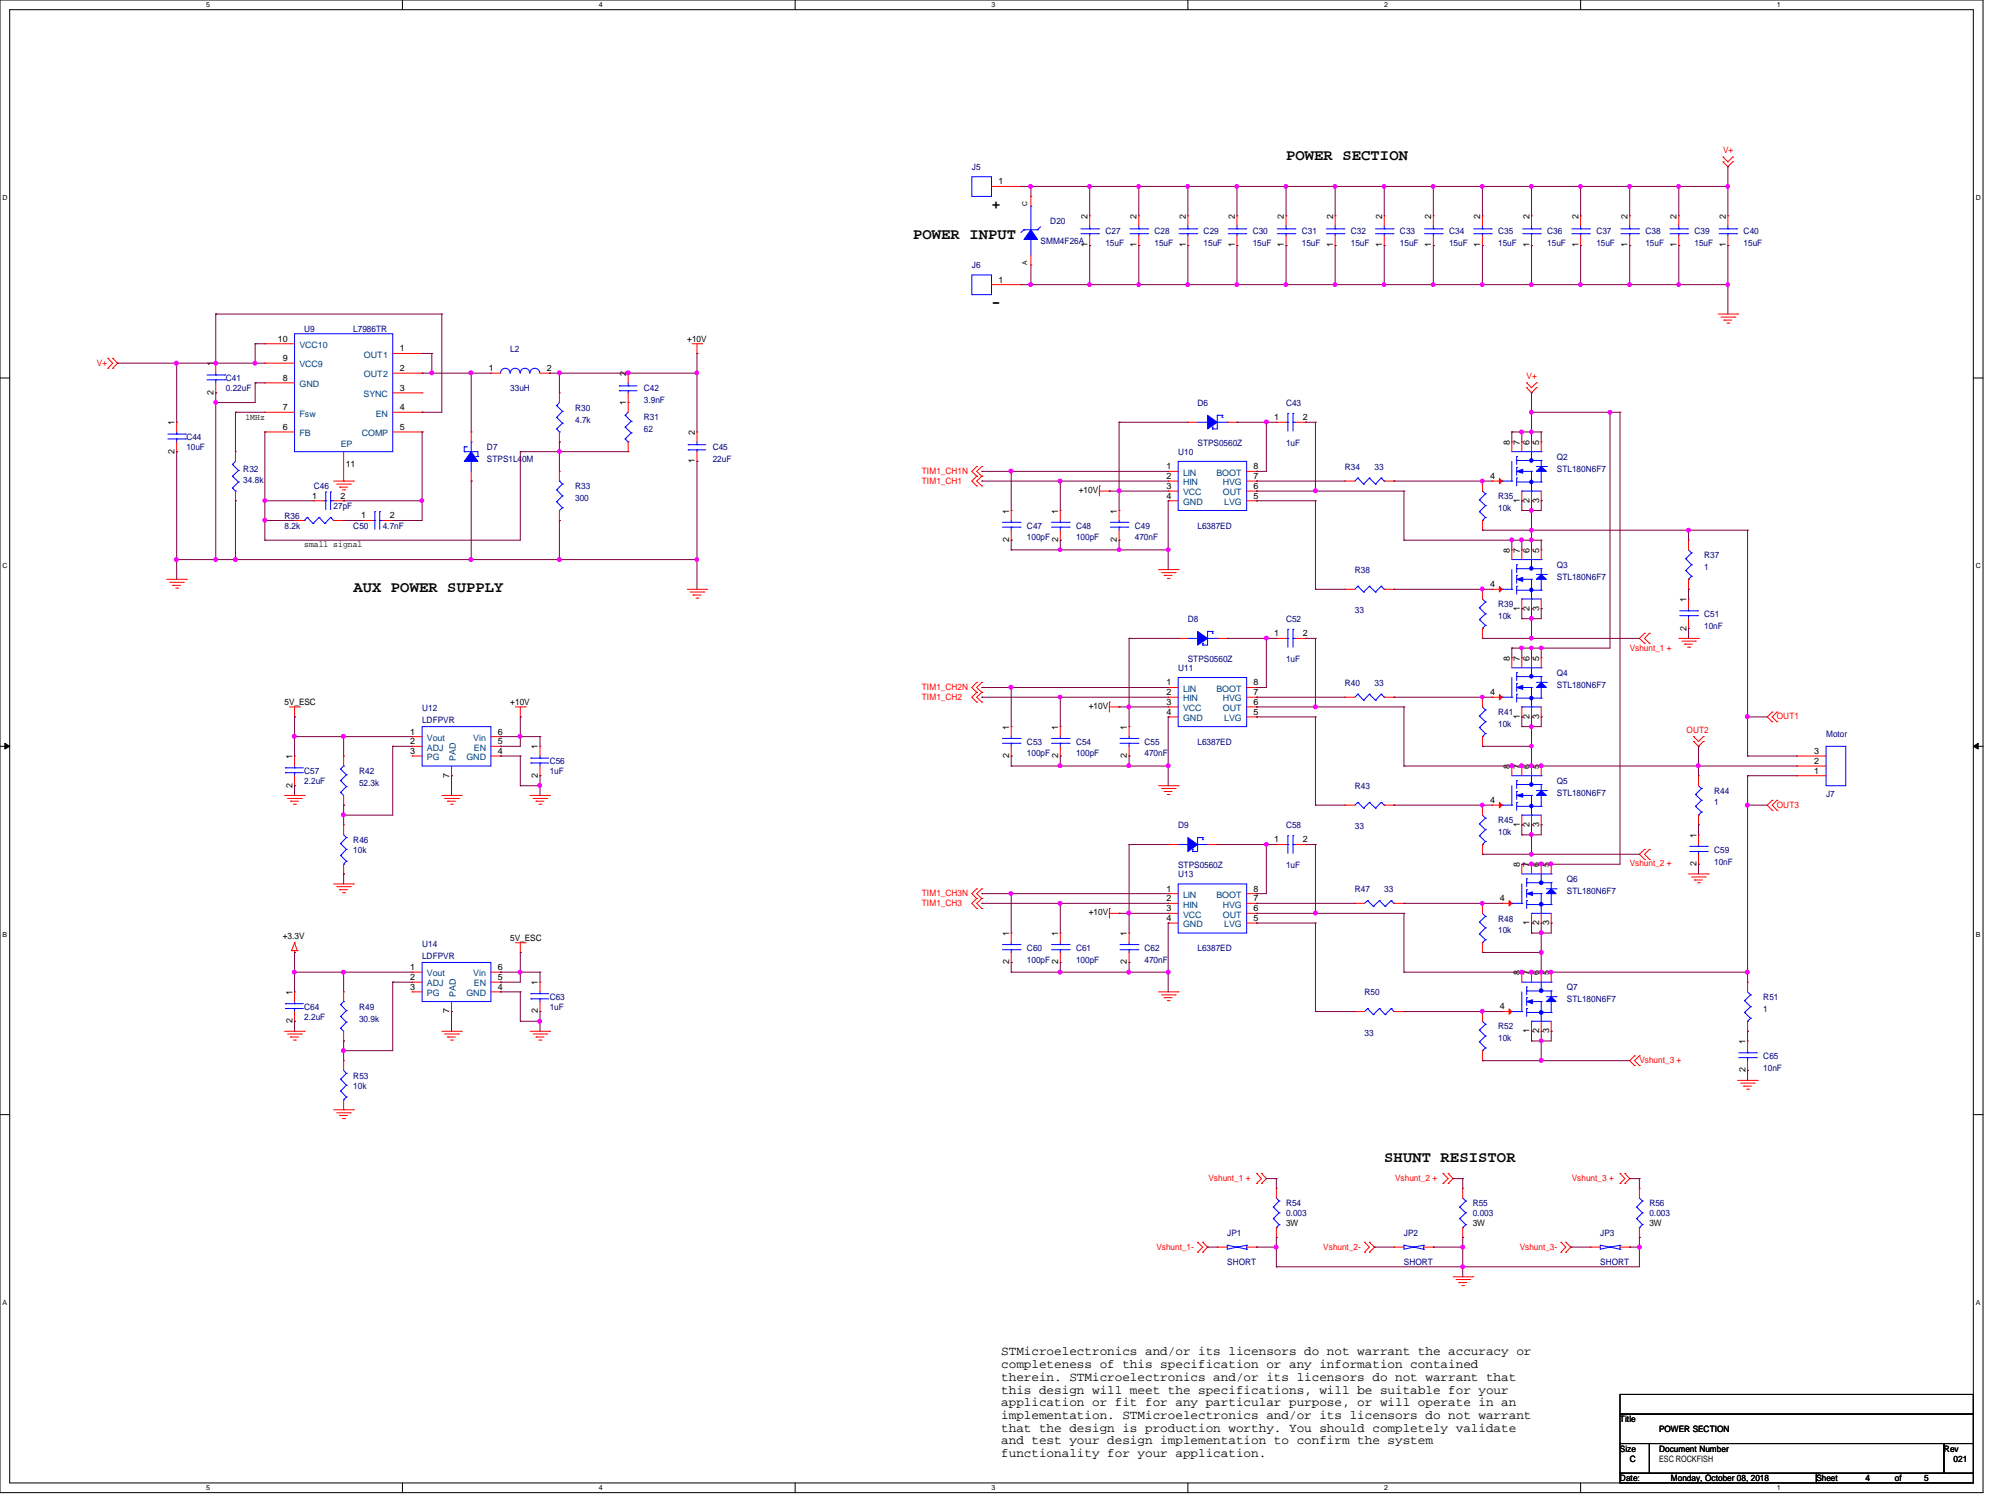
[picture p57: page 4]
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

## BEMF DETECTION- SIX STEP

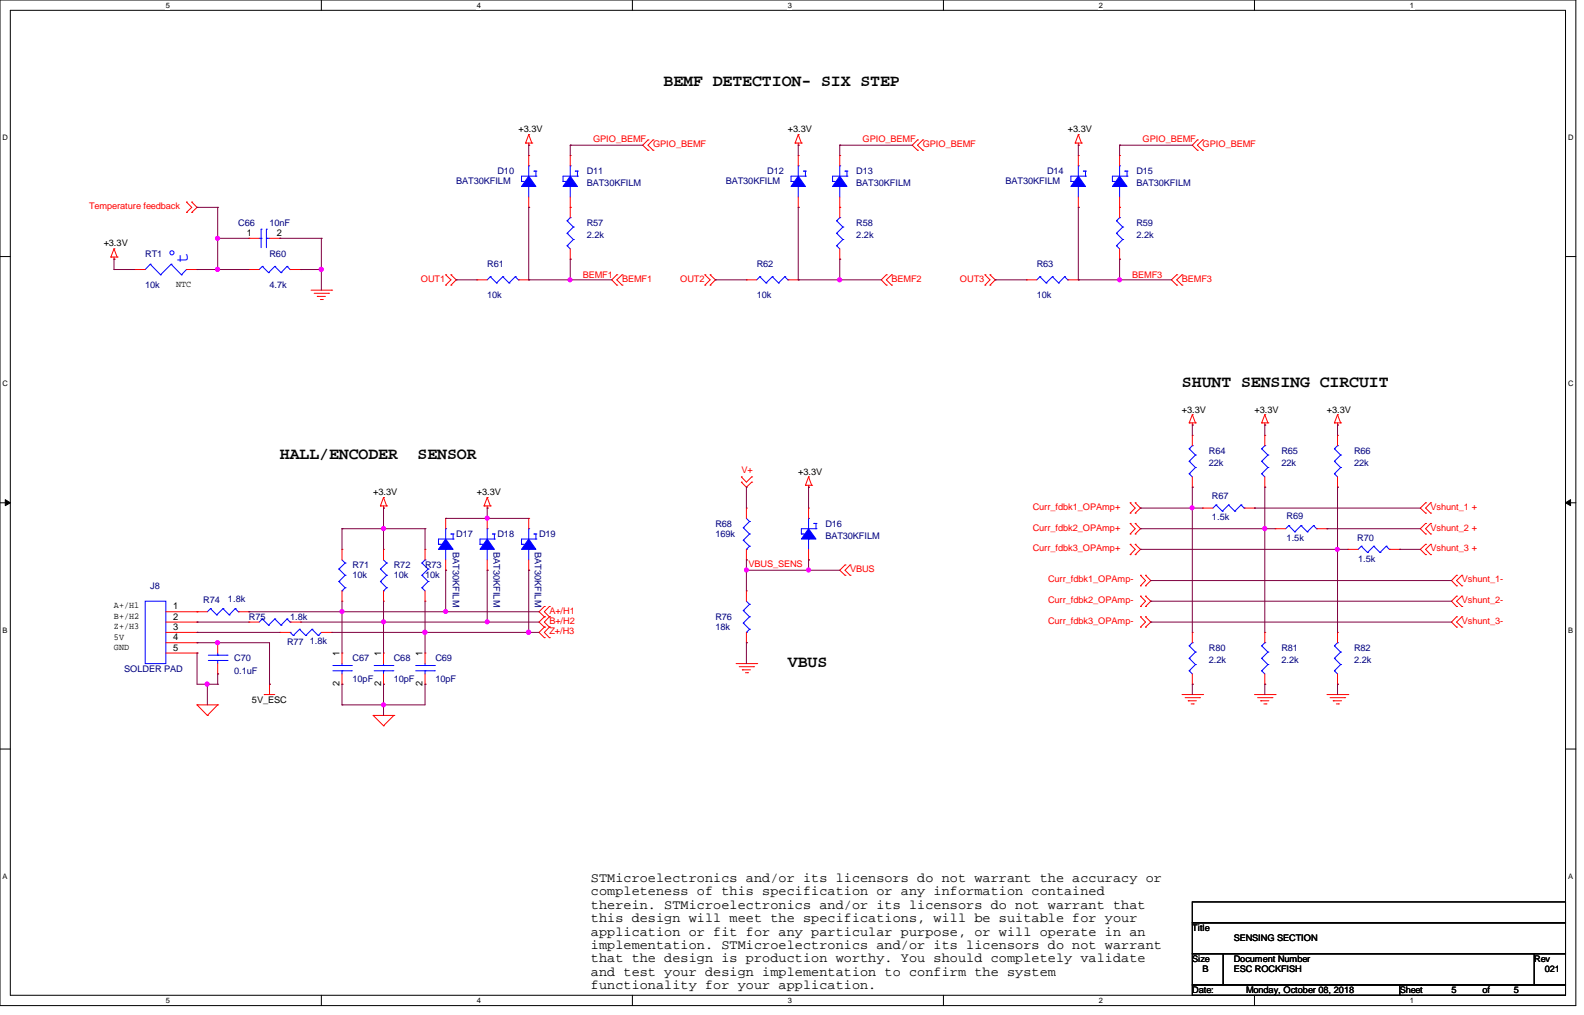
[picture p58: page 5]
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
