Ahmeddiab1/TRI-MD_EVAL/5-RESEARCH/1-EVM/LT3992_DESIGN.asc

C1: cap; 10µ
C2: cap; .47µ
C3: cap; 100µ
C4: cap; 680p
C5: cap; 22p
C6: cap; 1n
C7: cap; 33p
C8: cap; .47µ
C9: cap; 100µ
C10: cap; 680p
C11: cap; 22p
C12: cap; 1n
C13: cap; 33p
D1: schottky; MBRS340
D2: schottky; PMEG4005AEA
D3: schottky; MBRS340
D4: schottky; PMEG4005AEA
L1: ind; 10µ
L2: ind; 22µ
R1: RES; 15.5
R2: res; 4.04
R3: res; 100K
R4: res; 30.0K
R5: res; 7.32K
R6: res; 20.0K
R7: res; 100K
R8: res; 100K
R9: RES; 42.2K
R10: res; 8.06K
R11: res; 100K
R12: res; 30.0K
R13: res; 1K
R14: res; 1K
Rload1: res; 1.65
Rload2: res; 2.5
U2: LT3992
V1: VOLTAGE; 24
Named nets: 0, OUT2, IN, OUT1
Note:
  If the simulation model is not found please update with the "Sync Release" command from the "Tools" menu.
  It remains the customer's responsibility to verify proper and reliable operation in the actual application.
  Component substitution and printed circuit board layout may significantly affect circuit performance or reliability.
  Contact your local sales representative for assistance. This circuit is distributed to customers only for use with LTC parts.
  Copyright © 2012 Linear Technology Inc. All rights reserved.
.tran 500u startup
LT3992 - Monolithic Dual Tracking 3A Step-Down Switching Regulator
FMEA Fault Tolerant 5V/2A and 3.3V/2A Dual Converter
Input: 7V to 60V       Outputs: 5V @ 2A & 3.3V @ 2A
