Ahmeddiab1/TRI-MD_EVAL/(list of files, drawings)

Other design files:
1-HARDWARE/1-MD_EVAL/1-SCHEMATIC/0-TITLE.SchDoc
1-HARDWARE/1-MD_EVAL/1-SCHEMATIC/1-MAIN.SchDoc
1-HARDWARE/1-MD_EVAL/1-SCHEMATIC/2-BUCK_3V3_MCU.SchDoc
1-HARDWARE/1-MD_EVAL/1-SCHEMATIC/3-MCU.SchDoc
1-HARDWARE/1-MD_EVAL/1-SCHEMATIC/4-JTAG.SchDoc
1-HARDWARE/1-MD_EVAL/1-SCHEMATIC/5-CAN_TRANSCEIVER.SchDoc
1-HARDWARE/1-MD_EVAL/1-SCHEMATIC/6-INTERCONNECT_MAP.SchDoc
1-HARDWARE/1-MD_EVAL/1-SCHEMATIC/7-PWM_INTERLOCK.SchDoc
1-HARDWARE/1-MD_EVAL/1-SCHEMATIC/8-DRV_LDO_6V.SchDoc
1-HARDWARE/1-MD_EVAL/1-SCHEMATIC/9-SIGNAL_CONDITIONING.SchDoc
1-HARDWARE/1-MD_EVAL/1-SCHEMATIC/10-BUS_SENS.SchDoc
1-HARDWARE/1-MD_EVAL/1-SCHEMATIC/11-HALF_BRIDGE.SchDoc
1-HARDWARE/1-MD_EVAL/1-SCHEMATIC/12-TEMPERATURE.SchDoc
1-HARDWARE/1-MD_EVAL/1-SCHEMATIC/13-MECHANICALS.SchDoc
1-HARDWARE/1-MD_EVAL/2-PCB/MD_EVAL_BRD.PcbDoc
1-HARDWARE/1-MD_EVAL/MOTOR_DRIVE_EVAL.PrjPCB
