Ahmeddiab1/TRI-MD_EVAL/5-RESEARCH/3-SNIPPET/ESC_CTRL/hw/kicad/MotCtrl.kicad_pcb

## KiCad design 5-RESEARCH/3-SNIPPET/ESC_CTRL/hw/kicad/MotCtrl.kicad_pcb (2020-10-05)

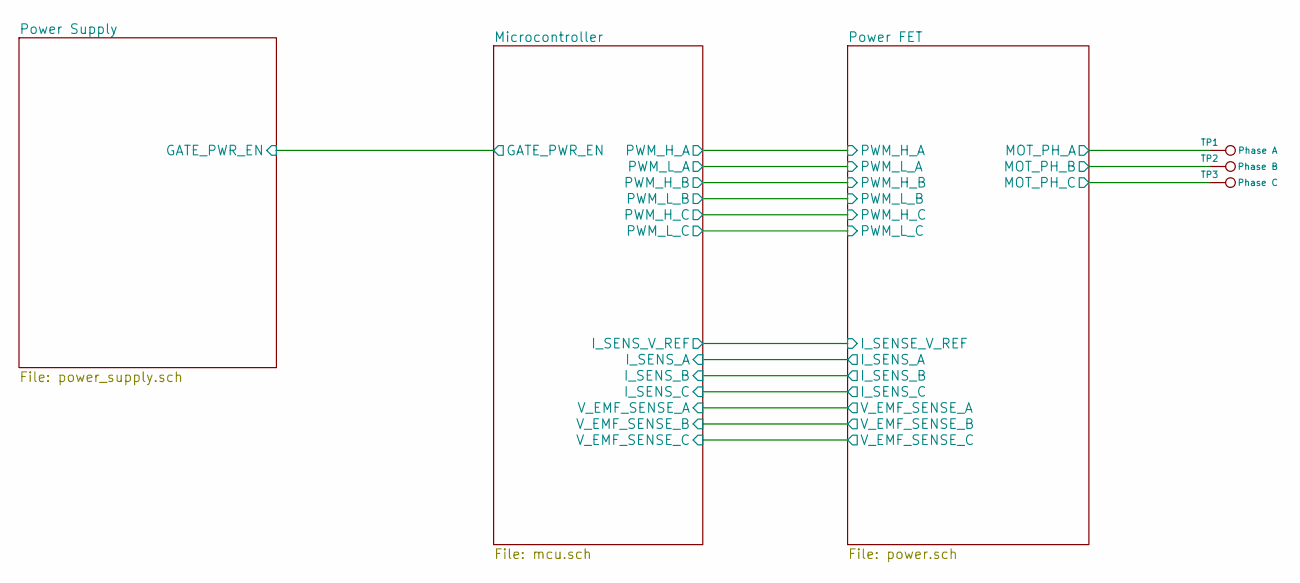
[picture p59: schematic MotCtrl.sch]

Parts:
TP1: Phase A; SolderWirePad_single_SMD_5x5mm
TP2: Phase B; SolderWirePad_single_SMD_5x5mm
TP3: Phase C; SolderWirePad_single_SMD_5x5mm

Connections:
/Power FET/MOT_PH_A: TP1.1; also elsewhere on the board
/Power FET/MOT_PH_B: TP2.1; also elsewhere on the board
/Power FET/MOT_PH_C: TP3.1; also elsewhere on the board

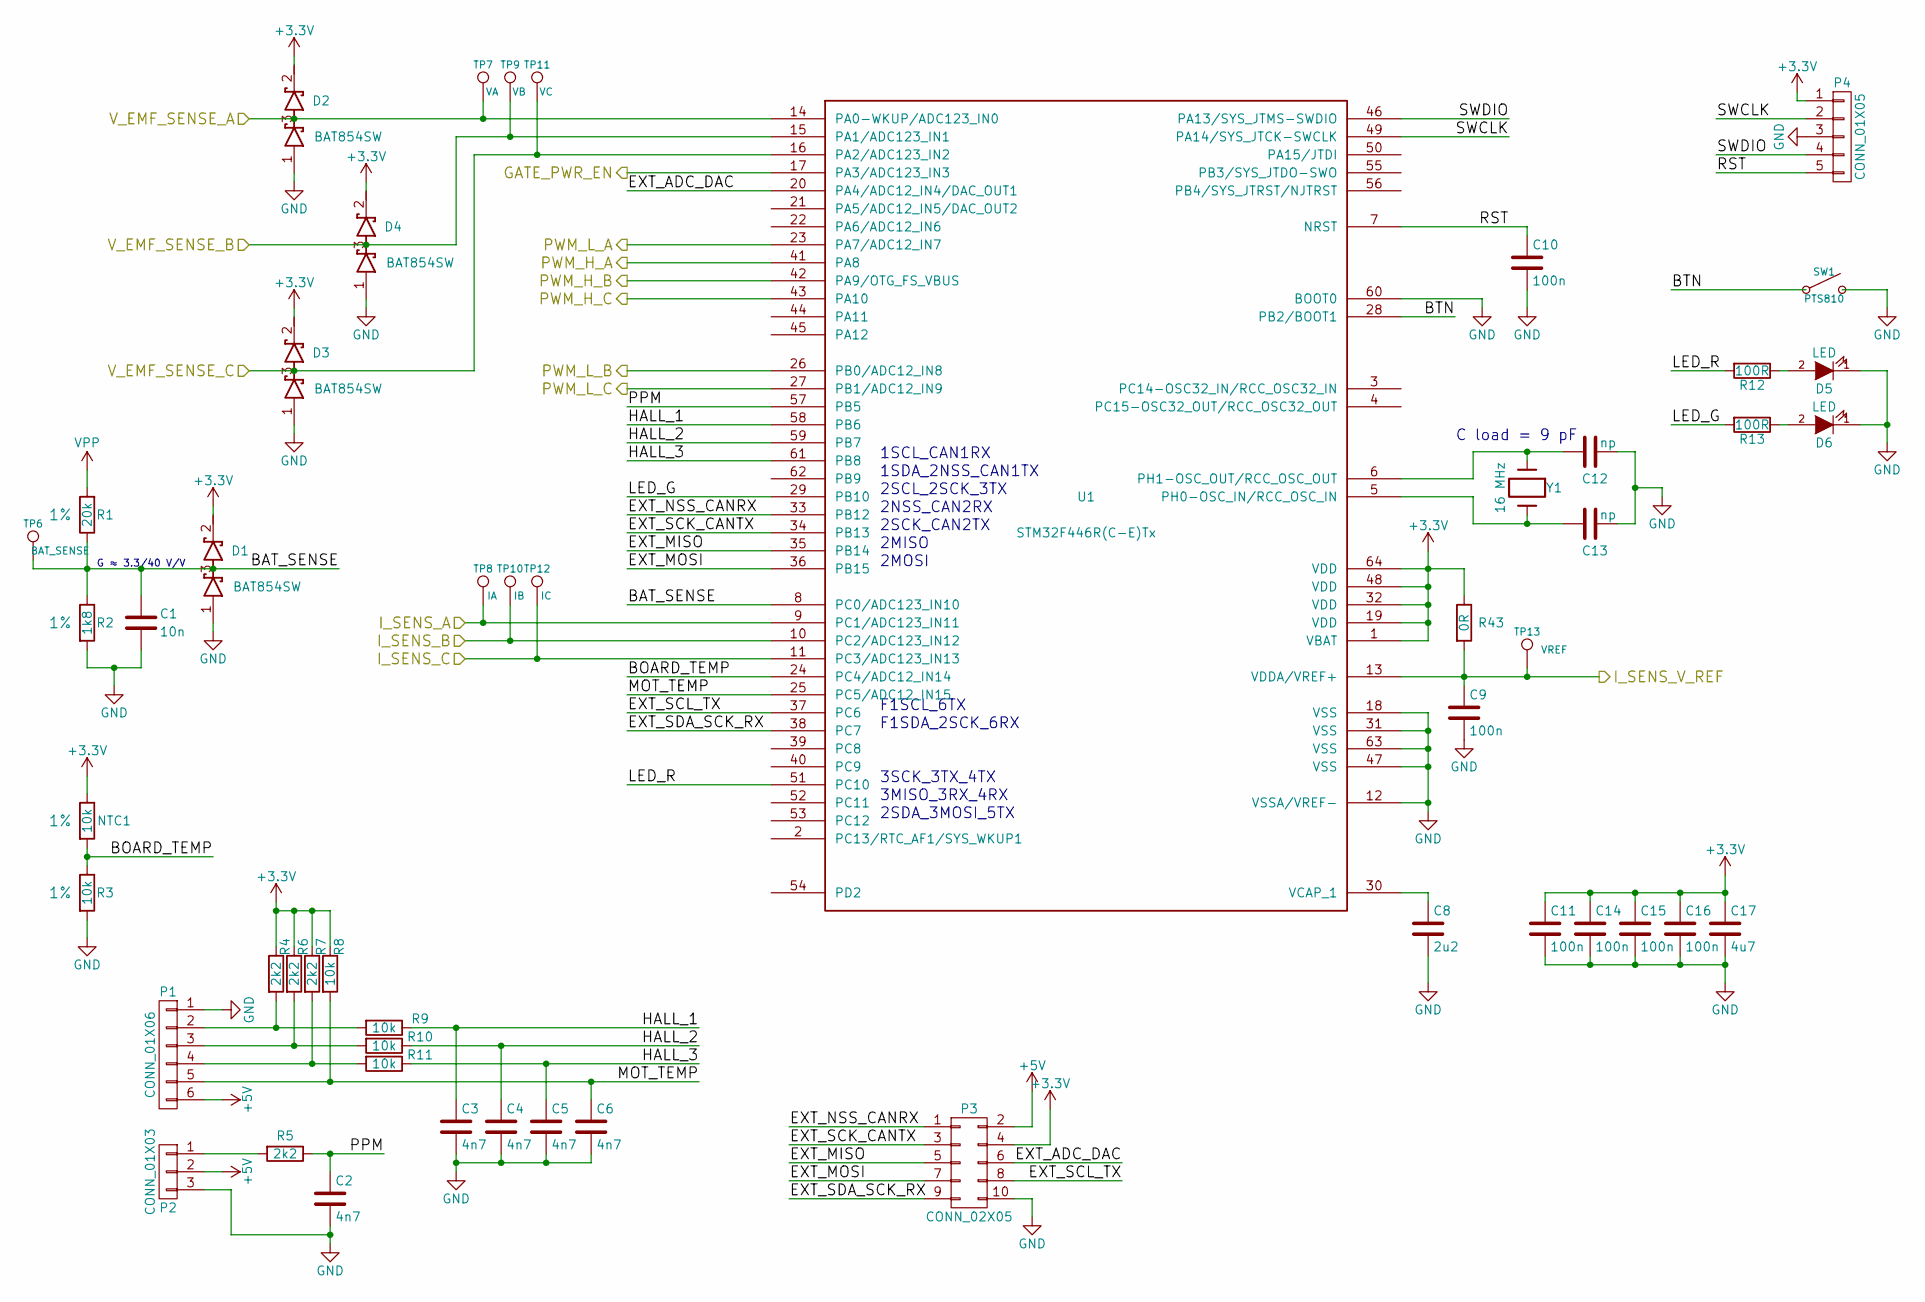
[picture p60: schematic mcu.sch]

Parts:
C1: 10n; C_0402
C2, C3, C4, C5, C6: 4n7; C_0402
C8: 2u2; C_0402
C9, C10, C11, C14, C15, C16: 100n; C_0402
C12, C13: np; C_0402
C17: 4u7; C_0603
D1, D2, D3, D4: BAT854SW; SOT-323
D5, D6: LED; LED_0603
NTC1: 10k; R_0603; Tolerance 1%
P1: CONN_01X06; JST_ZH_B6B-ZR
P2: CONN_01X03; Pin_Header_Straight_1x03
P3: CONN_02X05; Pin_Header_Straight_2x05
P4: CONN_01X05; Pin_Header_Straight_1x05
R1: 20k; R_0402; Tolerance 1%
R2: 1k8; R_0402; Tolerance 1%
R3: 10k; R_0402; Tolerance 1%
R4, R5, R6, R7: 2k2; R_0402
R8, R9, R10, R11: 10k; R_0402
R12, R13: 100R; R_0402
R43: 0R; R_0402
SW1: PTS810
TP6: BAT_SENSE; Measurement_Point_Round-SMD-Pad_Small
TP7: VA; Measurement_Point_Round-SMD-Pad_Small
TP8: IA; Measurement_Point_Round-SMD-Pad_Small
TP9: VB; Measurement_Point_Round-SMD-Pad_Small
TP10: IB; Measurement_Point_Round-SMD-Pad_Small
TP11: VC; Measurement_Point_Round-SMD-Pad_Small
TP12: IC; Measurement_Point_Round-SMD-Pad_Small
TP13: VREF; Measurement_Point_Round-SMD-Pad_Small
U1: STM32F446R(C-E)Tx; LQFP-64_10x10mm_Pitch0.5mm
Y1: 16 MHz; crystal_FA238-TSX3225

Connections:
+3V3: C11.1, C14.1, C15.1, C16.1, C17.1, D1.2 (K), D2.2 (K), D3.2 (K), D4.2 (K), NTC1.1, P3.4, P4.1, R4.1, R6.1, R7.1, R8.1, R43.1, U1.1 (VBAT), U1.19 (VDD), U1.32 (VDD), U1.48 (VDD), U1.64 (VDD); also elsewhere on the board
+5V: P1.6, P2.2, P3.2; also elsewhere on the board
/Microcontroller/BAT_SENSE: C1.1, D1.3 (common), R1.1, R2.1, TP6.1, U1.8 (PC0/ADC123_IN10)
/Microcontroller/BOARD_TEMP: NTC1.2, R3.1, U1.24 (PC4/ADC12_IN14)
/Microcontroller/BTN: SW1.1, SW1.2, U1.28 (PB2/BOOT1)
/Microcontroller/EXT_ADC_DAC: P3.6, U1.20 (PA4/ADC12_IN4/DAC_OUT1)
/Microcontroller/EXT_MISO: P3.5, U1.35 (PB14)
/Microcontroller/EXT_MOSI: P3.7, U1.36 (PB15)
/Microcontroller/EXT_NSS_CANRX: P3.1, U1.33 (PB12)
/Microcontroller/EXT_SCK_CANTX: P3.3, U1.34 (PB13)
/Microcontroller/EXT_SCL_TX: P3.8, U1.37 (PC6)
/Microcontroller/EXT_SDA_SCK_RX: P3.9, U1.38 (PC7)
/Microcontroller/GATE_PWR_EN: U1.17 (PA3/ADC123_IN3); also elsewhere on the board
/Microcontroller/HALL_1: C3.1, R9.1, U1.58 (PB6)
/Microcontroller/HALL_2: C4.1, R10.1, U1.59 (PB7)
/Microcontroller/HALL_3: C5.1, R11.1, U1.61 (PB8)
/Microcontroller/I_SENS_A: TP8.1, U1.9 (PC1/ADC123_IN11); also elsewhere on the board
/Microcontroller/I_SENS_B: TP10.1, U1.10 (PC2/ADC123_IN12); also elsewhere on the board
/Microcontroller/I_SENS_C: TP12.1, U1.11 (PC3/ADC123_IN13); also elsewhere on the board
/Microcontroller/LED_G: R13.2, U1.29 (PB10)
/Microcontroller/LED_R: R12.2, U1.51 (PC10)
/Microcontroller/MOT_TEMP: C6.1, P1.5, R8.2, U1.25 (PC5/ADC12_IN15)
/Microcontroller/PPM: C2.1, R5.1, U1.57 (PB5)
/Microcontroller/PWM_H_A: U1.41 (PA8); also elsewhere on the board
/Microcontroller/PWM_H_B: U1.42 (PA9/OTG_FS_VBUS); also elsewhere on the board
/Microcontroller/PWM_H_C: U1.43 (PA10); also elsewhere on the board
/Microcontroller/PWM_L_A: U1.23 (PA7/ADC12_IN7); also elsewhere on the board
/Microcontroller/PWM_L_B: U1.26 (PB0/ADC12_IN8); also elsewhere on the board
/Microcontroller/PWM_L_C: U1.27 (PB1/ADC12_IN9); also elsewhere on the board
/Microcontroller/RST: C10.1, P4.5, U1.7 (NRST)
/Microcontroller/SWCLK: P4.2, U1.49 (PA14/SYS_JTCK-SWCLK)
/Microcontroller/SWDIO: P4.4, U1.46 (PA13/SYS_JTMS-SWDIO)
/Microcontroller/V_EMF_SENSE_A: D2.3 (common), TP7.1, U1.14 (PA0-WKUP/ADC123_IN0); also elsewhere on the board
/Microcontroller/V_EMF_SENSE_B: D4.3 (common), TP9.1, U1.15 (PA1/ADC123_IN1); also elsewhere on the board
/Microcontroller/V_EMF_SENSE_C: D3.3 (common), TP11.1, U1.16 (PA2/ADC123_IN2); also elsewhere on the board
/Power FET/I_SENSE_V_REF: C9.1, R43.2, TP13.1, U1.13 (VDDA/VREF+); also elsewhere on the board
GND: C1.2, C2.2, C3.2, C4.2, C5.2, C6.2, C8.2, C9.2, C10.2, C11.2, C12.1, C13.1, C14.2, C15.2, C16.2, C17.2, D1.1 (A), D2.1 (A), D3.1 (A), D4.1 (A), D5.1 (K), D6.1 (K), P1.1, P2.3, P3.10, P4.3, R2.2, R3.2, SW1.3, SW1.4, U1.12 (VSSA/VREF-), U1.18 (VSS), U1.31 (VSS), U1.47 (VSS), U1.60 (BOOT0), U1.63 (VSS); also elsewhere on the board
unnamed: C8.1, U1.30 (VCAP_1)
unnamed: C12.2, U1.6 (PH1-OSC_OUT/RCC_OSC_OUT), Y1.1
unnamed: C13.2, U1.5 (PH0-OSC_IN/RCC_OSC_IN), Y1.2
unnamed: D5.2 (A), R12.1
unnamed: D6.2 (A), R13.1
unnamed: P1.2, R4.2, R9.2
unnamed: P1.3, R6.2, R10.2
unnamed: P1.4, R7.2, R11.2
unnamed: P2.1, R5.2
VPP: R1.2; also elsewhere on the board

Notes on the sheet:
C load = 9 pF
G ≈ 3.3/40 V/V
1SCL_CAN1RX
1SDA_2NSS_CAN1TX
2SCL_2SCK_3TX
2NSS_CAN2RX
2SCK_CAN2TX
2MISO
2MOSI
F1SCL_6TX
F1SDA_2SCK_6RX
3SCK_3TX_4TX
3MISO_3RX_4RX
2SDA_3MOSI_5TX

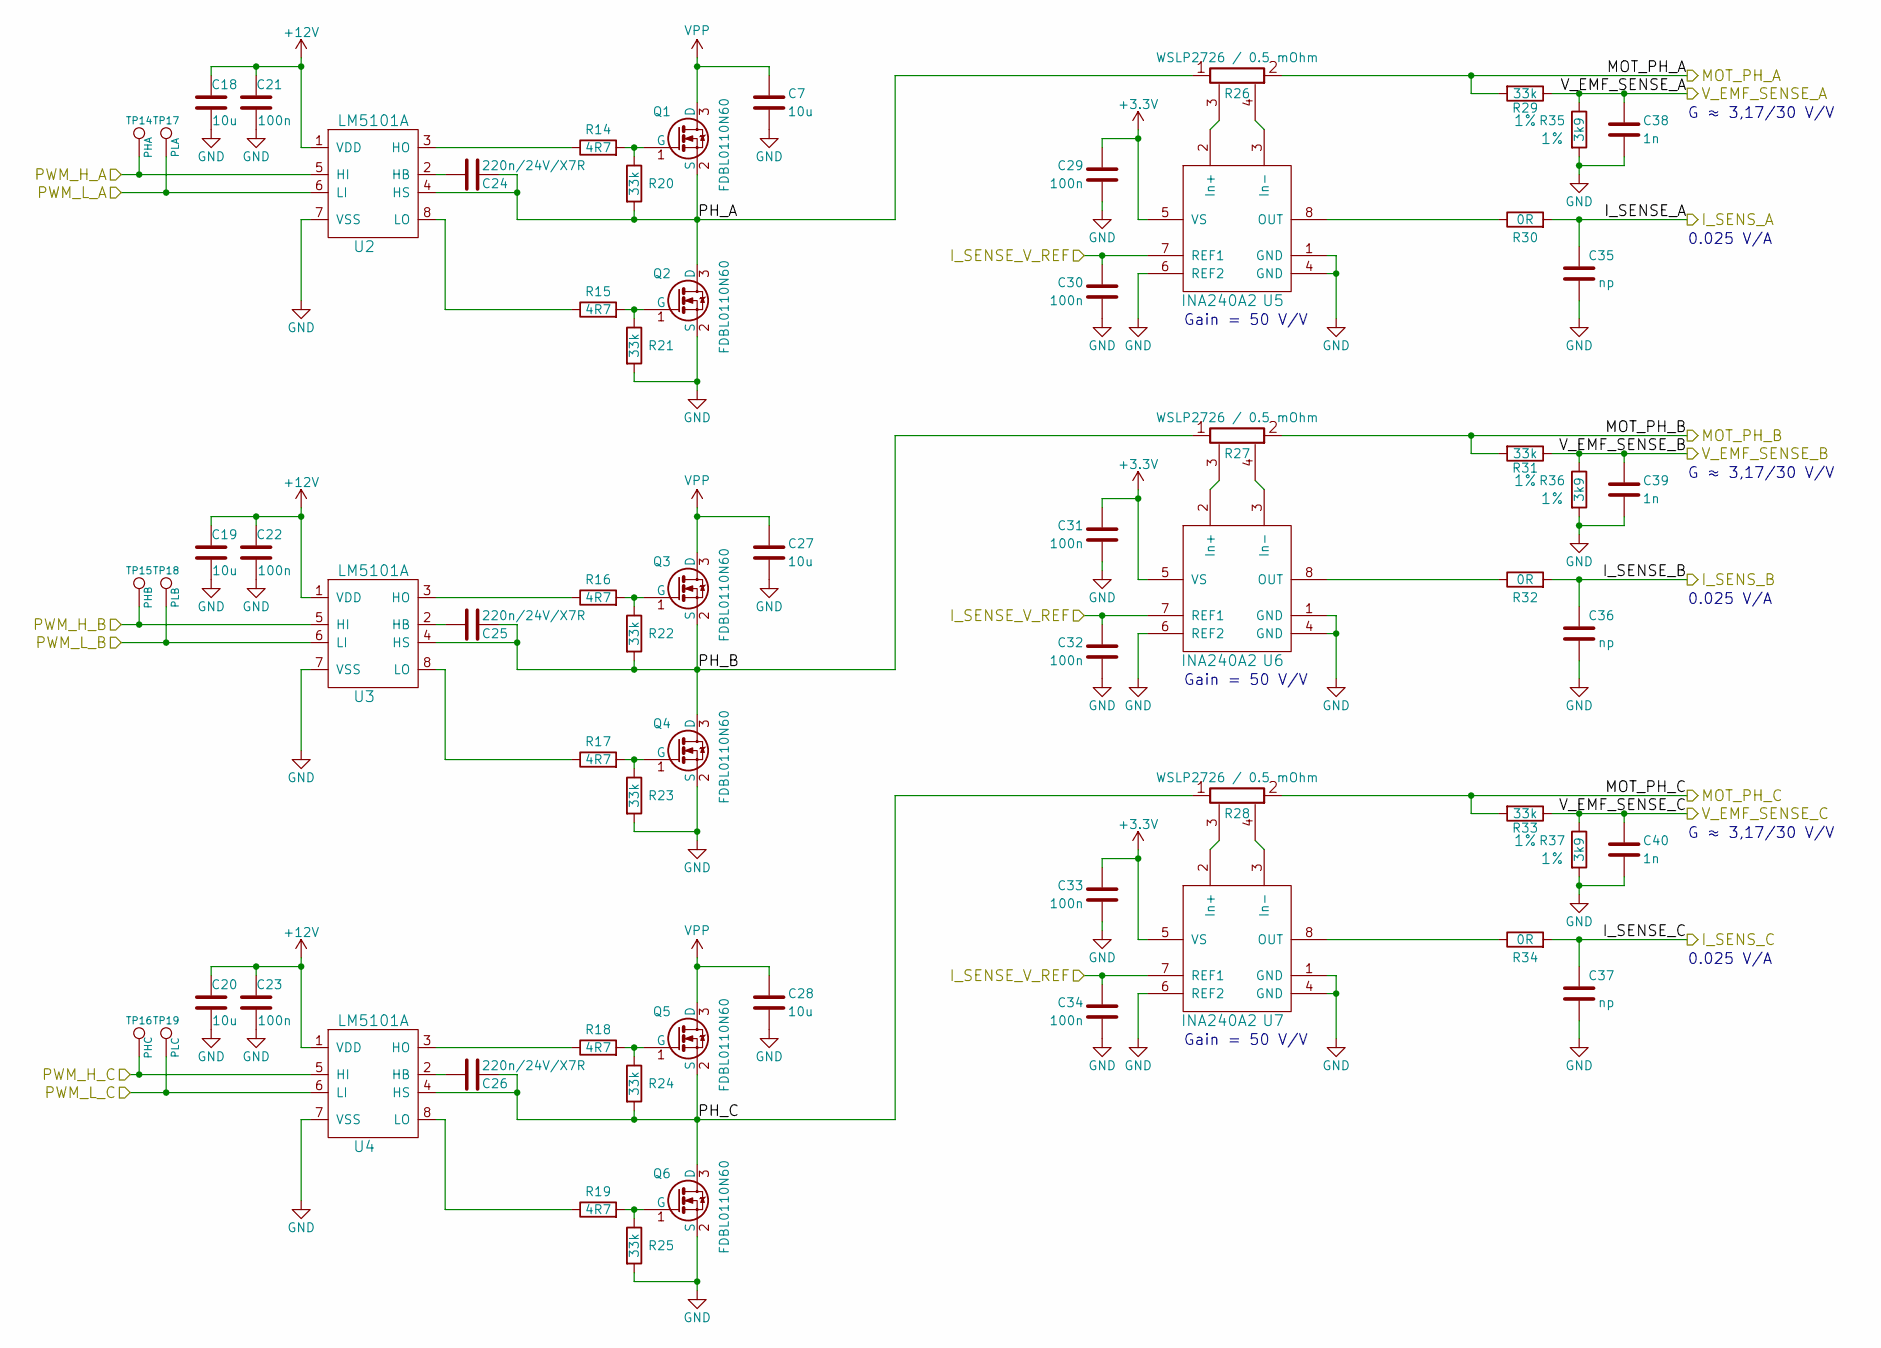
[picture p61: schematic power.sch]

Parts:
C7, C27, C28: 10u; C_1210
C18, C19, C20: 10u; C_0805
C21, C22, C23, C29, C30, C31, C32, C33, C34: 100n; C_0402
C24, C25, C26: 220n/24V/X7R; C_0603
C35, C36, C37: np; C_0402
C38, C39, C40: 1n; C_0402
Q1, Q2, Q3, Q4, Q5, Q6: FDBL0110N60; MO-299A
R14, R15, R16, R17, R18, R19: 4R7; R_0402
R20, R21, R22, R23, R24, R25: 33k; R_0402
R26, R27, R28: WSLP2726 / 0.5 mOhm; WSLP2726
R29, R31, R33: 33k; R_0402; Tolerance 1%
R30, R32, R34: 0R; R_0402
R35, R36, R37: 3k9; R_0402; Tolerance 1%
TP14: PHA; Measurement_Point_Round-SMD-Pad_Small
TP15: PHB; Measurement_Point_Round-SMD-Pad_Small
TP16: PHC; Measurement_Point_Round-SMD-Pad_Small
TP17: PLA; Measurement_Point_Round-SMD-Pad_Small
TP18: PLB; Measurement_Point_Round-SMD-Pad_Small
TP19: PLC; Measurement_Point_Round-SMD-Pad_Small
U2, U3, U4: LM5101A; WSON-8
U5, U6, U7: INA240A2; TSSOP-8_4.4x3mm_Pitch0.65mm

Connections:
+3V3: C29.2, C31.2, C33.2, U5.5 (VS), U6.5 (VS), U7.5 (VS); also elsewhere on the board
+12V: C18.2, C19.2, C20.2, C21.2, C22.2, C23.2, U2.1 (VDD), U3.1 (VDD), U4.1 (VDD); also elsewhere on the board
/Microcontroller/I_SENS_A: C35.2, R30.2; also elsewhere on the board
/Microcontroller/I_SENS_B: C36.2, R32.2; also elsewhere on the board
/Microcontroller/I_SENS_C: C37.2, R34.2; also elsewhere on the board
/Microcontroller/PWM_H_A: TP14.1, U2.5 (HI); also elsewhere on the board
/Microcontroller/PWM_H_B: TP15.1, U3.5 (HI); also elsewhere on the board
/Microcontroller/PWM_H_C: TP16.1, U4.5 (HI); also elsewhere on the board
/Microcontroller/PWM_L_A: TP17.1, U2.6 (LI); also elsewhere on the board
/Microcontroller/PWM_L_B: TP18.1, U3.6 (LI); also elsewhere on the board
/Microcontroller/PWM_L_C: TP19.1, U4.6 (LI); also elsewhere on the board
/Microcontroller/V_EMF_SENSE_A: C38.1, R29.1, R35.1; also elsewhere on the board
/Microcontroller/V_EMF_SENSE_B: C39.1, R31.1, R36.1; also elsewhere on the board
/Microcontroller/V_EMF_SENSE_C: C40.1, R33.1, R37.1; also elsewhere on the board
/Power FET/I_SENSE_V_REF: C30.2, C32.2, C34.2, U5.7 (REF1), U6.7 (REF1), U7.7 (REF1); also elsewhere on the board
/Power FET/MOT_PH_A: R26.2, R29.2; also elsewhere on the board
/Power FET/MOT_PH_B: R27.2, R31.2; also elsewhere on the board
/Power FET/MOT_PH_C: R28.2, R33.2; also elsewhere on the board
/Power FET/PH_A: C24.1, Q1.2 (S), Q2.3 (D), R20.2, R26.1, U2.4 (HS)
/Power FET/PH_B: C25.1, Q3.2 (S), Q4.3 (D), R22.2, R27.1, U3.4 (HS)
/Power FET/PH_C: C26.1, Q5.2 (S), Q6.3 (D), R24.2, R28.1, U4.4 (HS)
GND: C7.2, C18.1, C19.1, C20.1, C21.1, C22.1, C23.1, C27.2, C28.2, C29.1, C30.1, C31.1, C32.1, C33.1, C34.1, C35.1, C36.1, C37.1, C38.2, C39.2, C40.2, Q2.2 (S), Q4.2 (S), Q6.2 (S), R21.2, R23.2, R25.2, R35.2, R36.2, R37.2, U2.7 (VSS), U3.7 (VSS), U4.7 (VSS), U5.1 (GND), U5.4 (GND), U5.6 (REF2), U6.1 (GND), U6.4 (GND), U6.6 (REF2), U7.1 (GND), U7.4 (GND), U7.6 (REF2); also elsewhere on the board
unnamed: C24.2, U2.2 (HB)
unnamed: C25.2, U3.2 (HB)
unnamed: C26.2, U4.2 (HB)
unnamed: Q1.1 (G), R14.2, R20.1
unnamed: Q2.1 (G), R15.2, R21.1
unnamed: Q3.1 (G), R16.2, R22.1
unnamed: Q4.1 (G), R17.2, R23.1
unnamed: Q5.1 (G), R18.2, R24.1
unnamed: Q6.1 (G), R19.2, R25.1
unnamed: R14.1, U2.3 (HO)
unnamed: R15.1, U2.8 (LO)
unnamed: R16.1, U3.3 (HO)
unnamed: R17.1, U3.8 (LO)
unnamed: R18.1, U4.3 (HO)
unnamed: R19.1, U4.8 (LO)
unnamed: R26.3, U5.2 (In+)
unnamed: R26.4, U5.3 (In-)
unnamed: R27.3, U6.2 (In+)
unnamed: R27.4, U6.3 (In-)
unnamed: R28.3, U7.2 (In+)
unnamed: R28.4, U7.3 (In-)
unnamed: R30.1, U5.8 (OUT)
unnamed: R32.1, U6.8 (OUT)
unnamed: R34.1, U7.8 (OUT)
VPP: C7.1, C27.1, C28.1, Q1.3 (D), Q3.3 (D), Q5.3 (D); also elsewhere on the board

Notes on the sheet:
Gain = 50 V/V
0.025 V/A
G ≈ 3,17/30 V/V

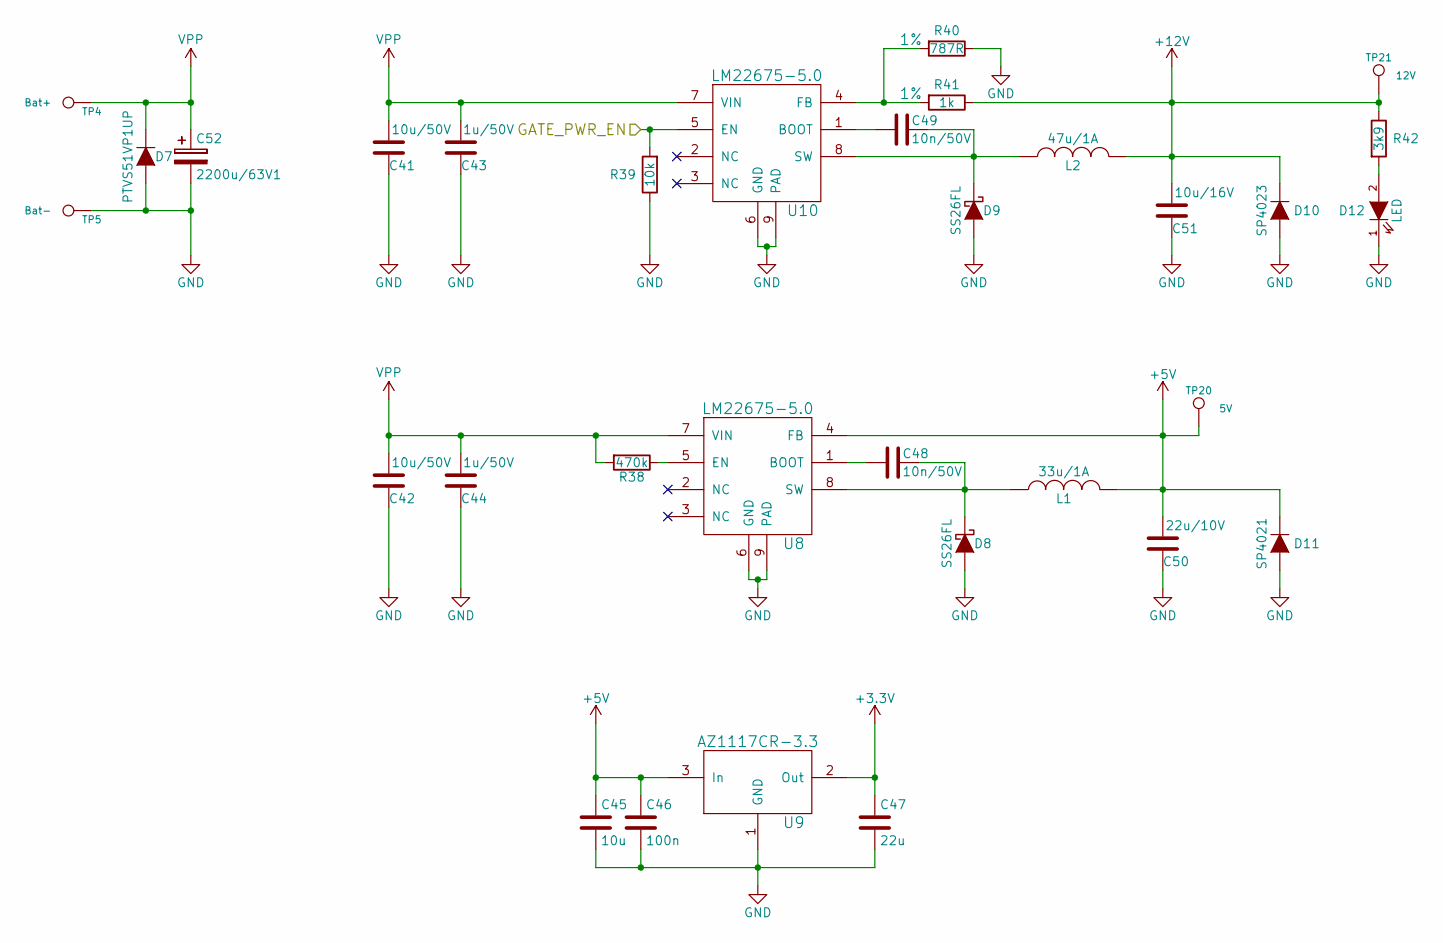
[picture p62: schematic power_supply.sch]

Parts:
C41, C42: 10u/50V; C_1210
C43, C44: 1u/50V; C_0805
C45: 10u; C_0805
C46: 100n; C_0402
C47: 22u; C_0805
C48, C49: 10n/50V; C_0402
C50: 22u/10V; C_0805
C51: 10u/16V; C_0805
C52: 2200u/63V1; C_Radial_D18_L37_P7.5_Angled
D7: PTVS51VP1UP; SOD-128
D8, D9: SS26FL; SOD-123
D10: SP4023; SOD-323
D11: SP4021; SOD-323
D12: LED; LED_0603
L1: 33u/1A; SRN8040TA
L2: 47u/1A; SRN8040TA
R38: 470k; R_0402
R39: 10k; R_0402
R40: 787R; R_0402; Tolerance 1%
R41: 1k; R_0402; Tolerance 1%
R42: 3k9; R_0402
TP4: Bat+; SolderWirePad_single_SMD_5x5mm
TP5: Bat-; SolderWirePad_single_SMD_5x5mm
TP20: 5V; Measurement_Point_Round-SMD-Pad_Small
TP21: 12V; Measurement_Point_Round-SMD-Pad_Small
U8, U10: LM22675-5.0; HSOP-8
U9: AZ1117CR-3.3; SOT89-3_Housing

Connections:
+3V3: C47.1, U9.2 (Out); also elsewhere on the board
+5V: C45.1, C46.1, C50.2, D11.1 (K), L1.2, TP20.1, U8.4 (FB), U9.3 (In); also elsewhere on the board
+12V: C51.2, D10.1 (K), L2.2, R41.1, R42.1, TP21.1; also elsewhere on the board
/Microcontroller/GATE_PWR_EN: R39.2, U10.5 (EN); also elsewhere on the board
GND: C41.1, C42.1, C43.1, C44.1, C45.2, C46.2, C47.2, C50.1, C51.1, C52.2, D7.2 (A), D8.2 (A), D9.2 (A), D10.2 (A), D11.2 (A), D12.1 (K), R39.1, R40.1, TP5.1, U8.6 (GND), U8.9 (PAD), U9.1 (GND), U10.6 (GND), U10.9 (PAD); also elsewhere on the board
unnamed: C48.1, D8.1 (K), L1.1, U8.8 (SW)
unnamed: C48.2, U8.1 (BOOT)
unnamed: C49.1, D9.1 (K), L2.1, U10.8 (SW)
unnamed: C49.2, U10.1 (BOOT)
unnamed: D12.2 (A), R42.2
unnamed: R38.1, U8.5 (EN)
unnamed: R40.2, R41.2, U10.4 (FB)
VPP: C41.2, C42.2, C43.2, C44.2, C52.1, D7.1 (K), R38.2, TP4.1, U8.7 (VIN), U10.7 (VIN); also elsewhere on the board

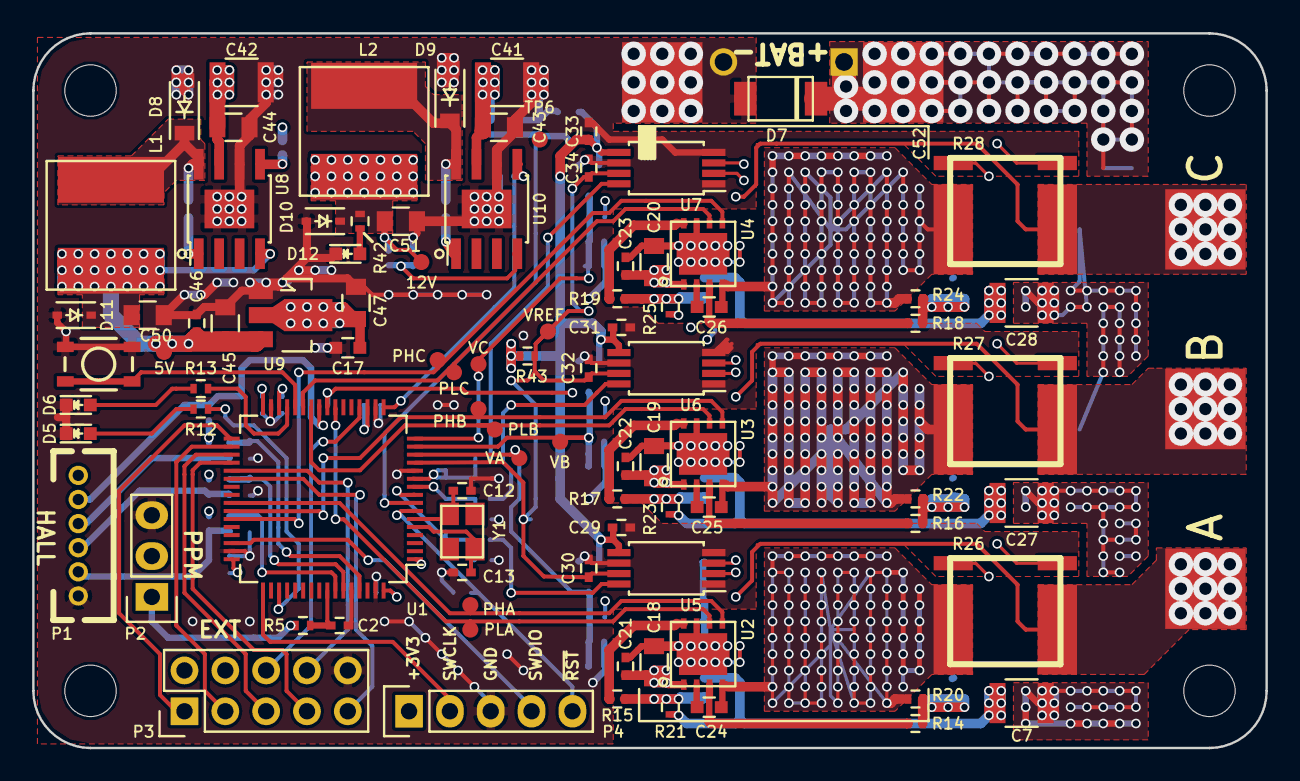
[picture p63: board MotCtrl.kicad_pcb from above]

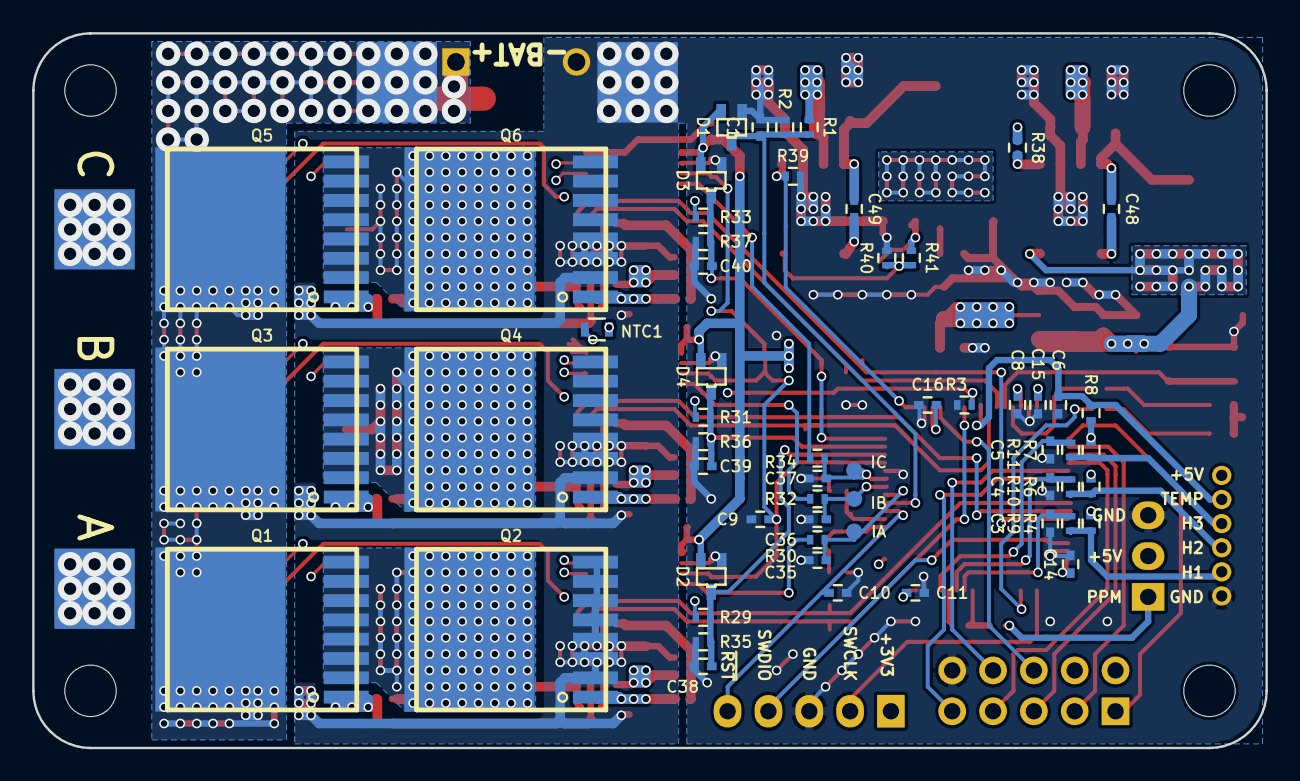
[picture p64: board MotCtrl.kicad_pcb from below]

Board: 4 copper layers, 76.7 x 44.5 mm, 158 parts (62 on the bottom side), 85 nets.

Other parts of the board:
TP1#2: Phase A; SolderWirePad_single_SMD_5x5mm
TP2#2: Phase B; SolderWirePad_single_SMD_5x5mm
TP3#2: Phase C; SolderWirePad_single_SMD_5x5mm
TP4#2: Bat+; SolderWirePad_single_SMD_5x5mm
TP5#2: Bat-; SolderWirePad_single_SMD_5x5mm

Their connections:
/Power FET/MOT_PH_A: TP1#2.1; also elsewhere on the board
/Power FET/MOT_PH_B: TP2#2.1; also elsewhere on the board
/Power FET/MOT_PH_C: TP3#2.1; also elsewhere on the board
GND: TP5#2.1; also elsewhere on the board
VPP: TP4#2.1; also elsewhere on the board
