Ahmeddiab1/TRI-MD_EVAL/1-HARDWARE/1-MD_EVAL/6-CUBEMX/ESC_STM_MOTOR-CTRL/Inc/drive_parameters.h

#define __DRIVE_PARAMETERS_H
#define MAX_APPLICATION_SPEED_RPM       4000
#define MIN_APPLICATION_SPEED_RPM       0
#define MEAS_ERRORS_BEFORE_FAULTS       3
#define HALL_MEAS_ERRORS_BEFORE_FAULTS  3
#define HALL_AVERAGING_FIFO_DEPTH        6
#define HALL_MTPA  false
#define CORD_VARIANCE_THRESHOLD           4
#define CORD_F1                          16384
#define CORD_F2                          1024
#define CORD_F1_LOG                      LOG2(16384)
#define CORD_F2_LOG                      LOG2(1024)
#define CORD_GAIN1                       -24129
#define CORD_GAIN2                       21049
#define CORD_MEAS_ERRORS_BEFORE_FAULTS   3
#define CORD_FIFO_DEPTH_DPP              64
#define CORD_FIFO_DEPTH_DPP_LOG          LOG2(64)
#define CORD_FIFO_DEPTH_UNIT            64
#define CORD_MAX_ACCEL_DPPP              30
#define CORD_BEMF_CONSISTENCY_TOL        64
#define CORD_BEMF_CONSISTENCY_GAIN       64
#define PARK_ANGLE_COMPENSATION_FACTOR 0
#define REV_PARK_ANGLE_COMPENSATION_FACTOR 0
#define PWM_FREQUENCY   16000
#define PWM_FREQ_SCALING 1
#define LOW_SIDE_SIGNALS_ENABLING        LS_PWM_TIMER
#define SW_DEADTIME_NS                   800
#define REGULATION_EXECUTION_RATE     1
#define PID_TORQUE_KP_DEFAULT         3081
#define PID_TORQUE_KI_DEFAULT         3594
#define PID_TORQUE_KD_DEFAULT         100
#define PID_FLUX_KP_DEFAULT           3081
#define PID_FLUX_KI_DEFAULT           3594
#define PID_FLUX_KD_DEFAULT           100
#define TF_KPDIV                      256
#define TF_KIDIV                      8192
#define TF_KDDIV                      8192
#define TF_KPDIV_LOG                  LOG2(256)
#define TF_KIDIV_LOG                  LOG2(8192)
#define TF_KDDIV_LOG                  LOG2(8192)
#define TFDIFFERENTIAL_TERM_ENABLING  DISABLE
#define SPEED_LOOP_FREQUENCY_HZ       1000
#define PID_SPEED_KP_DEFAULT          1000/(SPEED_UNIT/10)
#define PID_SPEED_KI_DEFAULT          700/(SPEED_UNIT/10)
#define PID_SPEED_KD_DEFAULT          0/(SPEED_UNIT/10)
#define SP_KPDIV                      16
#define SP_KIDIV                      256
#define SP_KDDIV                      16
#define SP_KPDIV_LOG                  LOG2(16)
#define SP_KIDIV_LOG                  LOG2(256)
#define SP_KDDIV_LOG                  LOG2(16)
#define PID_SPEED_INTEGRAL_INIT_DIV 1
#define SPD_DIFFERENTIAL_TERM_ENABLING DISABLE
#define IQMAX                          980
#define DEFAULT_CONTROL_MODE           STC_SPEED_MODE
#define DEFAULT_TARGET_SPEED_RPM      1500
#define DEFAULT_TARGET_SPEED_UNIT      (DEFAULT_TARGET_SPEED_RPM*SPEED_UNIT/_RPM)
#define DEFAULT_TORQUE_COMPONENT       0
#define DEFAULT_FLUX_COMPONENT         0
#define OV_VOLTAGE_PROT_ENABLING        ENABLE
#define UV_VOLTAGE_PROT_ENABLING        ENABLE
#define OV_VOLTAGE_THRESHOLD_V          28
#define UD_VOLTAGE_THRESHOLD_V          8
#define R_BRAKE_SWITCH_OFF_THRES_V      22
#define OV_TEMPERATURE_THRESHOLD_C      110
#define OV_TEMPERATURE_HYSTERESIS_C     10
#define HW_OV_CURRENT_PROT_BYPASS       DISABLE
#define PHASE1_DURATION                0
#define PHASE1_FINAL_SPEED_UNIT         (0*SPEED_UNIT/_RPM)
#define PHASE1_FINAL_CURRENT           0
#define PHASE2_DURATION                700
#define PHASE2_FINAL_SPEED_UNIT         (0*SPEED_UNIT/_RPM)
#define PHASE2_FINAL_CURRENT           326
#define PHASE3_DURATION                350
#define PHASE3_FINAL_SPEED_UNIT         (630*SPEED_UNIT/_RPM)
#define PHASE3_FINAL_CURRENT           381
#define PHASE4_DURATION                1150
#define PHASE4_FINAL_SPEED_UNIT         (2700*SPEED_UNIT/_RPM)
#define PHASE4_FINAL_CURRENT           381
#define PHASE5_DURATION                0
#define PHASE5_FINAL_SPEED_UNIT         (2700*SPEED_UNIT/_RPM)
#define PHASE5_FINAL_CURRENT           381
#define ENABLE_SL_ALGO_FROM_PHASE      3
#define STARTING_ANGLE_DEG             90
#define OBS_MINIMUM_SPEED_RPM          580
#define NB_CONSECUTIVE_TESTS           2
#define SPEED_BAND_UPPER_LIMIT         17
#define SPEED_BAND_LOWER_LIMIT         15
#define TRANSITION_DURATION            25
#define  M1_VBUS_SAMPLING_TIME  LL_ADC_SAMPLING_CYCLE(47)
#define  M1_TEMP_SAMPLING_TIME  LL_ADC_SAMPLING_CYCLE(47)
#define ADC_SAMPLING_CYCLES (6 + SAMPLING_CYCLE_CORRECTION)
