Ahmeddiab1/TRI-MD_EVAL/5-RESEARCH/1-EVM/ESC_G431/G431_PRJ/G431_PRJ.ioc

Mcu.UserName=STM32G431CBUx
PA0.GPIO_Label=M1_BUS_VOLTAGE
PA0.Signal=ADC1_IN1
PA1.GPIO_Label=M1_CURR_SHUNT_U
PA1.Signal=SharedAnalog_PA1
PA10.GPIO_Label=M1_PWM_WH
PA10.Signal=S_TIM1_CH3
PA11.Signal=FDCAN1_RX
PA12.GPIO_Label=M1_PWM_VL
PA12.Signal=TIM1_CH2N
PA13.GPIO_Label=TMS
PA13.Signal=SYS_JTMS-SWDIO
PA14.GPIO_Label=TCK
PA14.Signal=SYS_JTCK-SWCLK
PA15.Signal=S_TIM2_CH1
PA2.GPIO_Label=M1_OPAMP1_OUT
PA2.Signal=SharedAnalog_PA2
PA3.GPIO_Label=M1_OPAMP1_INT_GAIN
PA3.Signal=OPAMP1_VINM
PA4.GPIO_Label=DBG_DAC_CH1
PA4.Signal=SharedAnalog_PA4
PA5.GPIO_Label=M1_OPAMP2_INT_GAIN
PA5.Signal=OPAMP2_VINM
PA6.GPIO_Label=M1_OPAMP2_OUT
PA6.Signal=SharedAnalog_PA6
PA7.GPIO_Label=M1_CURR_SHUNT_V
PA7.Signal=SharedAnalog_PA7
PA8.GPIO_Label=M1_PWM_UH
PA8.Signal=S_TIM1_CH1
PA9.GPIO_Label=M1_PWM_VH
PA9.Signal=S_TIM1_CH2
PB0.GPIO_Label=M1_CURR_SHUNT_W
PB0.Signal=SharedAnalog_PB0
PB1.GPIO_Label=M1_OPAMP3_OUT
PB1.Signal=SharedAnalog_PB1
PB11.GPIO_Label=BEMF3
PB11.Signal=SharedAnalog_PB11
PB13.GPIO_Label=POTENTIO
PB13.Signal=GPIO_Analog
PB14.GPIO_Label=M1_TEMPERATURE
PB14.Signal=ADC1_IN5
PB15.GPIO_Label=M1_PWM_WL
PB15.Signal=TIM1_CH3N
PB2.GPIO_Label=M1_OPAMP3_INT_GAIN
PB2.Signal=OPAMP3_VINM
PB3.GPIO_Label=UART_TX
PB3.Signal=USART2_TX
PB4.GPIO_Label=UART_RX
PB4.Signal=USART2_RX
PB5.GPIO_Label=GPIO_BEMF
PB5.Signal=GPIO_Analog
PB6.GPIO_Label=H1
PB6.Signal=S_TIM4_CH1
PB7.GPIO_Label=H2
PB7.Signal=S_TIM4_CH2
PB8-BOOT0.GPIO_Label=H3
PB8-BOOT0.Signal=S_TIM4_CH3
PB9.Signal=FDCAN1_TX
PC10.GPIO_Label=Start/Stop [PushButton]
PC10.Signal=GPXTI10
PC11.GPIO_Label=CAN_SHDN
PC11.Signal=GPIO_Input
PC13.GPIO_Label=M1_PWM_UL
PC13.Signal=TIM1_CH1N
PC14-OSC32_IN.GPIO_Label=CAN_TERM
PC14-OSC32_IN.Signal=GPIO_Input
PC4.GPIO_Label=BEMF2
PC4.Signal=SharedAnalog_PC4
PC6.GPIO_Label=STATUS
PC6.Signal=GPIO_Output
PF0-OSC_IN.Signal=RCC_OSC_IN
PF1-OSC_OUT.Signal=RCC_OSC_OUT
PG10-NRST.GPIO_Label=NRST
PG10-NRST.Signal=GPIO_Input
