Ahmeddiab1/TRI-MD_EVAL/1-HARDWARE/1-MD_EVAL/6-CUBEMX/ESC_STM_MOTOR-CTRL/Inc/main.h

#define M1_BUS_VOLTAGE_Pin GPIO_PIN_0
#define M1_BUS_VOLTAGE_GPIO_Port GPIOA
#define M1_CURR_SHUNT_U_Pin GPIO_PIN_1
#define M1_CURR_SHUNT_U_GPIO_Port GPIOA
#define M1_OPAMP1_OUT_Pin GPIO_PIN_2
#define M1_OPAMP1_OUT_GPIO_Port GPIOA
#define M1_OPAMP1_INT_GAIN_Pin GPIO_PIN_3
#define M1_OPAMP1_INT_GAIN_GPIO_Port GPIOA
#define M1_OPAMP2_INT_GAIN_Pin GPIO_PIN_5
#define M1_OPAMP2_INT_GAIN_GPIO_Port GPIOA
#define M1_OPAMP2_OUT_Pin GPIO_PIN_6
#define M1_OPAMP2_OUT_GPIO_Port GPIOA
#define M1_CURR_SHUNT_V_Pin GPIO_PIN_7
#define M1_CURR_SHUNT_V_GPIO_Port GPIOA
#define M1_CURR_SHUNT_W_Pin GPIO_PIN_0
#define M1_CURR_SHUNT_W_GPIO_Port GPIOB
#define M1_OPAMP3_OUT_Pin GPIO_PIN_1
#define M1_OPAMP3_OUT_GPIO_Port GPIOB
#define M1_OPAMP3_INT_GAIN_Pin GPIO_PIN_2
#define M1_OPAMP3_INT_GAIN_GPIO_Port GPIOB
#define M1_PWM_UL_Pin GPIO_PIN_8
#define M1_PWM_UL_GPIO_Port GPIOE
#define M1_PWM_UH_Pin GPIO_PIN_9
#define M1_PWM_UH_GPIO_Port GPIOE
#define M1_PWM_VL_Pin GPIO_PIN_10
#define M1_PWM_VL_GPIO_Port GPIOE
#define M1_PWM_VH_Pin GPIO_PIN_11
#define M1_PWM_VH_GPIO_Port GPIOE
#define M1_PWM_WH_Pin GPIO_PIN_13
#define M1_PWM_WH_GPIO_Port GPIOE
#define M1_TEMPERATURE_Pin GPIO_PIN_14
#define M1_TEMPERATURE_GPIO_Port GPIOB
#define M1_PWM_WL_Pin GPIO_PIN_15
#define M1_PWM_WL_GPIO_Port GPIOB
#define M1_HALL_H1_Pin GPIO_PIN_12
#define M1_HALL_H1_GPIO_Port GPIOD
#define M1_HALL_H2_Pin GPIO_PIN_13
#define M1_HALL_H2_GPIO_Port GPIOD
#define M1_HALL_H3_Pin GPIO_PIN_14
#define M1_HALL_H3_GPIO_Port GPIOD
#define TMS_Pin GPIO_PIN_13
#define TMS_GPIO_Port GPIOA
#define TCK_Pin GPIO_PIN_14
#define TCK_GPIO_Port GPIOA
#define Start_Stop_Pin GPIO_PIN_10
#define Start_Stop_GPIO_Port GPIOC
#define Start_Stop_EXTI_IRQn EXTI15_10_IRQn
#define UART_TX_Pin GPIO_PIN_3
#define UART_TX_GPIO_Port GPIOB
#define UART_RX_Pin GPIO_PIN_4
#define UART_RX_GPIO_Port GPIOB
