Ahmeddiab1/TRI-MD_EVAL/(notices)

Notices in the files:
1-HARDWARE/1-MD_EVAL/6-CUBEMX/ESC_STM_MOTOR-CTRL/Inc/main.h:
© Copyright (c) 2020 STMicroelectronics.
All rights reserved.
